cgarryZA/deepJFET/paper/CoverPage.tex

\begin{titlepage}
\centering
\vspace*{1cm} % Adds vertical space

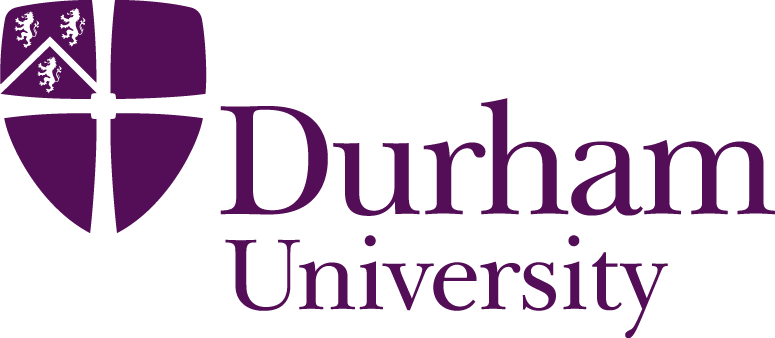
[picture p1: paper/logo.png]
 % Adjust the size as needed

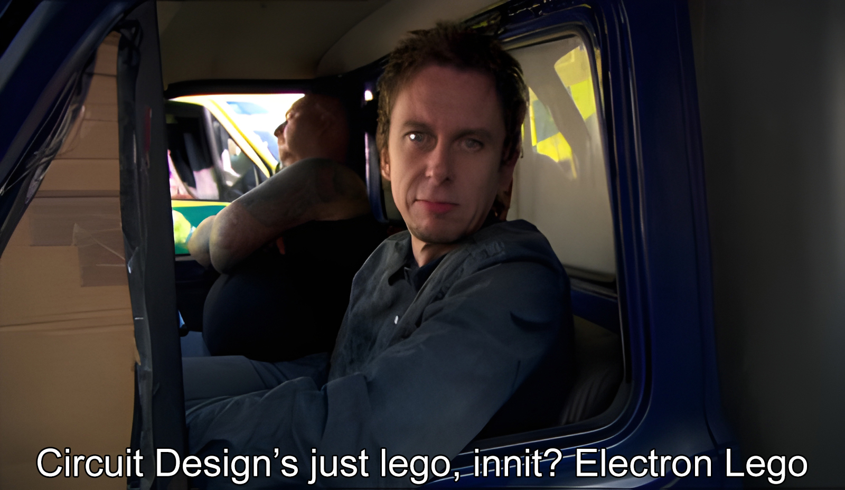
[picture p2: paper/CoverImage.jpg]


\vspace{1cm}

{\Large\bfseries Enduring the Void and Inferno: Computing for Hostile Environments\par} % Title

\vspace{1.5cm} % Space before the author name

{\large Christian Timothy Thomas Garry\par} % Author name

\vspace{1cm} % Space before the degree

{\large Masters Of Engineering (MEng)\par} % Degree

\vspace{1cm} % Space before the university name

{\large University of Durham\par} % University name

\vspace{1cm} % Space before the date

{\large April 2024\par} % Date

\end{titlepage}
