cgarryZA/deepJFET/paper/data/trace_diff_FloatingPoint.tex

% Auto-generated by tools/verify_micro5.py --program FloatingPoint
\begin{table}[t]
\centering
\caption{Direct ISA-rule verification of the LTspice CPU trace for the FloatingPoint program. For every instruction boundary the observed (pre, IR, post) triple is checked against the documented 4004 semantics; \emph{CY artefact} marks failures explained by a one-sample CY-input glitch at the pre-sample point.}
\label{tab:trace-diff-floatingpoint}
\begin{tabular}{@{}lrrrl@{}}
\toprule
Program & Instructions checked & Passing & First failure & End state \\
\midrule
FloatingPoint & 454 & 454 & -- & \textbf{matched} \\
\bottomrule
\end{tabular}
\end{table}
