cgarryZA/deepJFET/paper/data/trace_diff_FloatingPoint_macros.tex

% Auto-generated by tools/verify_micro5.py --program FloatingPoint
\renewcommand{\TraceCyclesFloatingPoint}{454}
\renewcommand{\TraceDivergencesFloatingPoint}{0}
