cgarryZA/deepJFET/paper/data/transistor_count.tex

% Auto-generated by tools/count_transistors.py -- do not edit by hand.
\begin{table}[t]
\centering
\caption{Transistor count of the SiC JFET 4004-compatible processor, per subsystem at full capacity (all sixteen scratch-pad registers and three stack levels included). Numbers are derived directly from the LTspice schematics referenced by \texttt{cpus/4004/config.py}; re-running \texttt{tools/count\_transistors.py} regenerates this table from the current schematic state.}
\label{tab:transistor-count}
\begin{tabular}{@{}lrrr@{}}
\toprule
Subsystem & JFETs & \% of total & Resistors \\
\midrule
Arithmetic logic unit & 566 & 10.2\% & 504 \\
Instruction register & 680 & 12.3\% & 642 \\
Micro-instruction decoder & 877 & 15.8\% & 675 \\
Control logic & 28 & 0.5\% & 24 \\
External pins and bus & 140 & 2.5\% & 159 \\
Program counter & 503 & 9.1\% & 429 \\
Step counter & 363 & 6.6\% & 351 \\
Scratch pad ($16\times 4$-bit) & 1563 & 28.2\% & 1230 \\
Subroutine stack (3-level) & 817 & 14.8\% & 693 \\
\midrule
\textbf{Total} & \textbf{5537} & \textbf{100.0\%} & \textbf{4707} \\
\bottomrule
\end{tabular}
\end{table}
