cgarryZA/deepJFET/paper/data/transistor_count_macros.tex

% Auto-generated by tools/count_transistors.py -- do not edit by hand.
\newcommand{\TotalJFETCount}{5537}
\newcommand{\TotalResistorCount}{4707}
\newcommand{\JFETCountALU}{566}
\newcommand{\ResistorCountALU}{504}
\newcommand{\JFETCountIR}{680}
\newcommand{\ResistorCountIR}{642}
\newcommand{\JFETCountMI}{877}
\newcommand{\ResistorCountMI}{675}
\newcommand{\JFETCountCont}{28}
\newcommand{\ResistorCountCont}{24}
\newcommand{\JFETCountPin}{140}
\newcommand{\ResistorCountPin}{159}
\newcommand{\JFETCountPC}{503}
\newcommand{\ResistorCountPC}{429}
\newcommand{\JFETCountCounter}{363}
\newcommand{\ResistorCountCounter}{351}
\newcommand{\JFETCountScratch}{1563}
\newcommand{\ResistorCountScratch}{1230}
\newcommand{\JFETCountStack}{817}
\newcommand{\ResistorCountStack}{693}
