cgarryZA/deepJFET/paper/supplementary/AppendixA.tex

\begin{figure}[h]
    \centering
    
    \caption{Experimental and simulated NOR gate output voltage at 50 kHz Shifted by 1.5 V. The gate input voltages have been scaled and offset to the top of the diagram.}
    \label{fig:enter-label}
\end{figure}

\begin{figure}[h]
    \centering
    
    \caption{Experimental and simulation NOR gate output voltage at 400 kHz Shifted by 1.5 V. The gate input voltages have been scaled and offset to the top of the diagram.}
    \label{fig:enter-label}
\end{figure}

\begin{figure}[h]
    \centering
    
    \caption{Experimental and simulation NOR gate output voltage at 800 kHz Shifted by 1.5 V. The gate input voltages have been scaled and offset to the top of the diagram.}
    \label{fig:enter-label}
\end{figure}

\begin{figure}[h]
    \centering
    
    \caption{Experimental and simulation NAND gate output voltage at 2 Hz Shifted by 1.5 V. The gate input voltages have been scaled and offset to the top of the diagram.}
    \label{fig:enter-label}
\end{figure}

\begin{figure}[h]
    \centering
    
    \caption{Experimental and simulation NAND gate output voltage at 400 kHz Shifted by 2 V. The gate input voltages have been scaled and offset to the top of the diagram.}
    \label{fig:enter-label}
\end{figure}

\begin{figure}[h]
    \centering
    
    \caption{Experimental and simulation NAND gate output voltage at 1 MHz Shifted by 2 V. The gate input voltages have been scaled and offset to the top of the diagram.}
    \label{fig:enter-label}
\end{figure}
