cgarryZA/deepJFET/paper/supplementary/AppendixD.tex

Full page circuit diagrams of CPU sub-systems as described in \ref{CPUDes}.
\begin{figure*}
    \centering
    
    \caption{Circuit diagram of the arithmetic logic unit}
    \label{fig:enter-label}
\end{figure*}

\clearpage
\begin{figure*}
    \centering
    
    \caption{Circuit diagram of the Instruction Register}
    \label{fig:enter-label}
\end{figure*}

\clearpage
\begin{figure}
    \centering
    
    \caption{Circuit diagram of the Step Counter}
    \label{fig:enter-label}
\end{figure}

\begin{figure}
    \centering
    
    \caption{Circuit diagram of the Program Counter}
    \label{fig:enter-label}
\end{figure}

\clearpage
\begin{figure*}
    \centering
    
    \caption{Circuit diagram of the Stack}
    \label{fig:enter-label}
\end{figure*}

\clearpage
\begin{figure*}
    \centering
    
    \caption{Circuit diagram of the Scratch Pad}
    \label{fig:enter-label}
\end{figure*}

\clearpage
\begin{figure*}
    \centering
    
    \caption{Circuit diagram of the Pins}
    \label{fig:enter-label}
\end{figure*}

\clearpage
\begin{figure*}
    \centering
    
    \caption{Circuit diagram of the computational part of the ROM}
    \label{fig:enter-label}
\end{figure*}
