cgarryZA/deepJFET/paper/precedent/MEng_FYP.pdf

> M.ENG RESEARCH PROJECT APRIL 2024 < | 1

# Enduring the Void and Inferno: Computing for Hostile Environments

## Christian Garry supervised by Professor Alton Horsfall

Abstract—The aim of this paper was to investigate the use of Silicon Carbide Junction Field Effect Transistors to produce radiation resistant computers that can operate at temperatures exceeding 500 ◦C. This is the first demonstration of a full 4-bit microprocessor in Silicon Carbide. The architecture was based on the Intel 4004. The device was designed to be as close to the original Intel 4004 in functionality as possible and use the same instruction set. The aim was for programs written for the Intel 4004 to be able to run without changes to the code. The device was simulated using LTSpice along with other supporting software. The simulated device was able to run complex programs such as multiplying two 16-bit floating point numbers. Physical logic gates were built following circuit diagrams from this report and compared to the simulated results with good agreement in overall waveform shape leading to confidence in the simulated results produced by the CPU as a whole.

Index Terms—Silicon Carbide (SiC), Junction Field Effect Transistors (JFETs), Radiation-Resistant Computers, High-Temperature Electronics, Intel 4004 Architecture, Circuit Simulation, Logic Gates

I. INTRODUCTION
T

HE Intel 4004 microprocessor, recognised as the first general-purpose programmable processor, marked a significant milestone in the development of modern computing. This CPU is characterised by its simplicity: it features sixteen 4-bit working memory locations, known as the Scratch Pad, and two arithmetic logic unit (ALU) registers, the Accumulator and Temporary Registers. The 4004 has a limited instruction set of only 46 instructions [1]. The ALU can only perform addition and bit shifts left or right, subtraction is performed by taking the 2’s complement of the temporary register before it is added to the accumulator. The 4004 has a 3-level stack allowing subroutines up to 3 layers deep. The 4004 also has some conditional jump logic allowing for loops and some basic iterative routines. The program counter is 12 bits, the first 4 indicate the read only memory (ROM) chip (Intel 4001) that has been selected and the next 8 bits indicate the address in that specific chip. This means that each 4001 is 256x8 bits [2] and the 4004 can natively address 16 distinct ROMs. The 4004 also has 4 memory control (CM-RAM) pins which are used to address a specific random-access memory (RAM) chip (Intel 4002). Unlike the ROM, each CM-RAM pin is dedicated to one RAM chip as the RAM only has 1 CM-RAM pin [2]. This can be increased by using a 4-to-16 decoder between the 4004 and RAM chips, allowing full use of the address space. For devices to operate at temperatures greater than 400 ◦C a larger bandgap is needed compared to room temperature devices. Standard devices use Silicon which has a bandgap of 1.12 eV [3]. Silicon Carbide (SiC) is being investigated as it has a much larger bandgap than Silicon, 6H-SiC has a bandgap of 2.9 eV and 4H-SiC has a bandgap of 3.26 eV [4]. A further strength of Silicon Carbide as a material compared to Silicon is its increased radiation-hardness. SiC has a high threshold energy for atomic displacement (24 eV for C and 66 eV for Si [5], compared to 21 eV in Si [6] and 50 eV for diamond [7]). The charge collection efficiency (CCE) of n-type SiC Schottky barrier diodes has been measured and shows no deviation from linear behavior if irradiated with protons [8], electrons [9], or other light ions [10]. This makes SiC eminently suitable for a variety of applications such as fusion reactors or for off-world environments.
JFETs are being investigated since they use a buried p-n junction and not a Schottky barrier. This is important because a metal/semiconductor interface, as found in metal semiconductor field effect transistors (MESFET), degrades at elevated temperatures making them unsuitable for extreme conditions [11]. SiC JFETs have been shown to operate at above 600 ◦C
[12] with the main degradation being interdiffusion of the metal ohmic contacts. These JFETs use a buried gate struc-ture, however this leads to excess access resistance and gate capacitance which limits the applications in several ways. This means that brand new logic gate designs must be created to utilise these JFETs optimally. Logic gates built from SiC JFET devices have been shown to operate at 600 ◦C. The limits of these devices currently are not the wafer itself but the ohmic contacts which are subject to degradation [13]. It is difficult to test improvements as the probes used to electrically test the devices are themselves degrading at these temperatures. Complimentary JFET (CJFET) logic gates have been tested at 623 K [14]. The graphs show degradation of the output voltage at higher temperatures and that the output voltage swing is less than the input voltage swing. This has the potential to cascade when used as an input to a further logic gate, until the output voltage is not recognised reliably as a high or low signal. CJFET 4H-SiC logic gates have been simulated [15]. The data from these simulations indicates that the noise threshold increases as temperature increases, however, the propagation delay is much lower at higher temperatures, 50 ns compared to 10 ns at 1.75 V supply voltage for 27 ◦C and 500 ◦C respectively. The data also indicates that the maximum switching frequency increases as temperature increases going from 2 MHz to 10 MHz. However, the logic gates in this paper utilise resistor-transistor logic (RTL) rather than CJFET logic. This is because CJFET logic requires both p-type and n-type transistors in order to build gates. Due to only using n-type JFETs, RTL had to be used over the more commonly used complimentary logic. This does however suit the project well as the original Intel 4004 also used RTL.
This paper describes the most complex digital circuit built from SiC JFETs and is organized as follows. Section II, describes the basic information of the logic primitives and the decomposition of the 4004 into smaller sub-systems. Section III, describes the design method used to build the circuits for these sub-systems and the testing process used to validate them. The results of the simulated programs and physical logic gates built in the lab are presented in Sec. IV. Finally, Sec.V concludes this paper with a discussion of key findings and directions for future research.

II. THEORY

A. Logic Primitives
The LTSpice model of the JFET was used to create a logic primitive. This was extended to form more complex Logic Gates. Applying a voltage to the Gate of a JFET causes the depletion region to increase. This narrows the conducting channel increasing the resistance, which decreases the current that can pass through it. If the source of the JFET is connected to a voltage source through a resistor there will then be a change in voltage at the JFET’s source when a voltage is applied to the Gate. This does not provide a large enough voltage swing between high and low and has implications for the fan out of the gate. Therefore, a voltage follower was used which works as a voltage level shifter and shifts the output voltage back to input levels of the logic gate (High: -0.8 V, Low: -3.6 V). These values were selected as they kept the output voltage from decaying or oscillating when used as inputs for subsequent gates whilst using standard resistor values.
The design of more complex gates follows on logically from this (Figure 1). To design the NOR gate a second JFET can be connected to the voltage follower in parallel with the first JFET which provides two inputs both with equal function. This means that if either JFET has a voltage applied, the output of the logic gate is the same. The NAND gate was developed using similar reasoning. If both inputs are required to be on to turn the output off, connecting two JFETs in series to the voltage follower will require that both JFETs are sinking current for the output to change. Condensed boolean gates are gates that have an entire Boolean expression compressed into a single gate in order to optimise the number of transistors

VDD

VSS

A

_A

VDD

VSS

A

!(A • B)

B

VDD

VSS

A

!(A + B)

B

Fig. 1: Circuit diagrams of NOT, NAND, and NOR gates respectively

VDD

VSS

A

!((A•B)+C)

B

C

VDD

VSS

!((A•B)+C)

C

VDD

VSS

A

B

Fig. 2: Circuit diagram of a condensed boolean gate (Left) and a combination of base gates (Right), illustrating the transistor reduction for the boolean equation (A AND B) NOR C

used (Figure 2). For example having a NOR gate but with one of the NOR input JFETs having a second JFET between it and ground provides the same effect as having (A AND B) NOR C whilst saving two JFETs. This was common in integrated circuits in the past [16].
NAND and NOR gates were built in the lab and compared to the simulated devices. They were characterised from 1 Hz up to a maximum of 1 MHz. The results were found to mostly agree with the simulations, showing some differences in voltage levels. These results will be discussed further in Sec. IV.
B. CPU Design

The Intel 4004 can be decomposed into several distinct sub-systems. The arithmetic logic unit (ALU), the instruction register and decoding, the stack and program counter (PC), the Scratch Pad, and the circuits related to the pins and interfacing with other external components. The specific instructions re-lating to each sub-system were evaluated in detail to precisely match the functionality of the original Intel 4004.
1) ALU: From the architecture diagram (Figure 3) it can be seen that the ALU (Figure 4) has two 4-bit registers connected to it, the Accumulator (Acc) and the Temporary (Temp) register. From the instruction set it can be seen that the ALU consists only of a 4-bit adder. The contents of the accumulator can also be shifted to the left or right by one bit, however it also includes the carry flag in this shift operation. For example, shifting right would place the least significant bit of the accumulator into the carry and what was in the carry into the most significant bit of the accumulator. Based on the instruction set it can be deduced that there is no inverter on the accumulator and that for subtraction and the other inversion instructions, for example complement accumulator (CMA), there must be an inverter between the temporary register and its connections to the bus and adder. CMA is then accomplished by transferring the value from the Accumulator to the Temp register, inverting the Temp register and transferring this inverted value back to the Accumulator. The carry flag also needs to be able to be inverted. There is a separate incrementer circuit which adds one to the temporary register. This is because the instruction Increment (INC), increments the value stored in a specific Scratch Pad register without effecting the accumulator or the carry flag of the

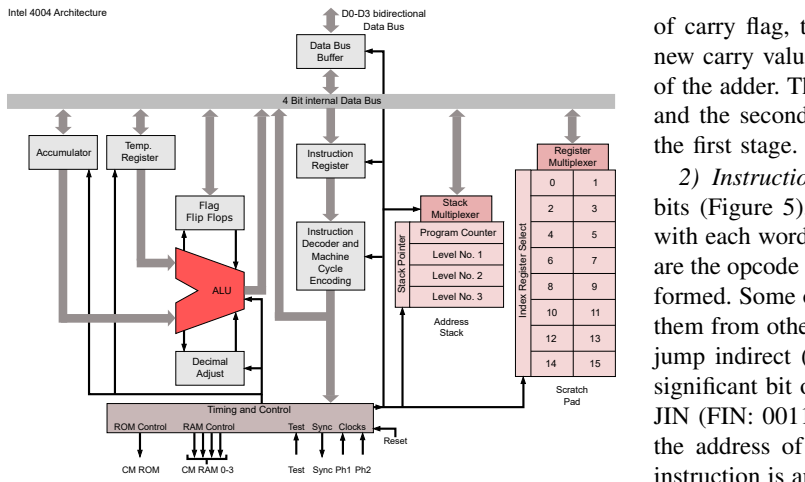
[picture p16: figure]
Instruction Register; Accumulator; Temp.; Register; Flag Flip Flops; Data Bus Buffer; ALU; Decimal Adjust; Instruction Decoder and Machine Cycle Encoding; Register Multiplexer; Index Register Select; Program Counter; Level No. 1; Level No. 2; Level No. 3; Stack Pointer; Stack Multiplexer; Timing and Control; ROM Control; RAM Control; Reset; Test Sync Clocks; CM ROM; CM RAM 0-3; Test Sync Ph1 Ph2; Address Stack; Scratch Pad; 4 Bit internal Data Bus; Intel 4004 Architecture; D0-D3 bidirectional; Data Bus; the first stage.

Fig. 3: Architecture of the Intel 4004 [17] showing the layout of registers and connections between CPU sub-systems

ALU. There is not enough time in the execute portion of the instruction cycle for the accumulator value to be moved to some intermediate location to be moved back after the increment instruction is completed. This means that there has to be a separate circuit for incrementing Scratch Pad registers. There was a race condition caused by the carry and accumulator not saving their new values at the same time. This lead to a scenario where the sum was saved to the accumulator, passed through the adder again and updated the carry before the signal to save to the carry went low. This resulted in uncertainty as to whether or not the value saved in the carry register was that of the original sum operation or the carry from the sum output added to the temporary register again. This issue also occurred if the carry was saved first leading to the sum output being unreliable. The solution to this was to have two stages

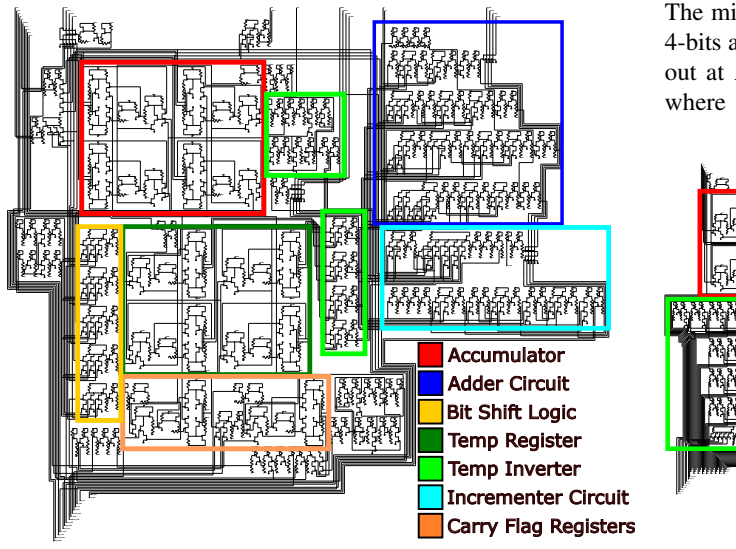
[picture p17: figure]
VDD; VSS; Temp_INV; VDD VDD VDD; Acc_Load; Acc_Out; CF_Out; Temp_Load; CF_Bus_Load; CFStage1_Load; Shift_Enable; Shift_Direction; CF_Load; Temp_Out; CF_INV; CF_Clear; EO_Out; ISZ_False; ISZ_True; Inc_Out; Bus3; Bus2; Bus1; Bus0; Bus3In; Bus2In; Bus1In; Bus0In; Acc9; !Acc9; CLK; TestPin; !2Acc; 2Acc; Adder Circuit; Accumulator; Temp Register; Carry Flag Registers; Bit Shift Logic; Temp Inverter Incrementer Circuit; IR1_Load; IR2_Out; IR4_Load; BBL; IR2_Load; IR3_Out; IR3_Load; IR4_Out; LDM; RAMSignals; NOP; JCN; FIM; FIN; JIN; SRC; JUN; JMS; INC; ISZ; ADD; SUB; XCH; ControlSignals; IAC; CMC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

Fig. 4: Circuit diagram for the Arithmetic and Logic Unit with colour-coded sub-circuits

of carry flag, the first flip-flop would be loaded to store the new carry value without effecting the value seen on the input of the adder. Then the sum could be stored to the accumulator and the second stage of the carry flag could be loaded from

2) Instructions: The instruction register of the 4004 is 16-bits (Figure 5). Instructions can be either one or two words, with each word being 8-bits. The first 4-bits of any instruction are the opcode which specifies the instruction that is being performed. Some opcodes require the second 4-bits to distinguish them from other opcodes. For example the difference between jump indirect (JIN) and fetch indirect (FIN) is that the least significant bit of the lower first word is a 0 for FIN and 1 for JIN (FIN: 0011 RRR0, JIN: 0011 RRR1, where R represents the address of a Scratch Pad register pair). The rest of the instruction is an operand which specifies either the data or the location for the instruction to act upon. The most significant 8-bits must therefore be de-multiplexed to create a control signal telling the CPU which instruction is being executed. The CPU executes instructions by activating sub-system control lines in a specific order. This means the CPU needs to know both what step it is on in the instruction and what control lines need to be activated for each step. The list of control lines that need to be activated on each clock cycle are known as micro-instructions (Figure 6). This is done using a micro-instruction step counter (Figure 7) and an AND gate for each step of each instruction. These will only have a logical high output when the CPU is executing that particular instruction and is on that specific step, allowing the CPU to execute the micro-instructions in the correct sequence to correctly perform the functionality required by the instruction. The micro-instruction steps are broken down into distinct phases. A1, A2, and A3 are the first step of the fetch portion of the fetch, decode, execute cycle. This is when the address is sent from the CPU onto the external bus for any chips connected to it to read. The order in which the address is sent out is important as the ROM and RAM will expect a certain format for the address. The middle order 4-bits are sent out at time A1, the low order 4-bits are sent out at time A2 and the high order 4-bits are sent out at A3. The next step of the fetch portion is M1 and M2 where the CPU receives back 8-bits of data from the ROM.

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
VDD | VDD
VSS | VSS

Jumping

VDD

VSS

!2Word

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
VDD | VDD
VSS | VSS

VDD

VSS

VDD | VDD
VSS | VSS
VDD | VDD
VSS | VSS
VDD | VDD
VSS | VSS
VDD | VDD
VSS | VSS
VDD | VDD
VSS | VSS
VDD | VDD
VSS | VSS
VDD | VDD
VSS | VSS
VDD | VDD
VSS | VSS
VDD | VDD
VSS | VSS

VDD

VSS

VDD | VDD
VSS | VSS
VDD | VDD
VSS | VSS

CLB

VDD | VDD
VSS | VSS
VDD | VDD
VSS | VSS

CLC

VDD | VDD
VSS | VSS
VDD | VDD
VSS | VSS
VDD | VDD
VSS | VSS
VDD | VDD
VSS | VSS
VDD | VDD
VSS | VSS
VDD | VDD
VSS | VSS
VDD | VDD
VSS | VSS
VDD | VDD
VSS | VSS
VDD | VDD
VSS | VSS
VDD | VDD
VSS | VSS
VDD | VDD
VSS | VSS
VDD | VDD
VSS | VSS
VDD | VDD
VSS | VSS
VDD | VDD
VSS | VSS
VDD | VDD
VSS | VSS
VDD | VDD
VSS | VSS
VDD | VDD
VSS | VSS
VDD | VDD
VSS | VSS
VDD | VDD
VSS | VSS
VDD | VDD
VSS | VSS
VDD | VDD
VSS | VSS
VDD | VDD
VSS | VSS
VDD | VDD
VSS | VSS
VDD | VDD
VSS | VSS
VDD | VDD
VSS | VSS
VDD | VDD
VSS | VSS
VDD | VDD | VDD
VSS | VSS
VDD | VDD
VSS | VSS
VDD | VDD
VSS | VSS

WR

VDD | VDD
VSS | VSS

RD

VDD | VDD
VSS | VSS

Bus3
Bus2
Bus1
Bus0

Bus3
Bus2
Bus1
Bus0

Bus3
Bus2
Bus1
Bus0

!CF

CF

AN

AZ

!TestPin

TestPin

Bus3In
Bus2In
Bus1In
Bus0In

Bus3In
Bus2In
Bus1In
Bus0In

Bus3In
Bus2In
Bus1In
Bus0In

Instruction Registers 1-4

IR Multiplexers
Instruction Decoders

Fig. 5: Circuit diagram for the Instruction Register with colour-coded sub-circuits

ADD Instruction

Output
Instruction
Register
2 to the
Bus
Load
ScratchPad
Index Reg
from the
Bus

Output
ScratchPad
Addressed
to the
Bus
Load
Temporary
Register
from the
Bus

Output
Adder Sum
to the
Bus

Load
Acc
Register
from the
Bus

Increment
Program
Counter

Reset
Micro
Instruction
Step
Counter
Address
ScratchPad
Individually
using low
order bit

Load
Second
Stage of
Carry
X1 | X2 | X3

Fig. 6: Diagram showing the control lines that need to be activated per step to execute the ADD instruction

The Intel 4001, in order to decrease complexity and therefore transistor count, has no way to store 16-bit instructions in one ROM address. After the first 8-bits are received from the ROM, if an instruction is detected that requires a further 8-bits of data there is a flip-flop on the CPU that is toggled and the program counter is incremented. The flip-flop being toggled means that when the CPU goes through the next fetch cycle (A1,2,3, M1,2) it will place the new values into the lower word of the instruction register. The CPU then has all 16-bits stored in the instruction register ready to execute. The execute portion is denoted as X1, X2, and X3. This is where the instruction is executed by manipulating the control lines of the CPU.
3) Program Counter and Stack: The Program Counter (PC) (Figure 8) consists of a 12-bit register and an incrementing circuit. The PC also needs to be able to write values to and from the Bus. The conditional jump (JCN) instruction indicates that each 4-bits in the PC need to be individually controlled as the high order 4-bits are not changed when JCN is performed. The limit of three micro-instruction steps for executing instructions means that the stack (Figure 9) has to have a direct connection to the PC as all 12-bits need to be written, along with additional steps related to the stack level control, within three clock pulses. This is not possible with the 4-bit bus unless the PC and Stack have a direct connection. The stack is three layers deep and needs to keep track of which level it is on. This is done using a shift register which is able to be shifted up and down to select each level. The output of each register of the stack is fed into an AND gate along with the level control line that corresponds to it so that the register only outputs when its level is selected and the "Output Stack" control line is enabled.
4) Scratch Pad: The 4004 has sixteen 4-bit registers it can use as general purpose memory. This is so that it is able to perform basic functions without the need for any external Micro_Reset

VDD

VSS

VDD | VDD
VSS | VSS
VDD | VDD
VSS | VSS

VDD

VSS

VDD | VSS | VDD | VSS | VDD | VSS | VDD | VSS | VDD | VSS | VDD | VSS | VDD | VSS | VDD | VSS | VDD | VSS

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

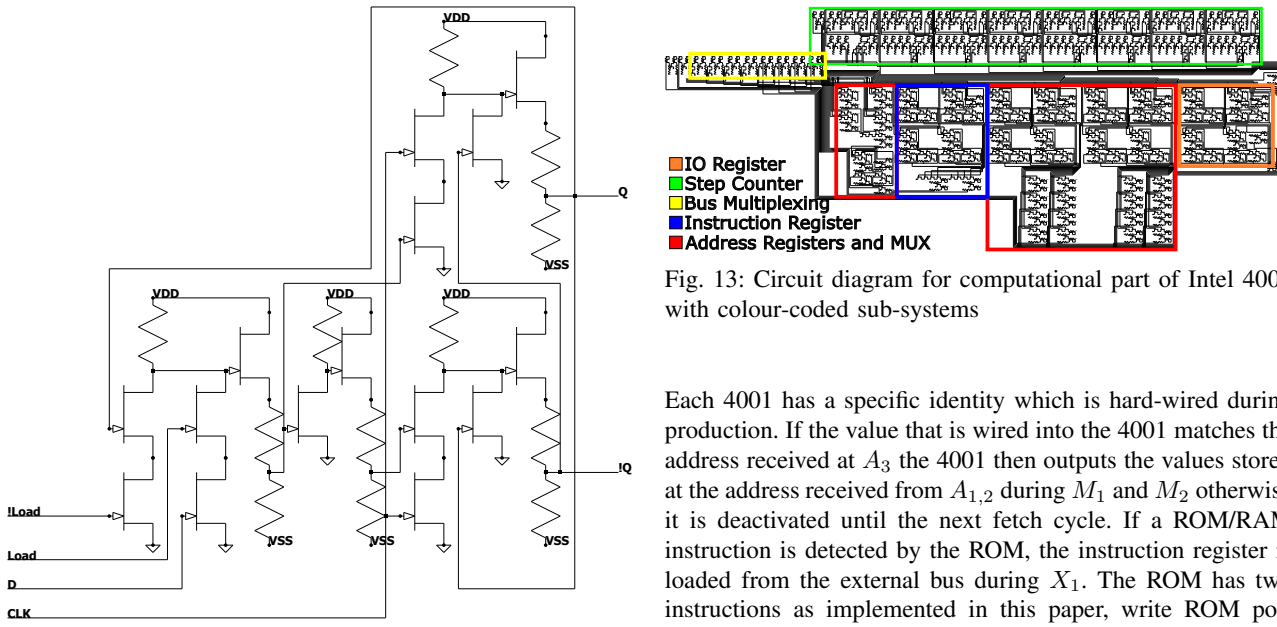
[picture p18: figure]
VDD; VSS; Load; !Load; CLK; VDD VSS VDD VSS; VDD VSS VSS; VDD VDD VSS VSS; VDD VSS; ROM_Mid1_3; ROM_Mid1_2; ROM_Mid1_1; ROM_Mid1_0; Address Registers and MUX; Step Counter; IO Register; Instruction Register; Bus Multiplexing; with colour-coded sub-systems

Fig. 12: Circuit diagram for synchronous D-type flip-flop with transistor reductions using combined boolean logic gates

order to decrease simulation times. The system was tested using the following method. Each control line was connected to a voltage source utilising a Piecewise linear (PWL) file. A PWL file is a type of file used by LTSpice which specifies the voltage at specific time points. Each control line was listed in a spreadsheet along with register values if appropriate. The necessary voltage level for each control line was then plotted on a timeline to "program" the circuit to perform operations. The PWL files were then generated using Matlab from the list of times the control line needed to be high. The final state of the sub-system could then be compared to the expected state calculated from the spreadsheet. Once each sub-system had been verified as correctly functioning they were assembled into the full CPU by means of a Python script which collated each sub-system and renamed any duplicated component names. This was then tested by connecting the Bus to voltage sources and emulating the ROM by feeding it data when it expected to receive data from the ROM. This allowed the majority of the testing to be completed but did not allow for testing more complex programs or anything that required a "decision" to be made by the CPU as every bit of data received by the CPU had to be hard-coded beforehand.

A. ROM
In order to fully test the capabilities of this CPU it was decided that a ROM needed to be designed and built (Figure 13). The 4001 functions in a similar way to the 4004. It uses a micro-instruction counter to see where it is in the instruction cycle and also has an instruction register which is used for some ROM specific instructions. The ROM receives an address from the CPU at times A1 and A2. It then receives a chip select address at time A3, which determines which of the 4001 chips is being addressed, along with CM-ROM going high.

VDD

VDD

VSS

VSS

D2 D0 D1 | High Low High Low VSS VDD | LowHigh LowHigh VSS VSS | VDD VDD VSS VDD VSS VDD | VDD VSS VSS | VSS | VDD VDD VDD VSS VSS VDD | VDD VSS VSS | VDD VSS VDD VDD | VDD VSS VSS | VSS VSS | VDD VDD VSS VDD VDD | VDD VSS VSS | VSS VSS | VDD VDD VSS VDD VDD
VSS | VSS VDD VDD VDD VSS VDD VSS VSS | VDD VDD VDD VSS VSS | VDD VDD VDD VSS VSS | VDD VDD VDD VSS VSS | VDD VDD VDD VSS VSS | VDD VDD VDD VSS VSS | VDD VDD VDD VSS VSS | VDD VDD VDD VSS VSS | VDD

VDD

VDD

D3In
D2In
D1In
D0In

ROM_High_1ROM_High_0 ROM_High_3ROM_High_2

ROM_Mid2_1ROM_Mid2_0 ROM_Mid2_3ROM_Mid2_2 | ROM_Low_1ROM_Low_0 ROM_Low_3ROM_Low_2

Micro8

Micro7

Micro6

Micro5

Micro4

Micro3

Micro2

Micro1

Fig. 13: Circuit diagram for computational part of Intel 4001

Each 4001 has a specific identity which is hard-wired during production. If the value that is wired into the 4001 matches the address received at A3 the 4001 then outputs the values stored at the address received from A1,2 during M1 and M2 otherwise it is deactivated until the next fetch cycle. If a ROM/RAM instruction is detected by the ROM, the instruction register is loaded from the external bus during X1. The ROM has two instructions as implemented in this paper, write ROM port (WRR) and read ROM port (RDR) which are used to read and write to the I/O pins on the ROM chip. This is performed during X2 unless no instruction was received during X1 in which case the execution cycle is reset ready for the next address to be received. Storage in the ROM was implemented using a voltage source linked to a PWL file for each bit of every address. When the ROM is addressed the value defined by the PWL file for that address is sent out onto the bus. This was done so that each bit would have a specific PWL file which could be written to, allowing for the ROM to be programmed.

B. Assembler

An assembler converts the mnemonics of the instructions from text to binary and converts the operands from hexadeci-mal or decimal to binary. So FIM 1 0 11 would be converted to 0010 0010 0000 1011. An assembler also handles labels which are used for jumps. When the code comes across text that does not correspond to a known instruction it adds it to the dictionary along with the line that the assembler was on when the unknown text was encountered. Then, once the entire program has been read for a first time, the code makes a second pass. During this second pass every instance of a label is replaced with the binary value of its location in the program, essentially acting as pointers to a specific line in the program. The assembled program is saved as a .bin file and a .hex file. The .bin file is formatted so that each line has 8-bits, which corresponds to the 8-bits that the ROM stores per address. Each line then refers to a specific address in the ROM. The assembler was written in Python.

C. PWL File Generation

The .bin file is used by another python script to generate the PWL files that populate the voltage sources of the ROM. The first bit in the .bin file is read, if it is a 1 the PWL file will have a logical high voltage, if it is a 0 it will have a

Clock Cycles; cim; al Valu

Fig. 14: Figure showing the decimal value in Scratch Pad Register 0 for the operation 11 & 6. This illustrates the first input (11) being shifted left 4 times to compare the highest order bit to the second input (6) with the final result of 2 being loaded in just before 1500 clock cycles

logical low output. The first bit will be saved as 0.txt, bit two will be 1.txt etc. The format of these files is as follows, for logical high: "0u -800m", and for logical low: "0u -3.6". This sets the voltage source to a value of either -0.8 V or -3.6 V permanently unless the text file is changed.

D. Testing and Benchmarking
With a full 4001 and 4004, more complex programs could be run and the outputs of these programs compared between the LTSpice simulated CPU and the CPU that was emulated using JavaScript. One of the programs built was a floating point emulator which allowed the multiplication of a custom implementation of 16-bit floats (Listing 3). This was chosen to allow for astronomical calculations which require a large range of values. Another program that was run was pulled from a contemporary Intel 4004 programming manual [1] and was used for the purpose of performing a logical AND operation. This was able to run without any modifications which is a good indication that the high-level functionality has parity with the original CPU (Figure 14). The results of these computations are discussed further in Section IV.
1) Waveform Value Interpreter: In order to streamline the process of examining the waveform data of the LTSpice simulations on lengthy computations, software was written which extracts the voltage values and processes them. Matlab was used to read through the entire waveform file and search for specific nodes. These nodes were then converted from analogue to digital based on if the voltage was above or below -2.6 V. This was done looking at the average voltage in 5 µs time steps as this is the length of time that the clock is high at 100 kHz. These nodes were then combined into 4-bit numbers, if appropriate, giving each register a 4-bit binary number for each time step.
2) Emulator: An online emulator [18] was referenced during the development of the CPU where quirks such as the incrementer not effecting the accumulator were spotted. However, this emulator had some oversights which were corrected and a version of the emulator which more closely matched the internal architecture of the CPU built in LTSpice was created using HTML and JavaScript. Most of the issues were related to the decoding of instructions and specific jump conditions that

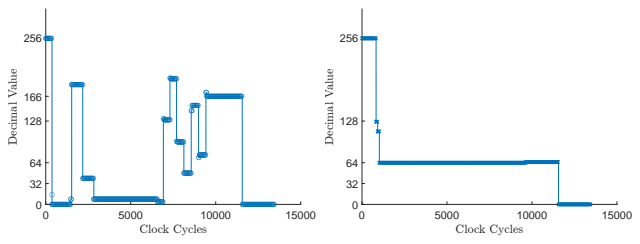
[picture p19: figure]
Clock Cycles; cim; al Valu

(a) Significand which is calculated to be 166 in decimal
(b) Exponent which is calculated to be 65 in decimal

Fig. 15: The waveforms of the registers during the computation of the product of 1.4375 × 3.60937. Plots 15a and 15b show the values of the significand and exponent respectively during the operation

were improperly implemented. A second version of this site was made where the JavaScript for the emulation was removed and the interface was filled with values from the Matlab Waveform Value Interpreter script. This allowed the Emulator and the LTspice model to be compared at every register, step by step for long computations to ensure operational parity.

E. Experimental Validation of Simulation Models
The first two logic gates built using physical JFETs were the NAND and the NOR gate. These were built using a JFET integrated circuit (IC) and a copper circuit board with through-hole components. These were connected to a power supply, a function generator, and an oscilloscope. They were then tested at a range of frequencies from 1 Hz to 1 MHz. The data from this experiment was then used to characterise the gates. The inputs from the function generator were taken and a Matlab script was written to convert these into a PWL file which could then be used as the inputs for the simulated gates to get an exact comparison between experimental and theoretical.

IV. RESULTS AND DISCUSSION

A. Program Testing
1) AND Subroutine: From the MCS4 programming manual an AND sub-routine (Listing 4) was run on the CPU and its results compared to the emulator. Figure 14 shows the functioning of the AND sub-routine. The input A, 1011 (11), is loaded into Scratch Pad register 0 and subsequently shifted left to extract the highest order bit into the carry. This is done four times, from 1011 (11) to 0110 (6) to 1100 (12) to 1000 (8) and the final output value, 0010 (2), is loaded in after roughly 1400 clock cycles. The value starts at 15 as each register defaults to being high when the CPU is first initialised. From the plots we can see that 6 (0110) AND 11 (1011) gives an output of 2 (0010) which is correct.
2) Floating Point Multiplication Subroutine: The floating point system implemented takes the following form.

−1 × signbit × 1.sssssss × 2

eeeeeee−63 | (1)

Where s is a bit of the significand and e is a bit of the exponent. The power of the CPU is demonstrated in the following plots showing the computation 1.4375×3.609375 = 5.18847.

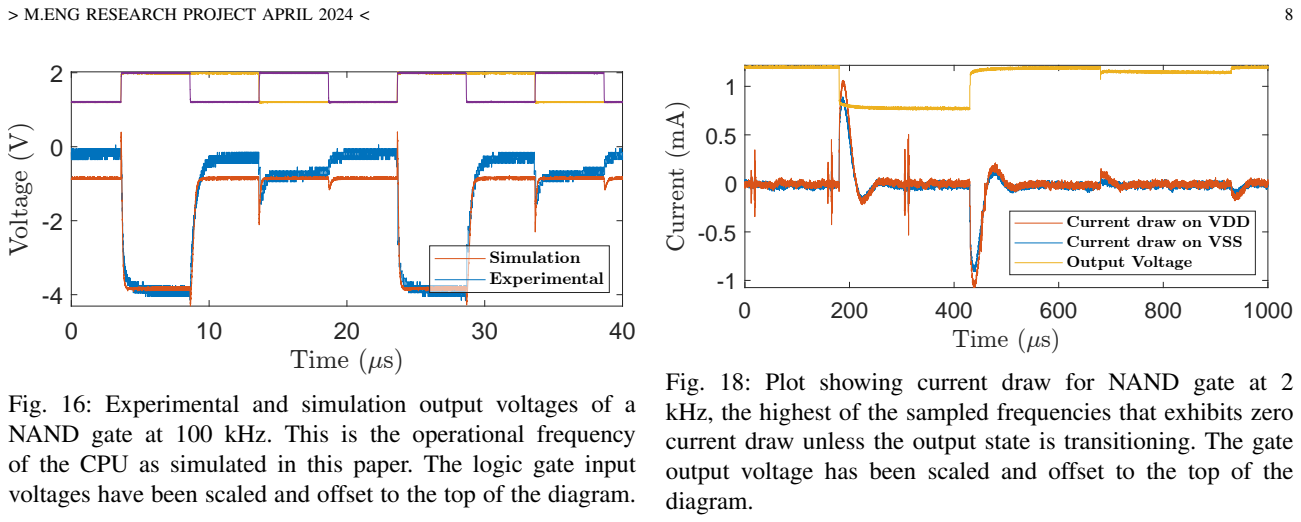
[picture p20: figure]
Time (7s); Volt; Simulation Experimental; Current draw on VDD Current draw on VSS Output Voltage; diagram.

Fig. 16: Experimental and simulation output voltages of a NAND gate at 100 kHz. This is the operational frequency of the CPU as simulated in this paper. The logic gate input voltages have been scaled and offset to the top of the diagram.

Due to limitations in the accuracy of the floating point representation of the numbers they are rounded slightly from their exact values. This is shown in Table I, where the value for the product is rounded from 5.18847 to 5.1875. The majority of the rounding in the multiplication comes from the floating point implementation itself as effort was put into retaining as much accuracy as possible in the algorithm. Explanations of the algorithm can be found in Appendix B. The final values in the registers in Figures 15a and 15b being zero is due to an LTSpice simulation error which occurred after the program had finished running.

B. Experimental Data

The logic gates were tested at a range of input frequencies up to 800 kHz and 1 MHz for the NOR and NAND gate respectively. The key results are at 100 kHz (Figures 16 and
17) and the maximum tested frequency (Figures 21 and 20). These results are important as the CPU was tested at 100 kHz allowing confidence in results obtained from the simulations. The data from the operation at higher frequencies allows predictions about the theoretical top speed of the CPU. The limiting factor is the NOR gate, after 800 kHz the swing of
0 | 10 | 20 | 30 | 40
| | Time (7s)

-6

-4

-2

0

2

Volt

a

g

e (V)

Simulation
Experimental

Fig. 17: Experimental and simulation output voltages of a NOR gate at 100 kHz. This is the operational frequency of the CPU as simulated in this paper. The logic gate input voltages have been scaled and offset to the top of the diagram.

Fig. 18: Plot showing current draw for NAND gate at 2 kHz, the highest of the sampled frequencies that exhibits zero current draw unless the output state is transitioning. The gate output voltage has been scaled and offset to the top of the

TABLE I: Floating Point Number Values Used in Subroutine

Binary | Decimal | Exponential Form | Value
10111000 00111111 | 184 63 | 1.4375 × 2
| | 0 | 1.4375
11100111 01000000 | 231 64 | 1.8046875 × 2
| | 1 | 3.609375
10100110 01000001 | 166 65 | 1.296875 × 2
| | 2 | 5.1875

TABLE II: Register values for Figures 15a and 15b

Clock Cycle | Significand | Exponent | Decimal
0 | 255 | 255 | 1.9921875 × −2

64
370 | 0 | 255 | 0
828 | 0 | 127 | 0
924 | 0 | 112 | 0
1020 | 0 | 64 | 0
1527 | 184 | 64 | 2.875
2178 | 40 | 64 | 0.625
2830 | 8 | 64 | 0.125
6580 | 4 | 64 | 0.0625
6968 | 130 | 64 | 2.03125
7356 | 193 | 64 | 3.015625
7744 | 96 | 64 | 1.5
8128 | 48 | 64 | 0.75
8608 | 152 | 64 | 2.375
9039 | 76 | 64 | 1.1875
9472 | 166 | 64 | 2.59375
9640 | 166 | 65 | 5.1875
0 | 10 | 20 | 30 | 40
| | Time (7s)

-0.5

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
t (m

A)

Current draw on VDD
Current draw on VSS
Output Voltage

Fig. 19: Plot showing current draw for NAND gate at 100 kHz. This is the operational frequency of the CPU as simulated in this paper and shows that the device will always draw current regardless of input states at these frequencies. The gate output voltage has been scaled and offset to the top of the diagram.

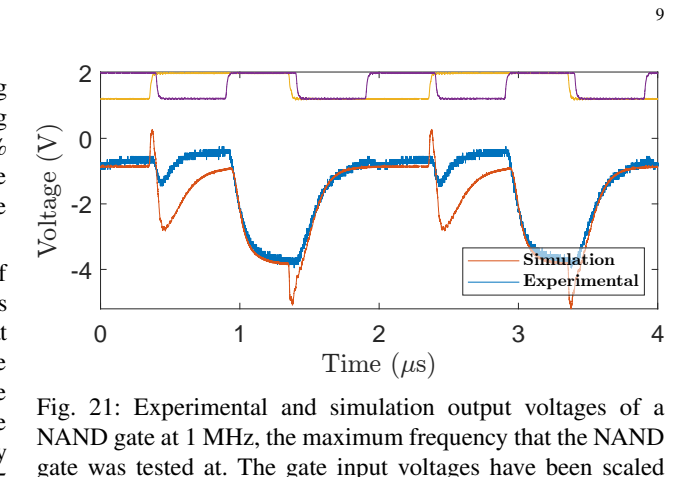
[picture p21: figure]
Time (7s); Volt; Simulation Experimental

the output voltage becomes too slow to react to the changing inputs. This means that a theoretical maximum operating frequency of the CPU can be set at 800 kHz. This is an 8% increase compared to the original 4004 (some sources have the clock speed of the original at 400 kHz which would make this CPU two times faster).
The oscilloscope probes introduced scaling by a factor of two, necessitating post-experimental adjustments. There was a 1.5 - 2 V baseline shift in the data compared to what was expected from the simulations, the origins of which are currently under investigation. Some of the difference was due to resistor inaccuracies, however, this cannot account for the entire 2 V shift. Further, it can be seen that as the frequency increases this offset increases, starting at approximately 1.5 V at 2 Hz going up to approximately 2 V at 100 kHz. This indicates that it is some function of the JFETs themselves. This change in output voltage levels as a function of frequency was only observed in the NAND gate. The NOR gate retained its 1.5 V shift for the entire range of examined frequencies. This could be due to differences in the JFETs used between the NAND and NOR gates rather than due to gate topology. Further investigation into the nature of these discrepancies is necessary to determine their source, be it manufacturing variability or the LTSpice model itself. The voltage levels and resistor values used should be explored in greater depth to determine optimum performance for specific applications. The current draw demonstrated by the NAND gate at lower frequencies displays CMOS like qualities where it is only actively drawing current on the transition between output states as shown in Figure 18. This behaviour was not apparent at higher frequencies as shown in Figure 19. This is an unexpected result and should be investigated further. The current draw on each voltage source (positive supply voltage: 24 V, negative supply voltage: -20 V) was about 0.5 mA per logic gate which consisted of 3 transistors. Extrapolating from this, the peak current draw for the full CPU of 5300 transistors would be about 900 mA. Due to the CMOS like nature of the current draw at lower frequencies, if entire systems of the

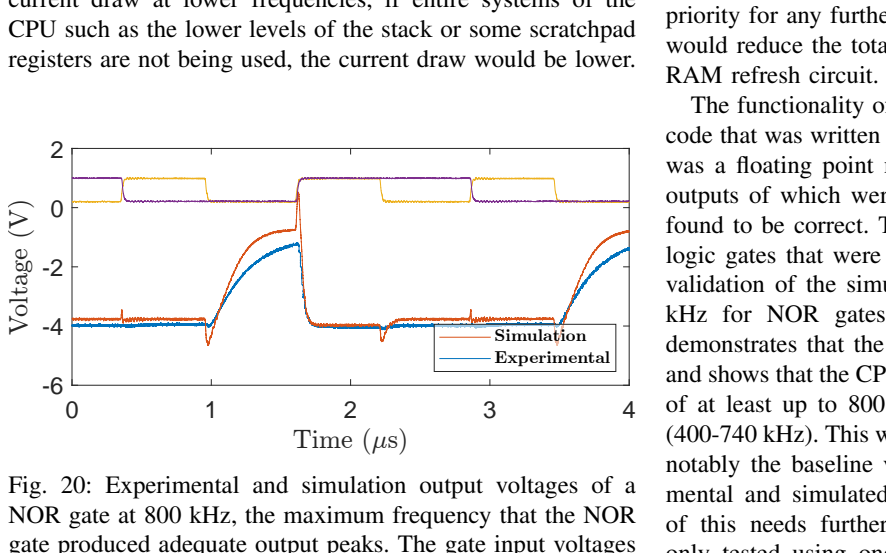
[picture p22: figure]
Time (7s); Volt; Simulation Experimental; RAM refresh circuit.

CPU such as the lower levels of the stack or some scratchpad registers are not being used, the current draw would be lower.

Fig. 20: Experimental and simulation output voltages of a NOR gate at 800 kHz, the maximum frequency that the NOR gate produced adequate output peaks. The gate input voltages have been scaled and offset to the top of the diagram.

Fig. 21: Experimental and simulation output voltages of a NAND gate at 1 MHz, the maximum frequency that the NAND gate was tested at. The gate input voltages have been scaled and offset to the top of the diagram.

V. CONCLUSION
In this paper, the design and implementation of a Silicon Carbide (SiC) Junction Field Effect Transistor (JFET) based computing platform has been successfully demonstrated. The design process was comprehensive, encompassing the design of individual logic gates, the construction of a complete SiC JFET CPU and ROM, and the development of supporting software such as an assembler and waveform analyser. These tools were instrumental in validating the functionality of the SiC CPU against the Intel 4004. Thereby marking a significant step forward in the development of electronics capable of enduring the harsh conditions found in space exploration, nuclear reactors, and other extreme environments.
This CPU consists of 5328 transistors compared to 2300 in the original 4004 and achieves full operational parity at a frequency of 100 kHz. The transistor count increase is due to the original 4004 utilising DRAM which saves considerable transistors compared to the D Flip-Flop storage technology used in this paper. As CPU complexity increases, the number of individual registers also increases. Therefore, developing transistor optimised storage technology should be a high priority for any further research. Development of 1-T DRAM would reduce the total transistor count to 3284 excluding the

The functionality of the CPU was demonstrated by running code that was written for the Intel 4004. The specific code run was a floating point multiplication and a bitwise AND. The outputs of which were all validated against an emulator and found to be correct. The experimental data for the SiC JFET logic gates that were built, delivered promising experimental validation of the simulated models up to frequencies of 800 kHz for NOR gates and 1 MHz for NAND gates. This demonstrates that the LTSpice logic gate models are reliable and shows that the CPU should be able to be run at frequencies of at least up to 800 kHz which is higher than the original (400-740 kHz). This work however, also uncovered challenges, notably the baseline voltage shifts observed between experimental and simulated results for the logic gates. The cause of this needs further investigation as each logic gate was only tested using one JFET IC. This means manufacturing variability could play some role in the differences observed.

As the boundaries of where and how computing can be applied continue to be pushed, the lessons learned and the groundwork laid by this project will undoubtedly contribute to the development of more resilient, efficient, and powerful computing platforms for use in the most challenging environments imaginable.

VI. ACKNOWLEDGEMENTS
I would like to thank Professor Alton Horsfall for encour-aging and inspiring me when I felt like I had been making no progress. I have appreciated his invaluable guidance and constructive feedback. Without him this report would be a lot shorter.

REFERENCES

[1] Intel Corporation, Mcs-4 micro computer set user’s manual, 3065 Bowers Avenue, Santa Clara, California 95051: Intel Corporation, Feb. 1973. [Online]. Available: https://archive.org/details/manualzilla-id-7026262 (visited on 08/01/2023).
[2] Intel Corporation, Intel 4004 family components specifications. [Online]. Available: https : / / deramp . com / downloads / mfe _ archive / 050 - Component % 20Specifications / Intel / Microprocessors % 20and % 20Support/4004%20Family/ (https://deramp.com/downloads/mfe_archive/050-Component%20Specifications/Intel/Microprocessors%20and%20Support/4004%20Family/) (visited on 09/01/2023).
[3] J. Low, M. Kreider, D. Pulsifer, A. Jones, and T. Gilani, “Band gap energy in silicon,” American Journal of Undergraduate Research, vol. 7, Jun. 2008. DOI: https: //doi.org/10.33697/ajur.2008.010. (https://doi.org/https://doi.org/10.33697/ajur.2008.010)
[4] X. Wang, J. Zhao, Z. Xu, et al., “Density functional theory calculation of the properties of carbon vacancy defects in silicon carbide,” Nanotechnology and Preci-sion Engineering, vol. 3, Dec. 2020. DOI: https://doi.org/10.1016/j.npe.2020.11.002. (https://doi.org/https://doi.org/10.1016/j.npe.2020.11.002)
[5] W. Li, L. Wang, L. Bian, et al., “Threshold displacement energies and displacement cascades in 4H-SiC: Molecular dynamic simulations,” AIP Advances, vol. 9, no. 5, p. 055 007, May 2019, ISSN: 2158-3226. DOI: https://doi.org/10.1063/1.5093576. (https://doi.org/https://doi.org/10.1063/1.5093576)
[6] S. Messenger, E. Burke, M. Xapsos, G. Summers, and R. Walters, “The simulation of damage tracks in silicon,” IEEE Transactions on Nuclear Science, vol. 51, no. 5, pp. 2846–2850, 2004. DOI: https://doi.org/10.1109/TNS.2004.835094. (https://doi.org/https://doi.org/10.1109/TNS.2004.835094)
[7] S. Ditalia Tchernij, N. Skukan, F. Picollo, et al., “Elec-trical characterization of a graphite-diamond-graphite junction fabricated by mev carbon implantation,” Diamond and Related Materials, vol. 74, pp. 125–131, 2017, ISSN: 0925-9635. DOI: https://doi.org/10.1016/j. diamond.2017.02.019. (https://doi.org/https://doi.org/10.1016/j.diamond.2017.02.019)
[8] F. Nava, E. Vittone, P. Vanni, et al., “Radiation toler-ance of epitaxial silicon carbide detectors for electrons, protons and gamma-rays,” Nuclear Instruments and Methods in Physics Research, Section A: Accelerators, Spectrometers, Detectors and Associated Equipment, vol. 505, no. 3, pp. 645–655, 2003, Cited by: 105; All Open Access, Green Open Access. DOI: 10.1016/ S0168-9002(02)01558-9. (https://doi.org/10.1016/S0168-9002(02)01558-9)
[9] N. Iwamoto, B. Johnson, N. Hoshino, et al., “Defect-induced performance degradation of 4h-sic schottky barrier diode particle detectors,” Journal of Applied Physics, vol. 113, no. 14, 2013, Cited by: 35; All Open Access, Bronze Open Access. DOI: https://doi.org/10.1063/1.4801797. (https://doi.org/https://doi.org/10.1063/1.4801797)
[10] K. Lee, T. Ohshima, A. Saint, T. Kamiya, D. Jamieson, and H. Itoh, “A comparative study of the radiation hardness of silicon carbide using light ions,” Nuclear Instruments and Methods in Physics Research Section B: Beam Interactions with Materials and Atoms, vol. 210, pp. 489–494, 2003, 8th International Conference of Nuclear Microprobe Technology and Applications, ISSN: 0168-583X. DOI: https : / / doi . org / 10 . 1016 / S0168 -583X(03)01096-6. (https://doi.org/https://doi.org/10.1016/S0168-583X(03)01096-6)
[11] J. Zolper, “A review of junction field effect transistors for high-temperature and high-power electronics,” Solid-State Electronics, vol. 42, no. 12, pp. 2153–2156, 1998, ISSN: 0038-1101. DOI: https://doi.org/10.1016/S0038-1101(98)00210-X. (https://doi.org/https://doi.org/10.1016/S0038-1101(98)00210-X)
[12] P. G. Neudeck, D. J. Spry, M. J. Krasowski, N. F. Prokop, and L. Chen, “Demonstration of 4h-sic jfet digital ics across 1000 °c temperature range without change to input voltages,” in European Conference on Silicon Carbide and Related Materials (ECSCRM 2018), Document ID: 20190027358, NASA Glenn Research Center, University of Warwick, Birmingham, United Kingdom, Jul. 2018. [Online]. Available: https: //ntrs.nasa.gov/citations/20190027358.
[13] P. G. Neudeck, G. M. Beheim, and C. S. Salupo, “600 °c logic gates using silicon carbide jfet’s,” NASA Glenn Research Center, Cleveland, Ohio, NASA Tech-nical Memorandum NASA/TM–2000-209928, 2000. [Online]. Available: https://ntrs.nasa.gov/api/citations/20000033844/downloads/20000033844.pdf. (https://ntrs.nasa.gov/api/citations/20000033844/downloads/20000033844.pdf)
[14] M. Kaneko, M. Nakajima, Q. Jin, and T. Kimoto, “Sic complementary junction field-effect transistor logic gate operation at 623 k,” IEEE Electron Device Letters, vol. 43, no. 7, pp. 997–1000, 2022. DOI: https://doi.org/10.1109/LED.2022.3179129. (https://doi.org/https://doi.org/10.1109/LED.2022.3179129)
[15] H. Habib, “Complementary jfet logic in silicon carbide,” PhD Thesis, Ph.D. dissertation, Newcastle University, Newcastle upon Tyne, UK, 2013. [Online]. Available: http://hdl.handle.net/10443/2233.
[16] K. Shirriff, Reading silicon: How to reverse engineer integrated circuits. [Online]. Available: https://www. youtube . com / watch ? v = aHx - XUA6f9g (https://www.youtube.com/watch?v=aHx-XUA6f9g) (visited on 08/13/2023).
[17] Appaloosa, Intel 4004 architecture, Aug. 21, 2007. [Online]. Available: https://commons.wikimedia.org/wiki/File:4004_arch.svg (https://commons.wikimedia.org/wiki/File:4004_arch.svg) (visited on 06/01/2023).
[18] M. Szyc. “Intel 4004 emulator.” (2007), [Online]. Available: http://e4004.szyc.org/ (visited on 10/01/2023).

0 | 20 | 40 | 60 | 80 | 100

-6

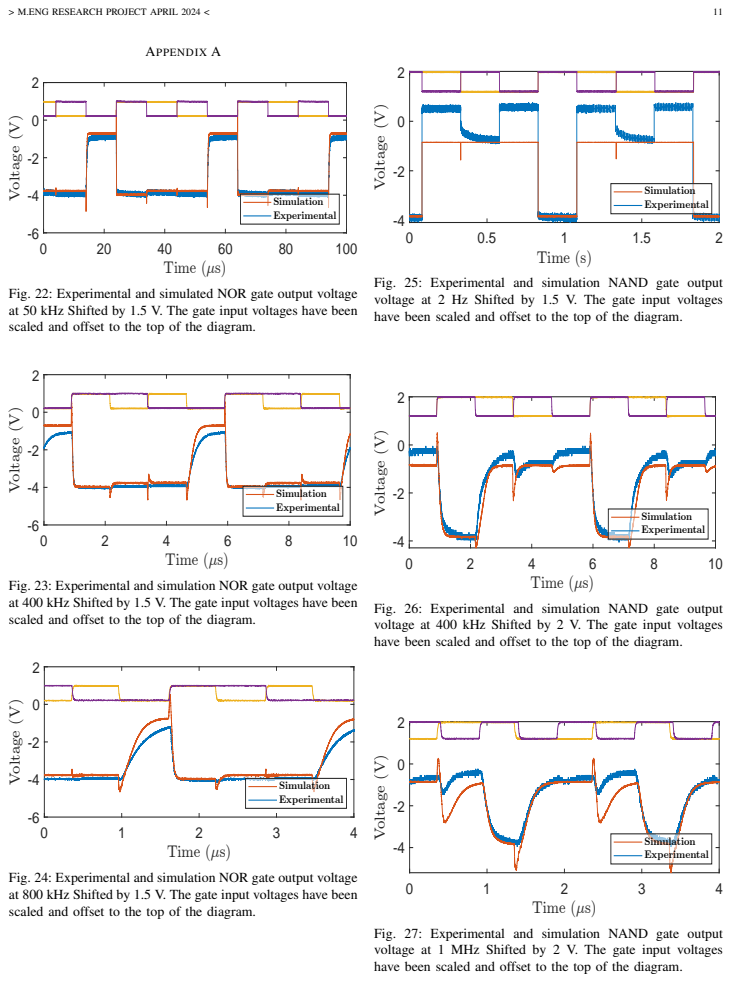
[picture p23: page 11]
APPENDIX A; Time (7s); Volt; Simulation Experimental; Time (s)

Fig. 25: Experimental and simulation NAND gate output
voltage at 2 Hz Shifted by 1.5 V. The gate input voltages
have been scaled and offset to the top of the diagram.

Fig. 22: Experimental and simulated NOR gate output voltage
at 50 kHz Shifted by 1.5 V. The gate input voltages have been
scaled and offset to the top of the diagram.

Fig. 23: Experimental and simulation NOR gate output voltage
at 400 kHz Shifted by 1.5 V. The gate input voltages have been

Fig. 26: Experimental and simulation NAND gate output
voltage at 400 kHz Shifted by 2 V. The gate input voltages

Fig. 24: Experimental and simulation NOR gate output voltage
at 800 kHz Shifted by 1.5 V. The gate input voltages have been

Fig. 27: Experimental and simulation NAND gate output
voltage at 1 MHz Shifted by 2 V. The gate input voltages

APPENDIX B

1 | SIGNBITS CLC
2 | LD 6
3 | RAL
4 | TCC
5 | XCH 2
6 | LD 6
7 | RAL
8 | CLC
9 | RAR
10 | XCH 6
11 | CLC
12 | LD 10
13 | RAL
14 | TCC
15 | XCH 3
16 | LD 10
17 | RAL
18 | CLC
19 | RAR
20 | XCH 10
21 | BBL 0
Listing 1: Assembly Code for SIGNBITS function
1 | START LDM 15
2 | XCH 4
3 | LDM 4
4 | XCH 5
5 | LDM 4
6 | XCH 6
7 | LDM 7
8 | XCH 7
9 | LDM 10
10 | XCH 8
11 | LDM 0
12 | XCH 9
13 | LDM 4
14 | XCH 10
15 | LDM 11
16 | XCH 11
17 | JMS MULT
18 | NOP
Listing 2: Assembly Code for initialising registers for multiplication function

The way the multiplication algorithm (Listing 3) works is two separate computations. First the sign bit is extracted from the exponent using the SIGNBITS Subroutine (Listing 1). Then the two exponents are added together, however this means that the offset of 63 has been added twice and needs to be subtracted to get the final value. Next the significands need to be multiplied. This is achieved by checking the lowest order bit of the multiplier. If it is high, the multiplicand is added to the output register, the multiplicand is shifted to the left and the multiplier is shifted to the right. This then repeats until the entire multiplier has been checked and the final answer can be read. There are some tricks that have been done to preserve accuracy of the final answer such as using 4 registers to store the multiplicand and the product allowing for 16 bits of accuracy. The final step shifts the entire product until it detects that there are no 1s in the two registers used for the highest order bits. If the product is shifted more than 8 times it indicates that the product required normalising, shifting so that there is a 1 in the highest order bit. If this occurs, 1 needs to be added to the exponent for each time the product is shifted past 8 times.

1 | MULT FIM 6 0 0
2 | JMS SIGNBITS
3 | LD 7
4 | ADD 11
5 | XCH 15
6 | LD 6
7 | ADD 10
8 | XCH 14
9 | CLC
10 | LDM 15
11 | XCH 0
12 | LD 15
13 | SUB 0
14 | XCH 15
15 | CMC
16 | LDM 3
17 | XCH 0
18 | LD 14
19 | SUB 0
20 | XCH 14
21 | CLC
22 | LD 2
23 | ADD 3
24 | RAL
25 | RAL
26 | RAL
27 | CLC
28 | ADD 14
29 | XCH 14
30 | FIM 0 0 0
31 | FIM 1 0 0
32 | BCHECK LD 8
33 | JCN 12 IF1
34 | LD 9
35 | JCN 12 IF1
36 | JUN RETURN
37 | IF1 CLC
38 | LD 8
39 | RAR
40 | XCH 8
41 | LD 9
42 | RAR
43 | XCH 9
44 | JCN 10 IF2
45 | CLC
46 | LD 13
47 | ADD 5
48 | XCH 13
49 | LD 12
50 | ADD 4
51 | XCH 12
52 | LD 3
53 | ADD 1
54 | XCH 3
55 | LD 2
56 | ADD 0
57 | XCH 2
58 | IF2 CLC
59 | LD 5
60 | RAL
61 | XCH 5
62 | LD 4
63 | RAL
64 | XCH 4
65 | RAL
66 | LD 1
67 | RAL
68 | XCH 1
69 | LD 0
70 | RAL
71 | XCH 0
72 | JUN BCHECK
73 | RETURN LD 2
74 | JCN 12 IF3
75 | LD 3
76 | JCN 12 IF3
77 | JUN MULTEND
78 | IF3 LD 2
79 | RAR
80 | XCH 2
81 | LD 3
82 | RAR
83 | XCH 3
84 | LD 12
85 | RAR
86 | XCH 12
87 | LD 13
88 | RAR
89 | XCH 13
90 | CLC
91 | JUN RETURN
92 | MULTEND BBL 0
Listing 3: Assembly Code for floating point multiplication subroutine

> M.ENG RESEARCH PROJECT APRIL 2024 < | 13 APPENDIX C
1 | JUN START 2 | AND FIM 1 0 11 3 | Loop LDM 0 4 | XCH 0 5 | RAL 6 | XCH 0 7 | INC 3 8 | XCH 3 9 | JCN 4 Done
10 | XCH 3
11 | RAR
12 | XCH 2
13 | XCH 1
14 | RAL
15 | XCH 1
16 | RAR
17 | ADD
| 2
18 | JUN Loop
19 | Done BBL 0
20 | START LDM 11
21 | XCH 0
22 | LDM 6
23 | XCH 1
24 | JMS AND
25 | NOP
Listing 4: Assembly Code for AND Subroutine

The AND subroutine produces the AND of two input words by placing the bits in the leftmost position of the accumulator 30a and register 2 29a, respectively, and zeroing the rightmost three bits of the accumulator and register 2. Register 2 is then added to the accumulator, and the resulting carry is equal to the AND of the two bits. Scratch Pad register 3 (Figure 29b) is used as the counter, counting up from 11. When this overflows from 15 to 0 the program breaks and returns.

Clock Cycles; cim; al Valu

(a) Scratchpad 0 value, containing the first input word which is shifted left four times. This is the register the function returns the output value to. The shifts are as follows, 1011 to 0110 to 1100 to 1000. The returned value is then placed in and shifted once, 0001 to 0010.
(b) Scratchpad 1 value, containing the second input word which is shifted left three times. The shifts are as follows, 0110 to 1100 to 1000 to 0000.

Fig. 28: Scratchpad Pair 0, the input and output registers.

200 | 400 | 600 | 800 | 1000 1200 1400
Clock Cycles

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
al Valu

e

(a) Scratchpad 2 value, this is working memory for the program. The highest order bit from one input is put into here and added to the accumulator which contains the high order bit from the other input.
200 | 400 | 600 | 800 | 1000 1200 1400
Clock Cycles

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
al Valu

e

(b) Scratchpad 3 value, this is the counter for counting the number of times register 0 has been shifted. This starts at 11 and the program breaks when the value overflows from 15 to 0.

Fig. 29: Scratchpad Pair 1

0 | 500 | 1000 | 1500 | 2000
| | Clock Cycles

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
al Valu

e

(a) Accumulator register value
0 | 500 | 1000 | 1500 | 2000
| | Clock Cycles

0

D

e

cim

al Valu

e

(b) Carry Flag register value, when the highest bit of word one and word two are added together the carry is equal to the AND of the two bits

Fig. 30: Accumulator and Carry Flag register values

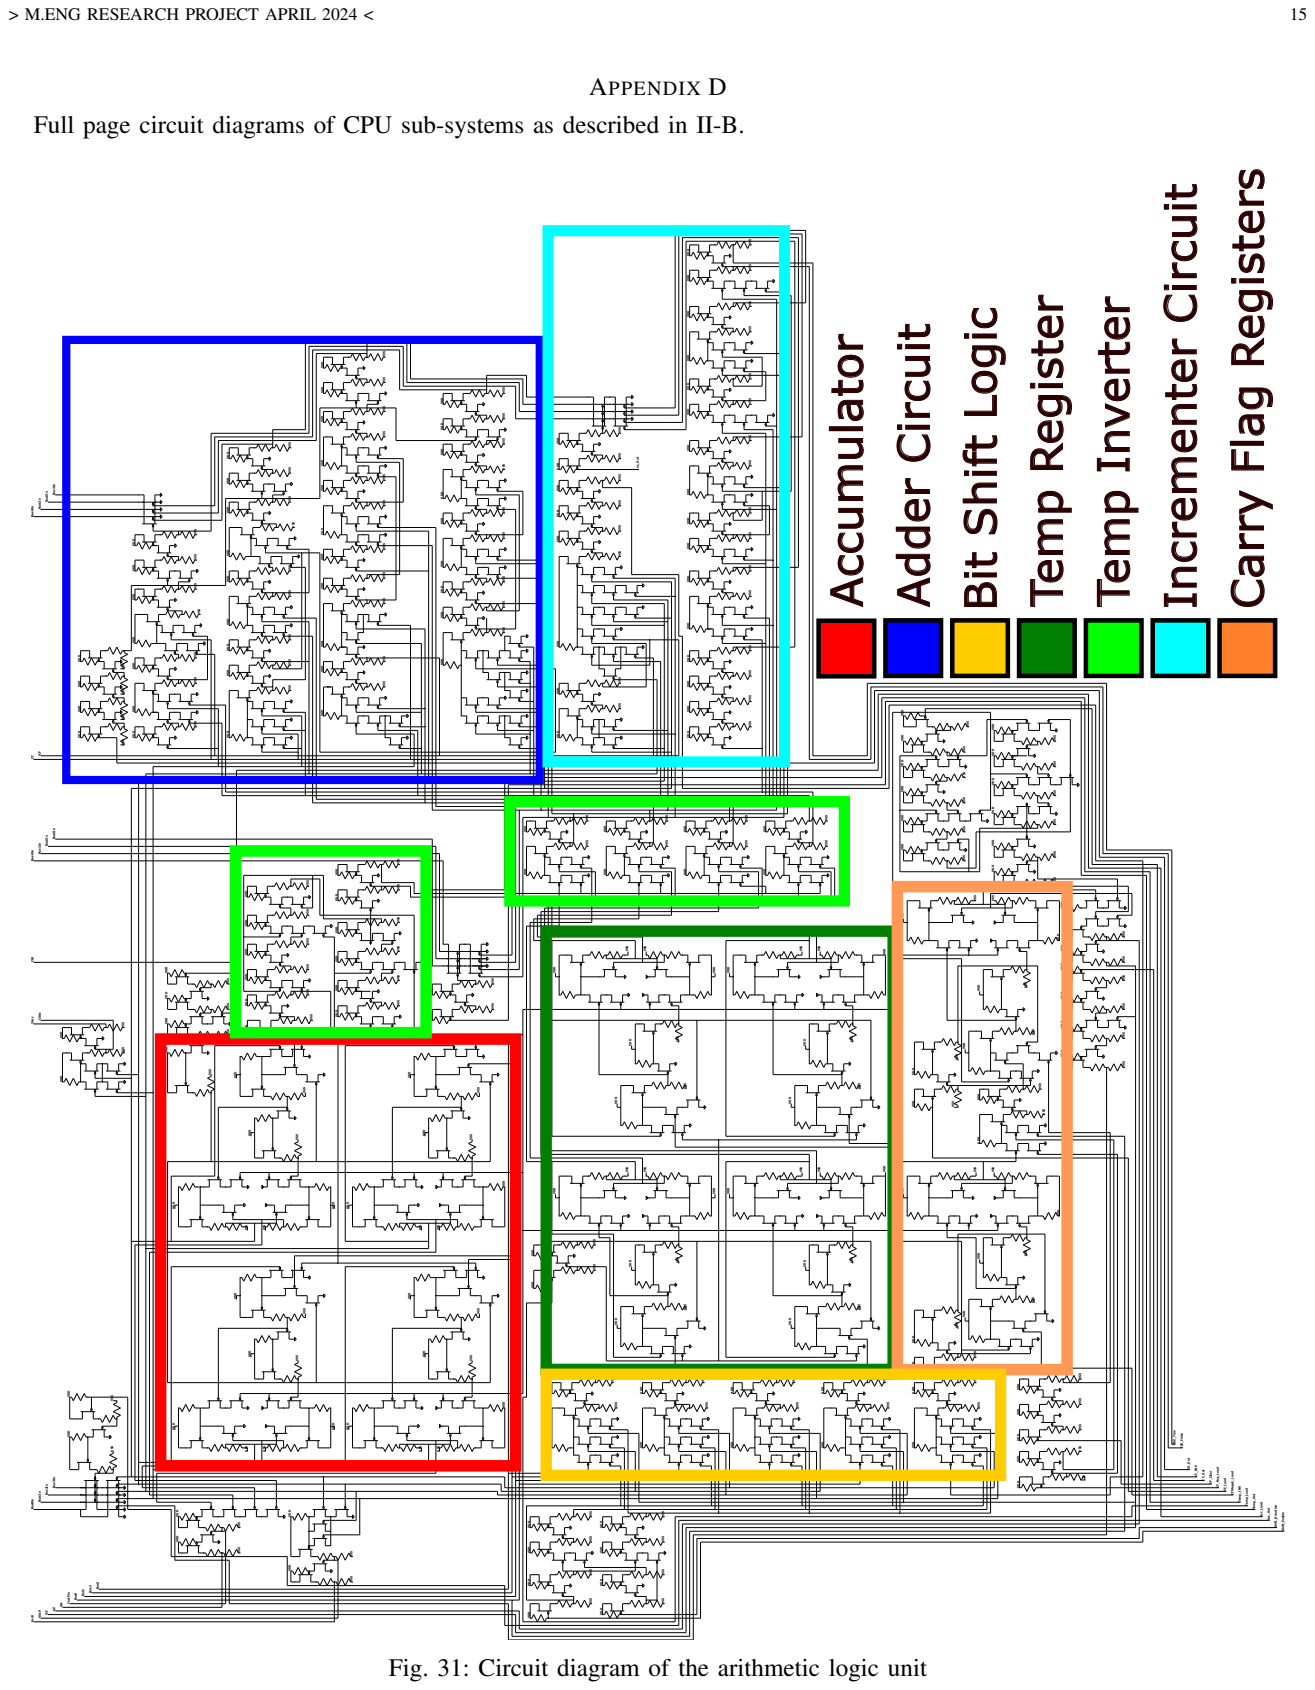
[picture p24: page 15]
APPENDIX D; VDD VDD; VSS VSS; Temp_INV; VSS; Acc_Load; Acc_Out; VDD; CF_Out; Temp_Load; CF_Bus_Load; CFStage1_Load; Shift_Enable; Shift_Direction; CF_Load; Temp_Out; CF_INV; CF_Clear; EO_Out; ISZ_False; ISZ_True; Inc_Out; Bus3; Bus2; Bus1; Bus0; Bus3In; Bus2In; Bus1In; Bus0In; Bus0In CF; Acc9; !Acc9; CLK; TestPin; !2Acc; 2Acc; Adder Circuit; Accumulator; Temp Register; Temp Inverter; Incrementer Circuit

Full page circuit diagrams of CPU sub-systems as described in II-B.

Carry Flag Registers

VDD VDD VDD

Bit Shift Logic

Fig. 31: Circuit diagram of the arithmetic logic unit

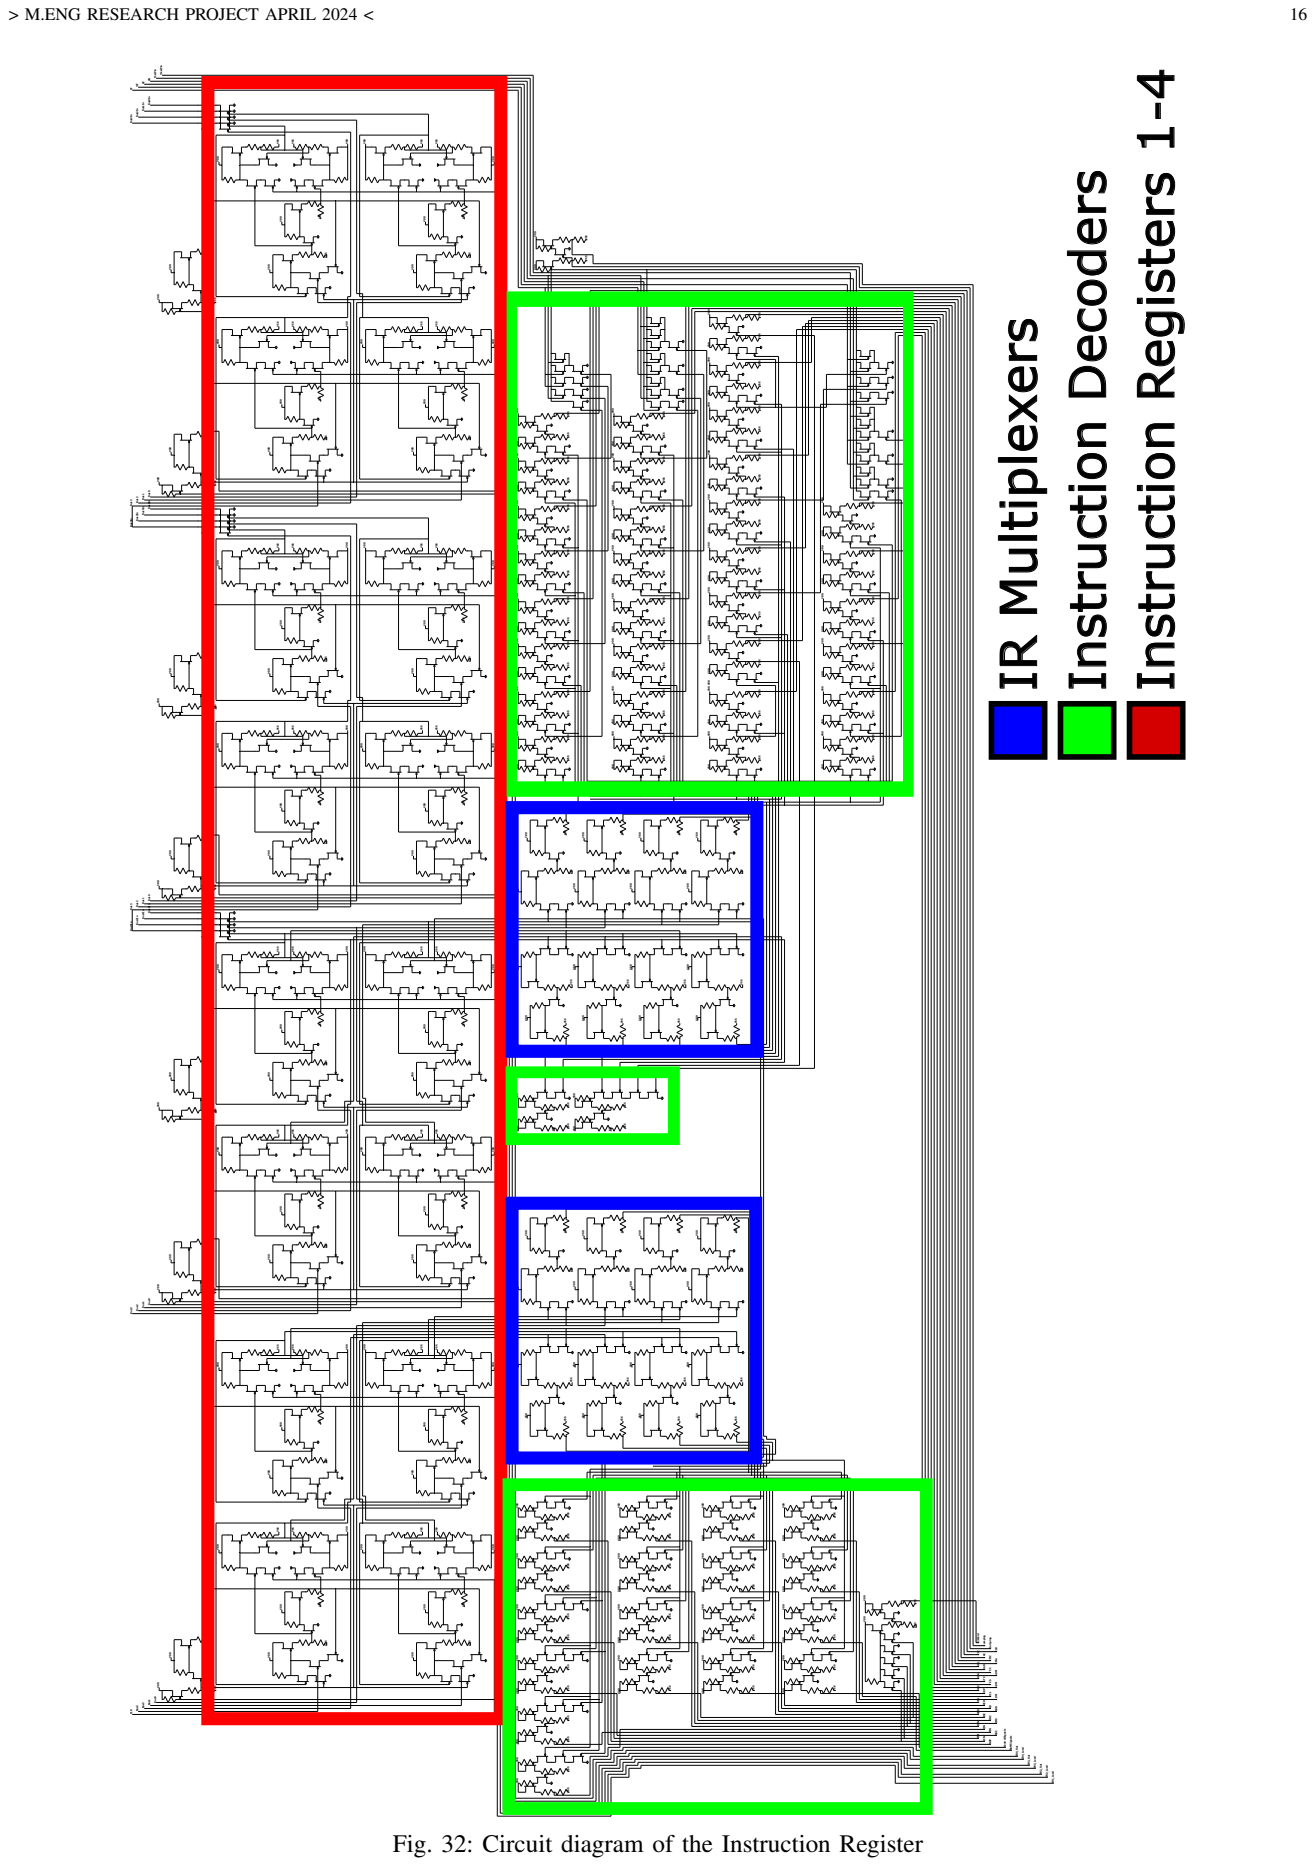
[picture p25: page 16]
VDD; VSS; IR1_Load; IR2_Out; IR4_Load; VDD VDD; VSS VSS; BBL; Jumping; !2Word; IR2_Load; IR3_Out; IR3_Load; IR4_Out; LDM; RAMSignals; NOP; JCN; FIM; FIN; JIN; SRC; JUN; JMS; INC; ISZ; ADD; SUB; XCH; ControlSignals; CLB; CLC; IAC; CMC; CMA; RAL; RAR; TCC; DAC; TCS; STC; DAA; KBP; SBM; ADM; DCL !Jumping; CLK; Bus3; Bus2; Bus1; Bus0; !TestPin; TestPin; Bus3In; Bus2In; Bus1In; Bus0In; Instruction Registers 1-4; IR Multiplexers; Instruction Decoders

VDD VDD VDD

Fig. 32: Circuit diagram of the Instruction Register

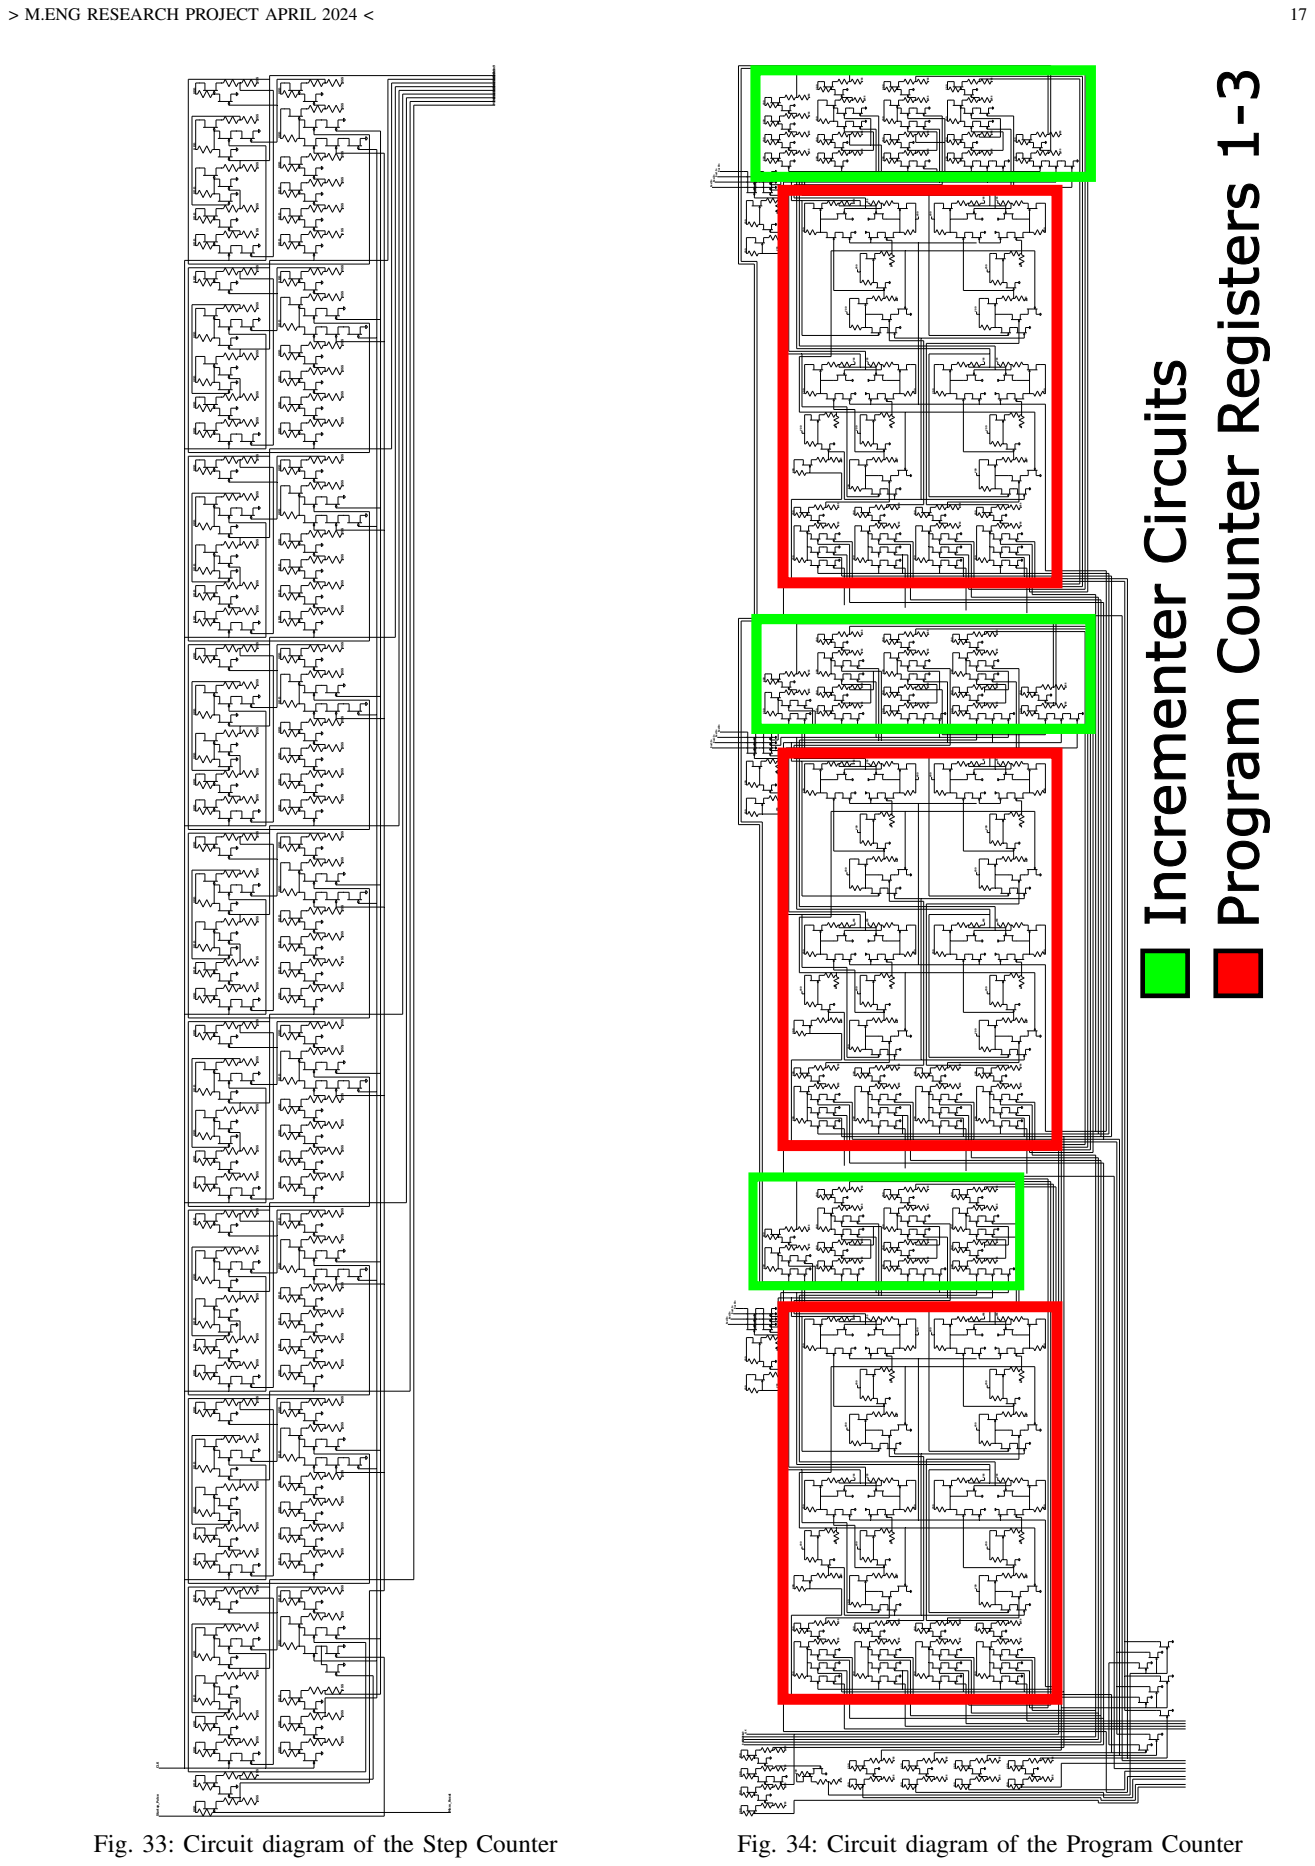
[picture p26: page 17]
Micro_Reset; VDD; VSS; VDD VDD; VSS VSS; CLK Startup_Pulse; Micro9Micro8Micro7 Micro6Micro5Micro4 Micro3Micro2Micro1; Bus3Bus2Bus1Bus0; CLK; Bus3In; Bus2In; Bus1In; Bus0In; Incrementer Circuits

Program Counter Registers 1-3

VSS VDD VDD

Fig. 33: Circuit diagram of the Step Counter

Fig. 34: Circuit diagram of the Program Counter

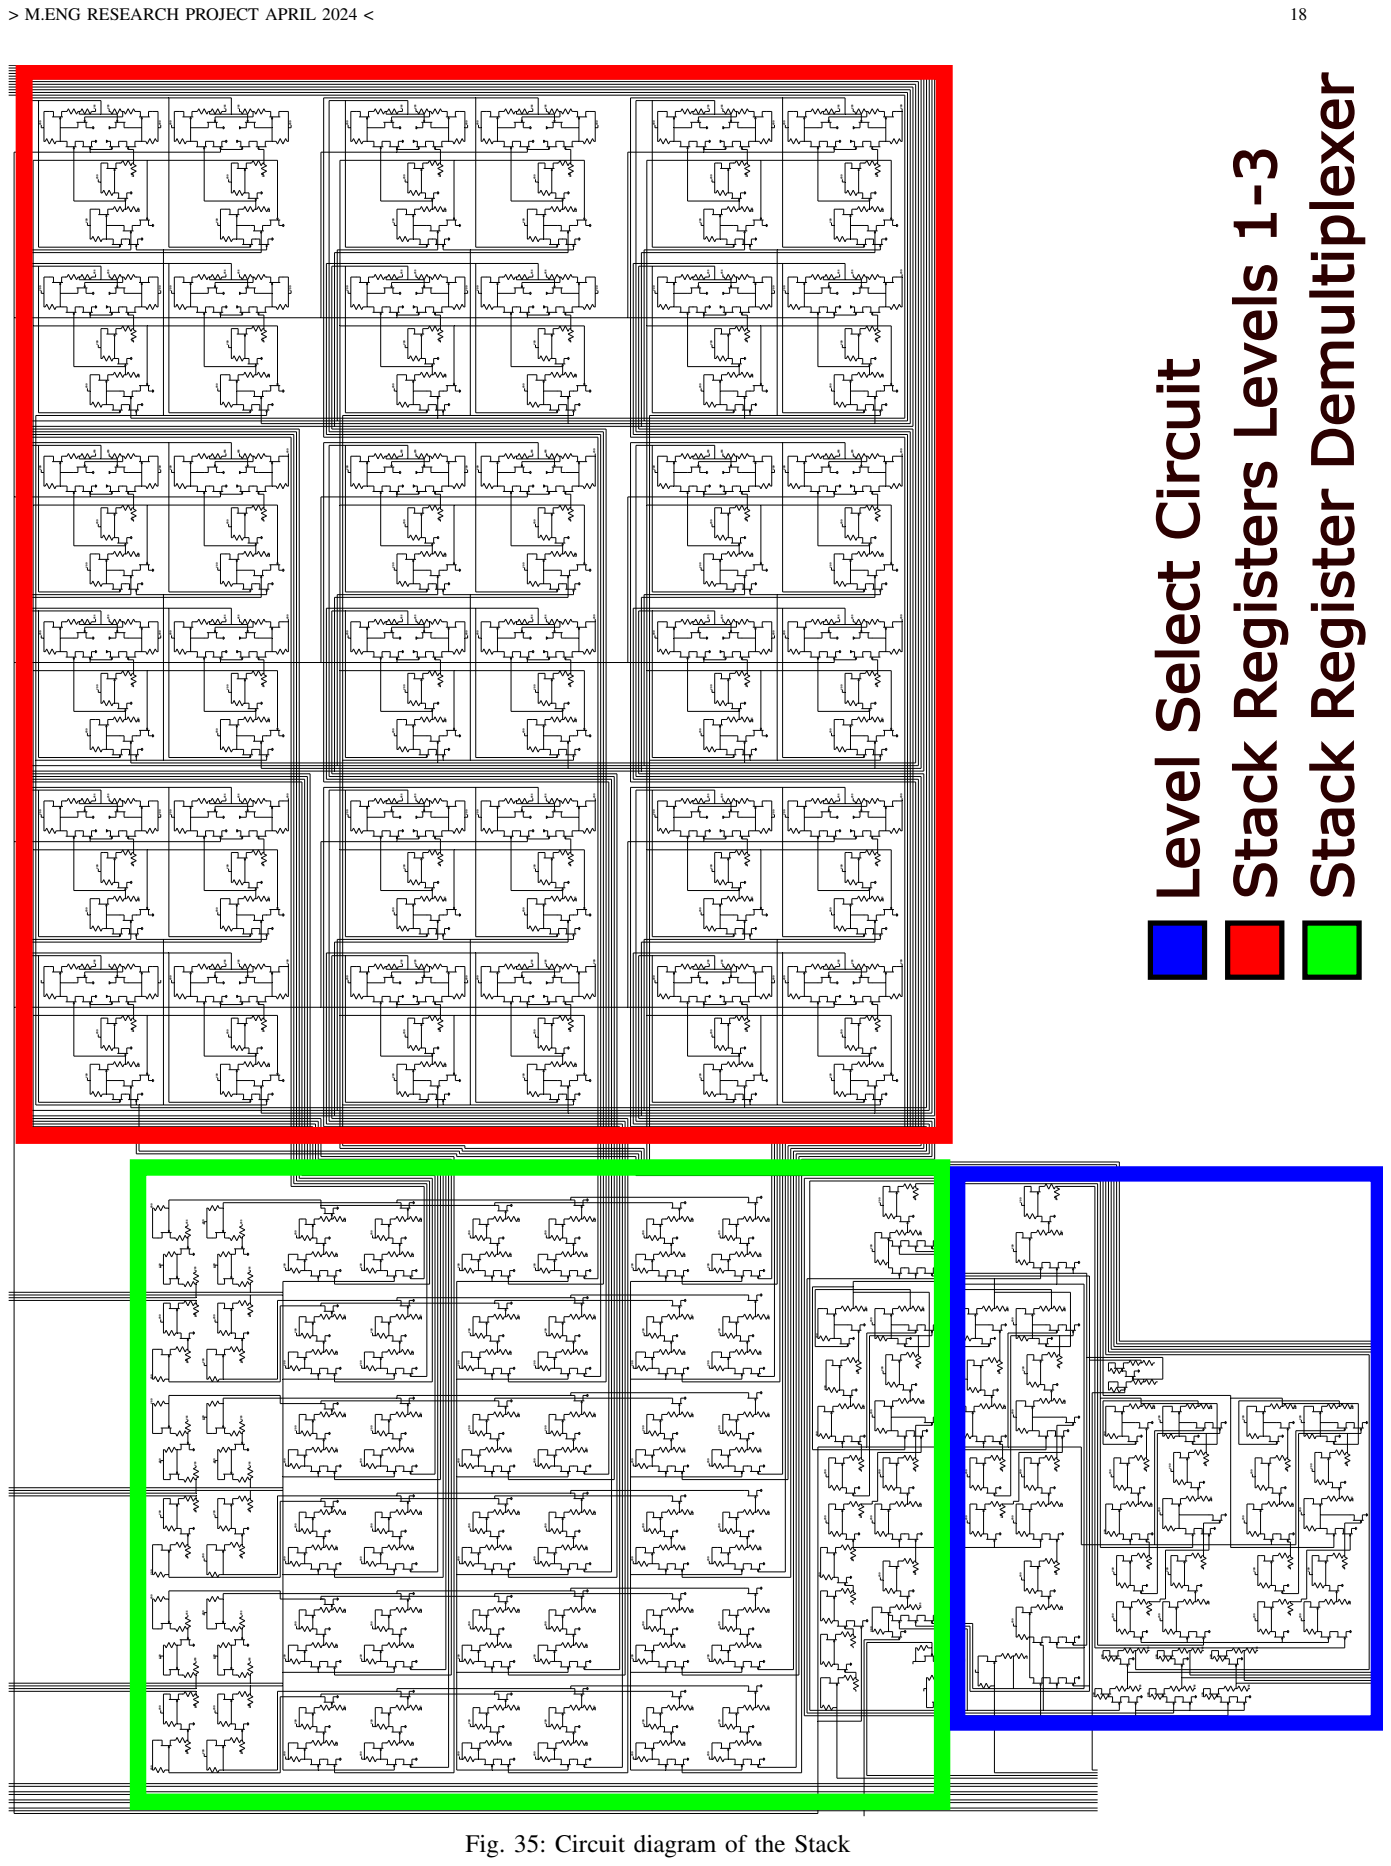
[picture p27: page 18]
VSS; VDD; VSS VDD

Stack Register Demultiplexer

Stack Registers Levels 1-3

Level Select Circuit

Fig. 35: Circuit diagram of the Stack

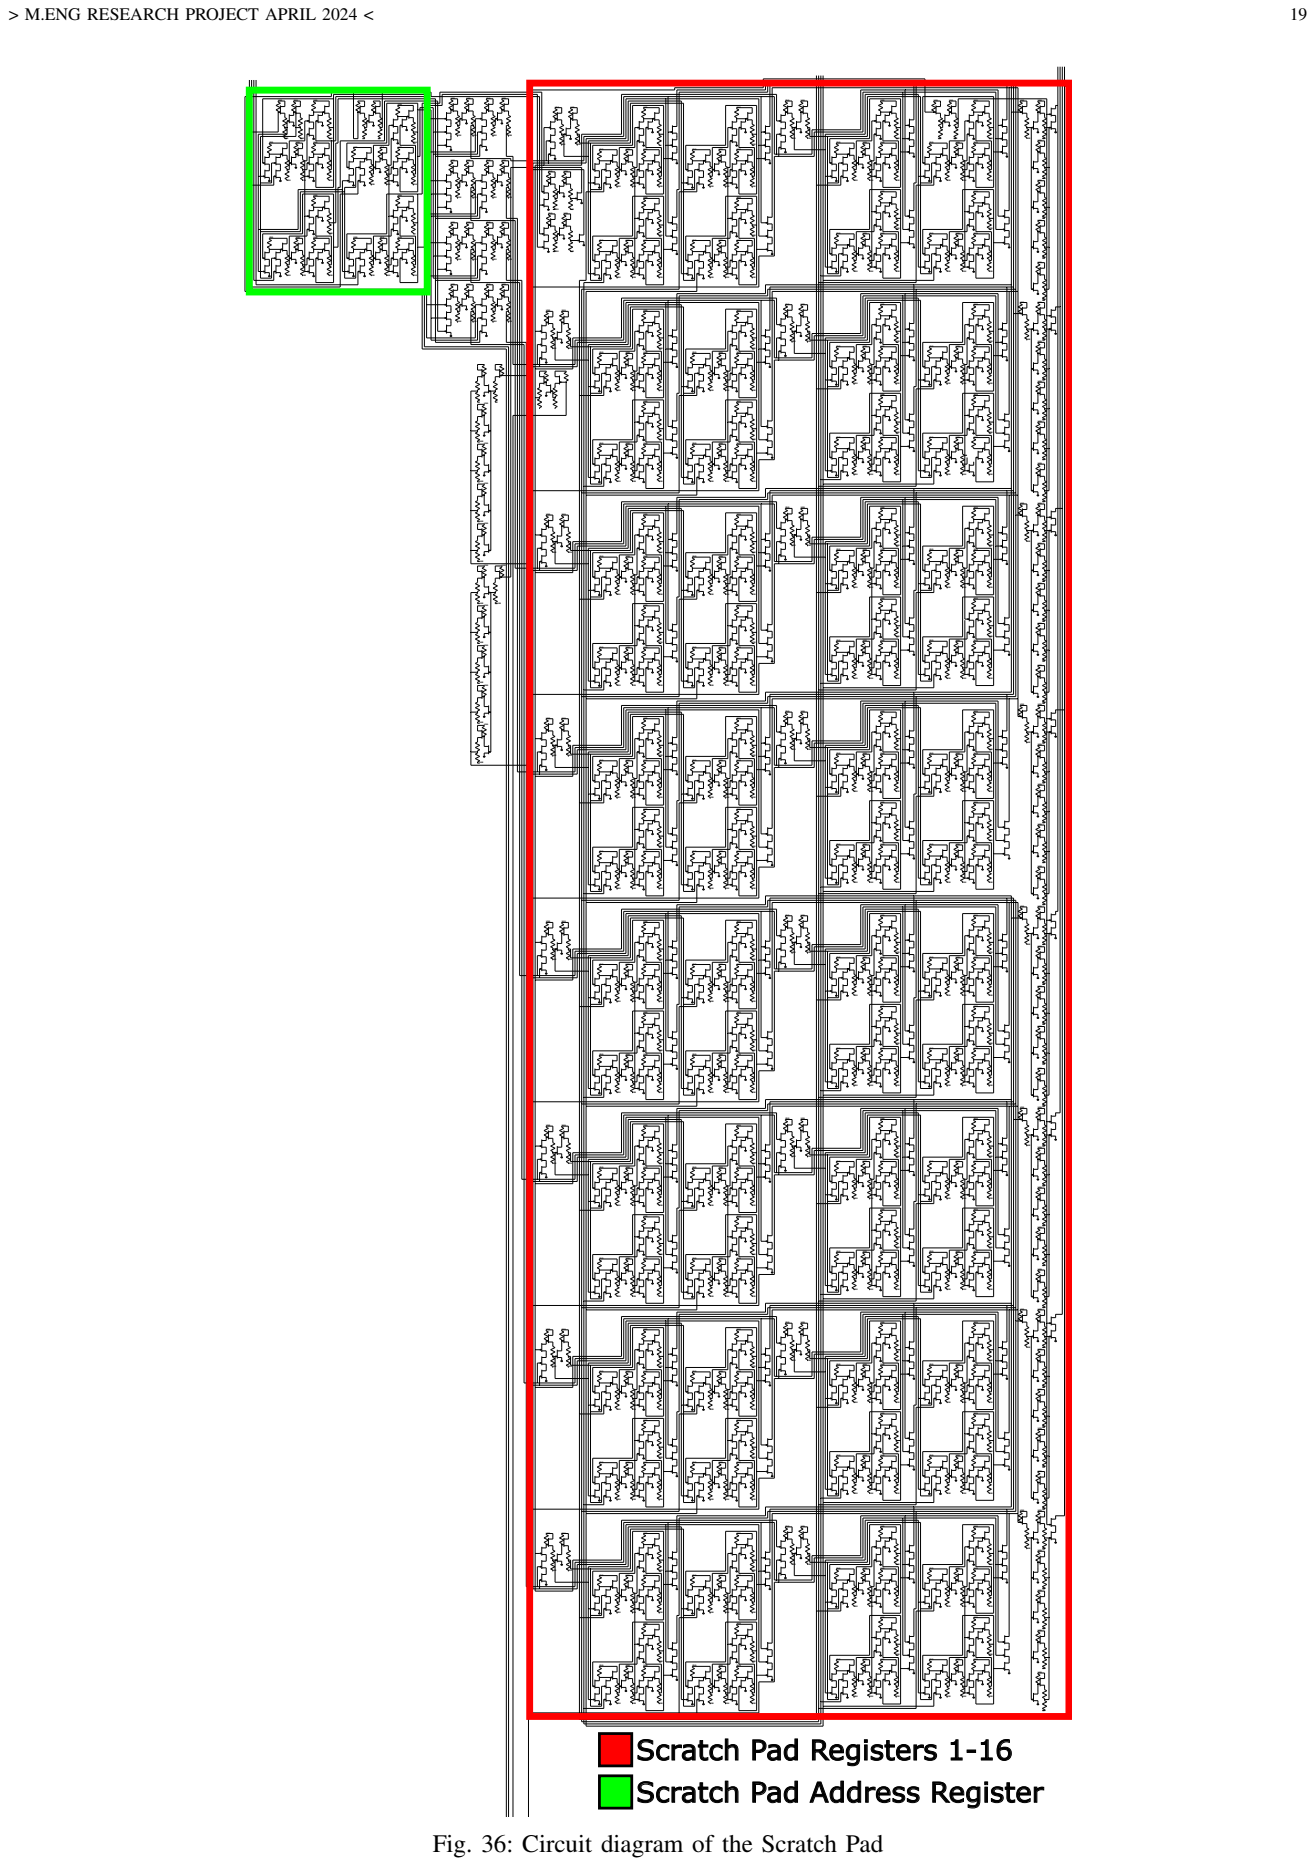
[picture p28: page 19]
VDD; VSS

VDD

VDD | VSS | VDD | VSS | VSS | VSS

Scratch Pad Registers 1-16
Scratch Pad Address Register

Fig. 36: Circuit diagram of the Scratch Pad

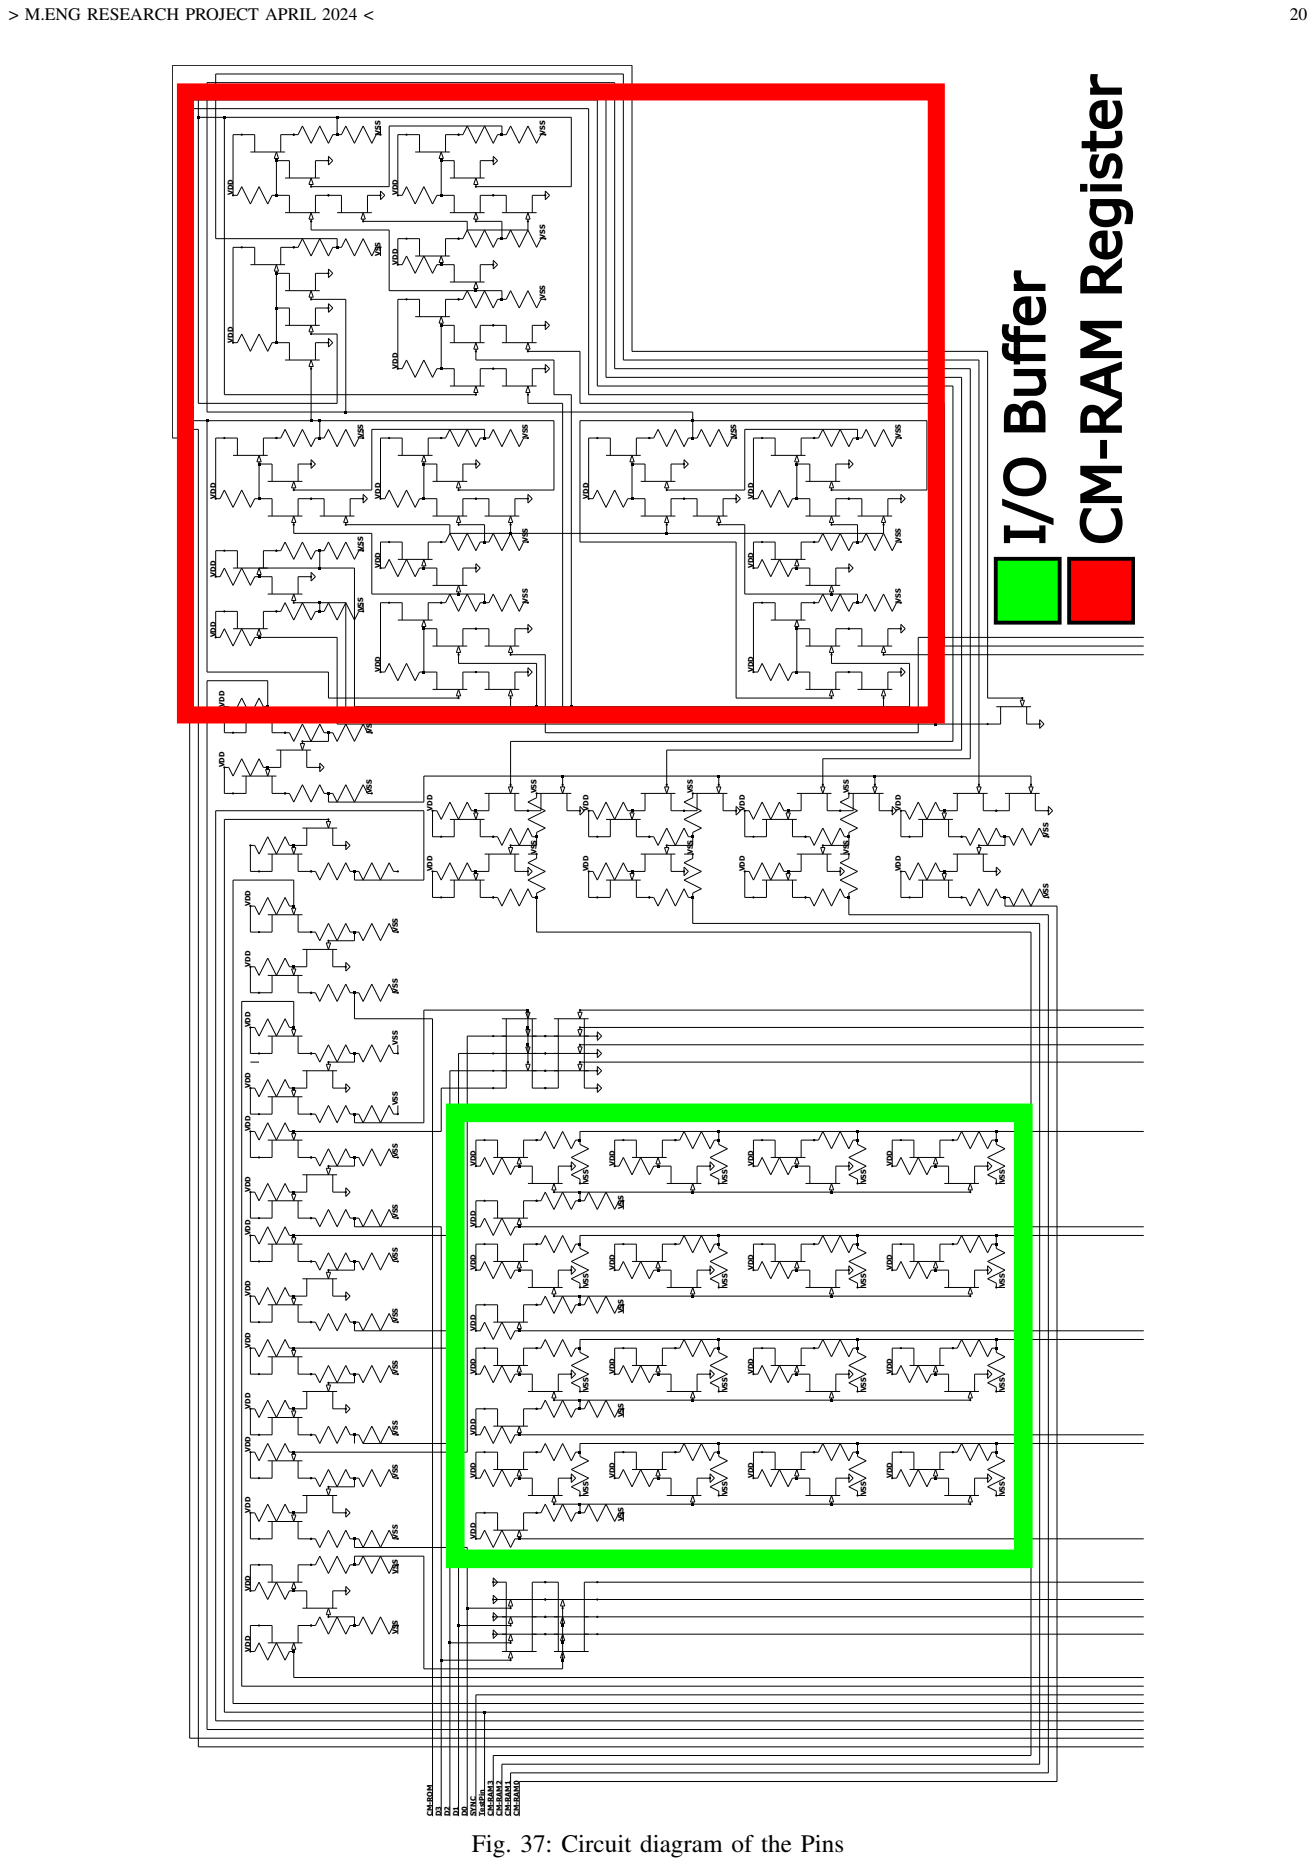
[picture p29: page 20]
VDD; VSS; TestPin; VDD VDD; VSS VSS; CM-ROM; CM-RAM3; CM-RAM2; CM-RAM1; CM-RAM0; I/O Buffer

CM-RAM Register

SYNC
Fig. 37: Circuit diagram of the Pins

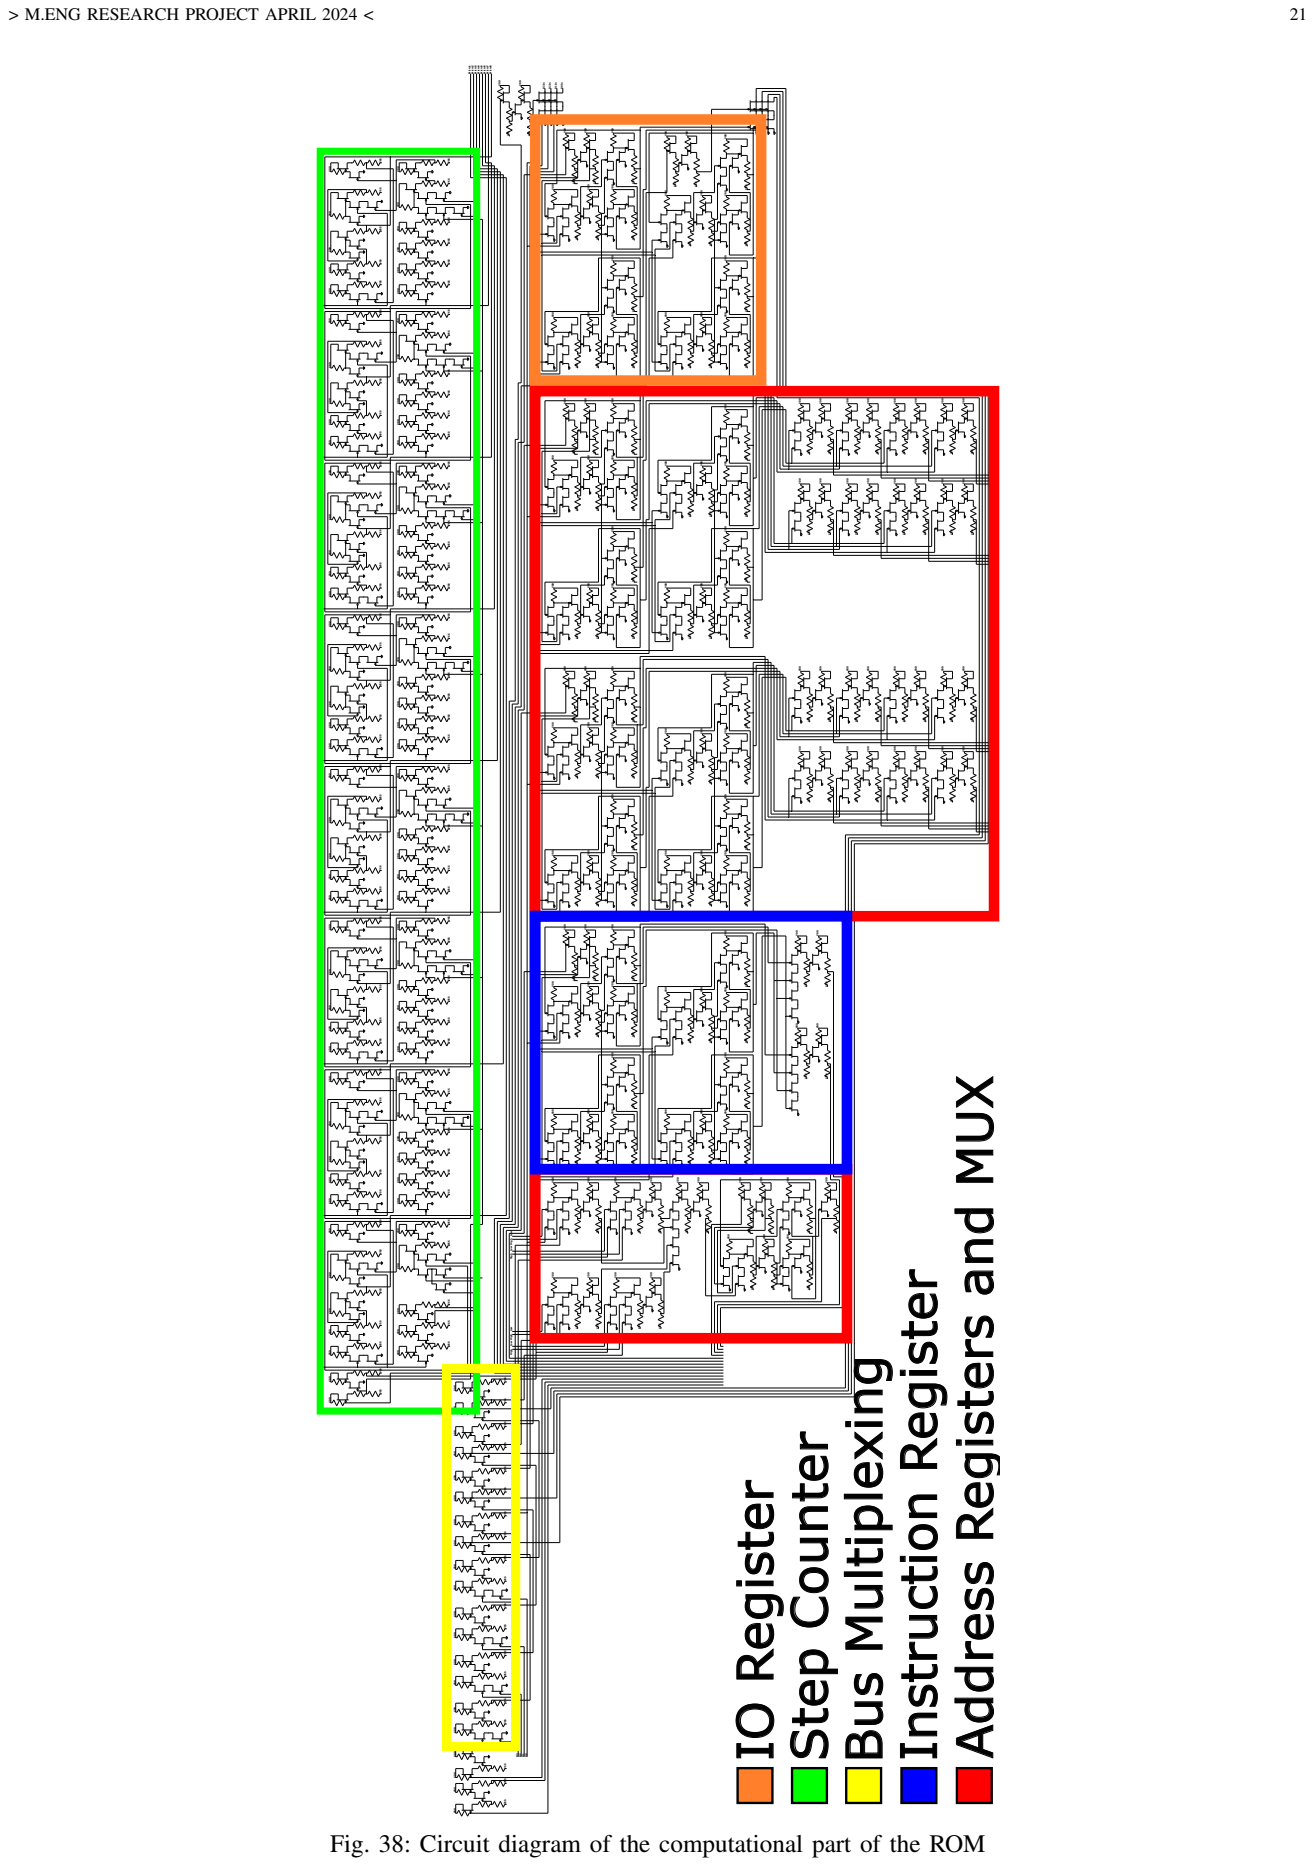
[picture p30: page 21]
VDD VDD; VSS VSS; VDD; VSS; ROM_Mid1_3; ROM_Mid1_2; ROM_Mid1_1; ROM_Mid1_0; ROM_High_3ROM_High_2 ROM_High_1ROM_High_0; ROM_Mid2_3ROM_Mid2_2 ROM_Mid2_1ROM_Mid2_0 ROM_Low_3ROM_Low_2 ROM_Low_1ROM_Low_0; Micro1; Micro2; Micro3; Micro4; Micro5; Micro6; Micro7; Micro8; Step Counter IO Register; Instruction Register Bus Multiplexing

Address Registers and MUX

Low High Low High LowHigh LowHigh

Fig. 38: Circuit diagram of the computational part of the ROM
