cgarryZA/deepJFET/paper/AppendixB.tex

\begin{figure}[H]
\begin{lstlisting}[
language={[x86masm]Assembler},
caption={Assembly Code for SIGNBITS function},
label=SIGNBITS
]
SIGNBITS CLC
LD 6
RAL
TCC
XCH 2
LD 6
RAL
CLC
RAR
XCH 6
CLC
LD 10
RAL
TCC
XCH 3
LD 10
RAL
CLC
RAR
XCH 10
BBL 0
\end{lstlisting}
\end{figure}

\begin{figure}[H]
\begin{lstlisting}[
language={[x86masm]Assembler},
caption={Assembly Code for initialising registers for multiplication function},
label=Init
]
START LDM 15
XCH 4
LDM 4
XCH 5
LDM 4
XCH 6
LDM 7
XCH 7
LDM 10
XCH 8
LDM 0
XCH 9
LDM 4
XCH 10
LDM 11
XCH 11
JMS MULT
NOP
\end{lstlisting}
\end{figure}

The way the multiplication algorithm (Listing \ref{MultRoutine}) works is two separate computations. First the sign bit is extracted from the exponent using the SIGNBITS Subroutine (Listing \ref{SIGNBITS}). Then the two exponents are added together, however this means that the offset of 63 has been added twice and needs to be subtracted to get the final value. Next the significands need to be multiplied. This is achieved by checking the lowest order bit of the multiplier. If it is high, the multiplicand is added to the output register, the multiplicand is shifted to the left and the multiplier is shifted to the right. This then repeats until the entire multiplier has been checked and the final answer can be read. There are some tricks that have been done to preserve accuracy of the final answer such as using 4 registers to store the multiplicand and the product allowing for 16 bits of accuracy. The final step shifts the entire product until it detects that there are no 1s in the two registers used for the highest order bits. If the product is shifted more than 8 times it indicates that the product required normalising, shifting so that there is a 1 in the highest order bit. If this occurs, 1 needs to be added to the exponent for each time the product is shifted past 8 times.

\begin{figure}[h]
\begin{lstlisting}[
language={[x86masm]Assembler},
caption={Assembly Code for floating point multiplication subroutine},
label=MultRoutine,
basicstyle=\ttfamily\scalefont{0.62}
]
MULT FIM 6 0 0
JMS SIGNBITS
LD 7
ADD 11
XCH 15
LD 6
ADD 10
XCH 14
CLC
LDM 15
XCH 0
LD 15
SUB 0
XCH 15
CMC
LDM 3
XCH 0
LD 14
SUB 0
XCH 14
CLC
LD 2
ADD 3
RAL
RAL
RAL
CLC
ADD 14
XCH 14
FIM 0 0 0
FIM 1 0 0
BCHECK LD 8
JCN 12 IF1
LD 9
JCN 12 IF1
JUN RETURN
IF1 CLC
LD 8
RAR
XCH 8
LD 9
RAR
XCH 9
JCN 10 IF2
CLC
LD 13
ADD 5
XCH 13
LD 12
ADD 4
XCH 12
LD 3
ADD 1
XCH 3
LD 2
ADD 0
XCH 2
IF2 CLC
LD 5
RAL
XCH 5
LD 4
RAL
XCH 4
RAL
LD 1
RAL
XCH 1
LD 0
RAL
XCH 0
JUN BCHECK
RETURN LD 2
JCN 12 IF3
LD 3
JCN 12 IF3
JUN MULTEND
IF3 LD 2
RAR
XCH 2
LD 3
RAR
XCH 3
LD 12
RAR
XCH 12
LD 13
RAR
XCH 13
CLC
JUN RETURN
MULTEND BBL 0
\end{lstlisting}
\end{figure}
