cgarryZA/deepJFET/paper/reproducibility/MANIFEST.csv

group | path | bytes | sha256 | generator
CPU schematics | cpus/4004/4004.asc | 2098031 | 53e213701fb07f414c54fac6bc667ccc207d7be822d342214c6ed2ec18f7405e | static
CPU schematics | cpus/4004/Load5_test.asc | 2097248 | aa89c3d9ee99c797f3b1831f25108d0798af3f1aaa3199e69953e21a22b0338e | static
CPU schematics | cpus/4004/__init__.py | 50 | 13bd999122a5c75bea85bf96828ba1b36ae32e888254a397bf406d336609c837 | static
CPU schematics | cpus/4004/alu.asc | 212578 | e927b54b3c57bf9124aee9513cae76914a86a2cde55c7029512ab4a9a024027c | static
CPU schematics | cpus/4004/config.py | 4267 | 719c8c4eac77bd96d914f4a5ea8182d5b4ce4f9955f67327f681129b346952e1 | static
CPU schematics | cpus/4004/controls.asc | 13207 | af925cfd42776ed1d157de3c89fa7d7c39ce504598ecb24371d8c56a6ec78501 | static
CPU schematics | cpus/4004/instruction_register.asc | 252803 | d670055ad87cfdb2639dcb7af41a5ec1a2170fdb3f29e0346d401a9d31484205 | static
CPU schematics | cpus/4004/micro_instructions.asc | 274487 | bc8ce76743511ac9dea8856cca3477f210bb6701ca6be53c8856165b46fa6d05 | static
CPU schematics | cpus/4004/pins.asc | 59086 | c8dbd645c257087aac2e7aaef4d933793d8b01744e394ef7c0efc25a207a2eaa | static
CPU schematics | cpus/4004/program_counter.asc | 185746 | 8bc014ccc8cfa8531767e7663634b378378a95b644b62c97c38f89d472994ea2 | static
CPU schematics | cpus/4004/scratchpad/Bus1.asc | 24234 | 992c5cf0e810194d0332d0f7628b379e12cbf6e8a54f9499f2aac68a066f59ce | static
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
tools | tools/test_register.py | 9538 | 5cb4d0748f3704fee1786f3e74fb5edc5ca8d252101f2cecb5cb4c4c4cc8633d | static
tools | tools/tile_schematic.py | 17509 | ceeec1e803322bc2b45f4d17795f270099a3faec26d5353718c7c6c44b5e21f3 | static
tools | tools/tile_shifter.py | 6392 | 5f6b592811998763d7e08ced39a2a567ab5b93c055066ffa65325966cdc1cbf9 | static
tools | tools/trace_divergence.py | 12326 | aec91f276a34e2982809598d7039e002fa22b1ea3e3a93ffd83871500ca8538d | static
tools | tools/trace_from_sync.py | 13899 | 4e9b19b0eab74924d04efd3655b009ea2708edb62e030f7ab9341782cf7404d7 | static
tools | tools/trace_synced.py | 20927 | 332cd7bfd1db4c2013893fbe73fa2fa9cd66717f4352cb859ce312ff52a883af | static
tools | tools/verify_hw_ops.py | 11574 | 2660cecdc947c6147a023e38925b6f07373174e47ab1570b98562e0dc2e5ce22 | static
