cgarryZA/deepJFET/paper/CPU.JPG

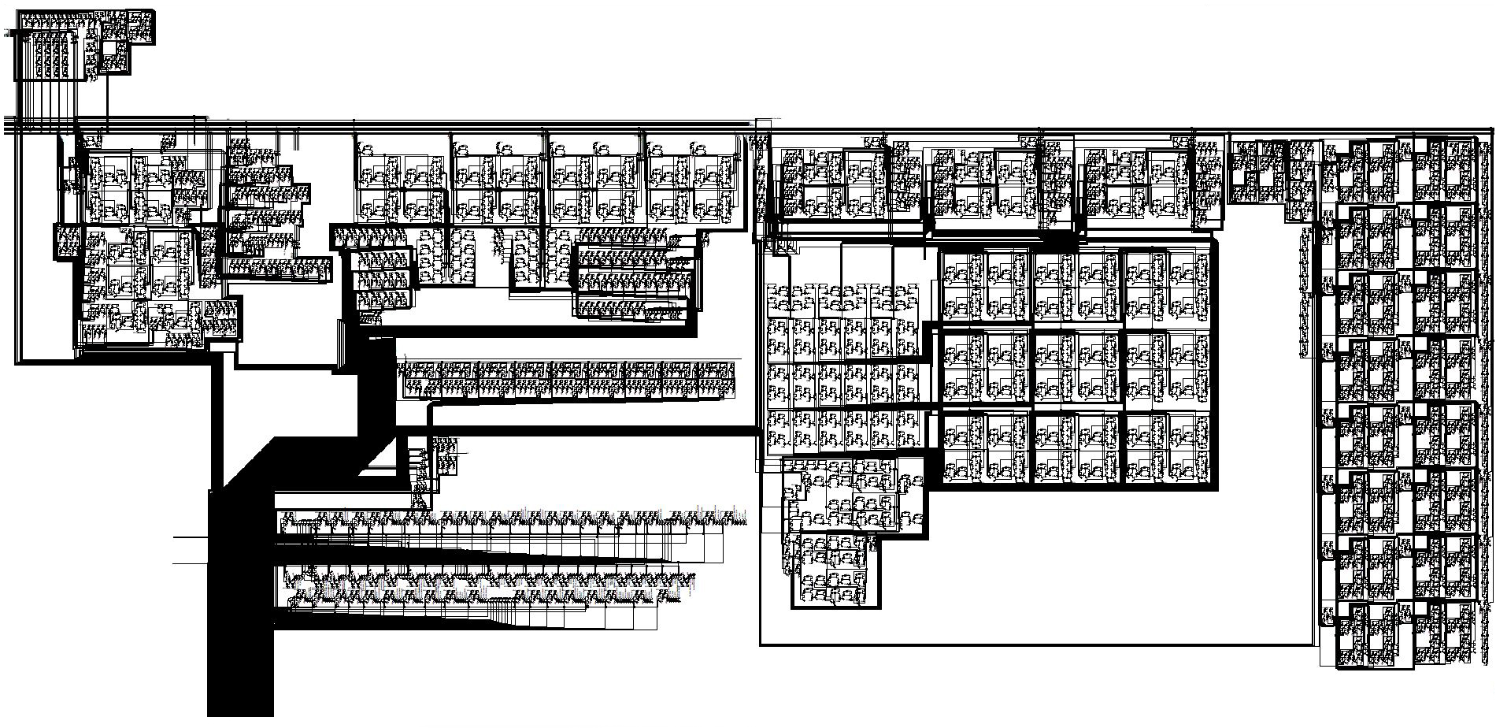
paper/CPU.JPG
