cgarryZA/deepJFET/paper/Images/4004Architecture.png

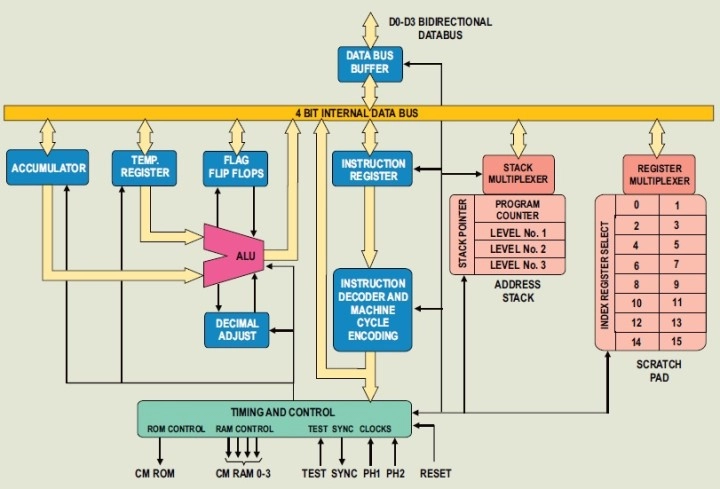
paper/Images/4004Architecture.png
