cgarryZA/deepJFET/paper/Images/Emulator.png

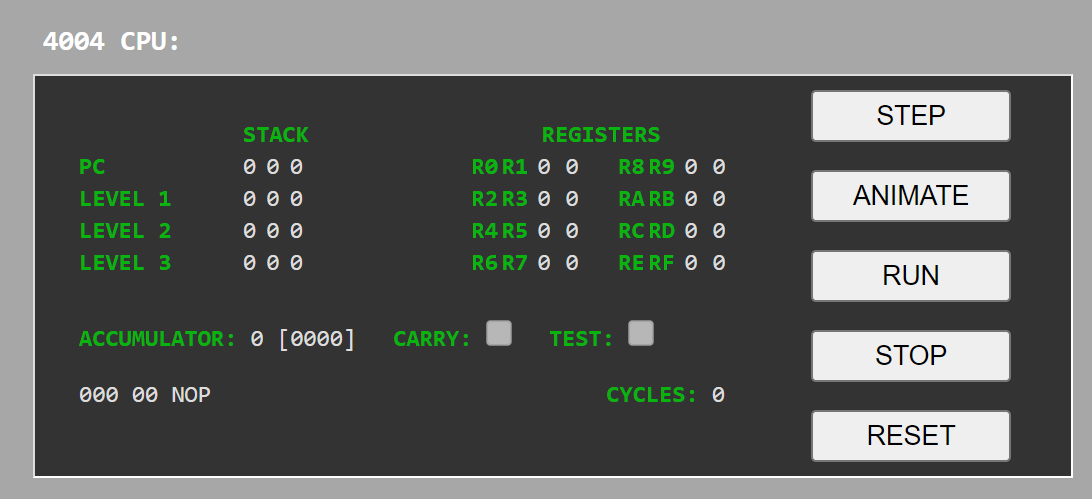
paper/Images/Emulator.png
