cgarryZA/deepJFET/paper/Images/ROM.JPG

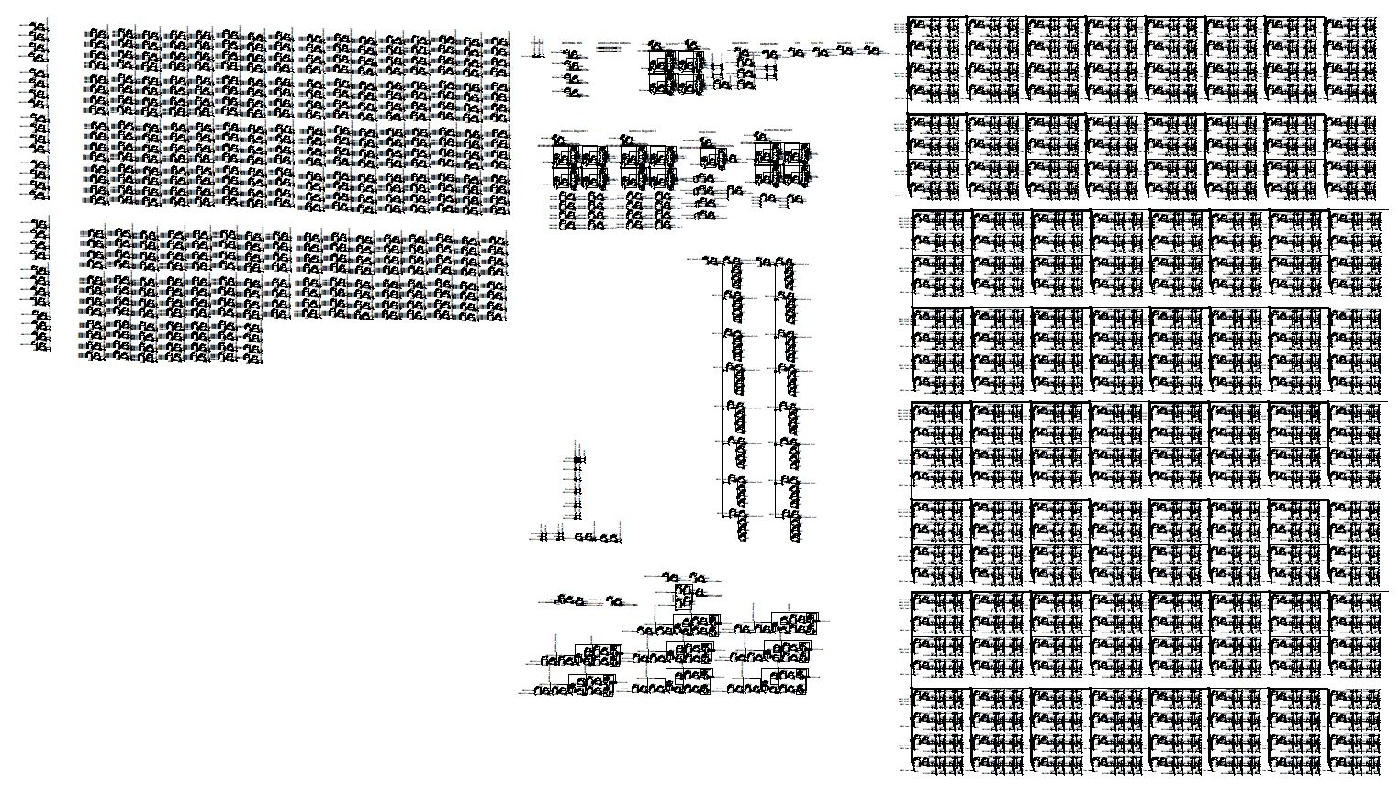
paper/Images/ROM.JPG
