cgarryZA/deepJFET/paper/Images/MicroInstructionExp.pdf

## ADD Instruction

X1 | X2 | X3
Output Instruction Register 2 to the Bus | Output ScratchPad Addressed to the Bus | Output Adder Sum to the Bus | Increment Program Counter
Load ScratchPad Index Reg from the Bus | Load Temporary Register from the Bus | Load Acc Register from the Bus | Reset Micro Instruction Step Counter
| Address ScratchPad Individually using low order bit | | Load Second Stage of Carry
