cgarryZA/deepJFET/paper/Appendices/NAND2.pdf

-202

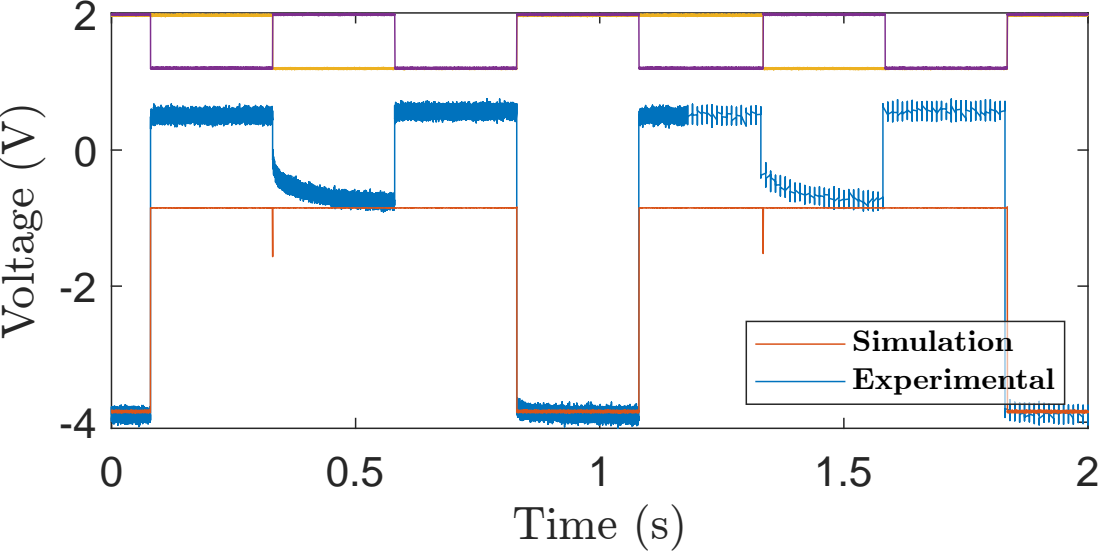
[picture p35: page 1]
Voltage (V)
