cgarryZA/deepJFET/paper/Appendices/NAND200K.pdf

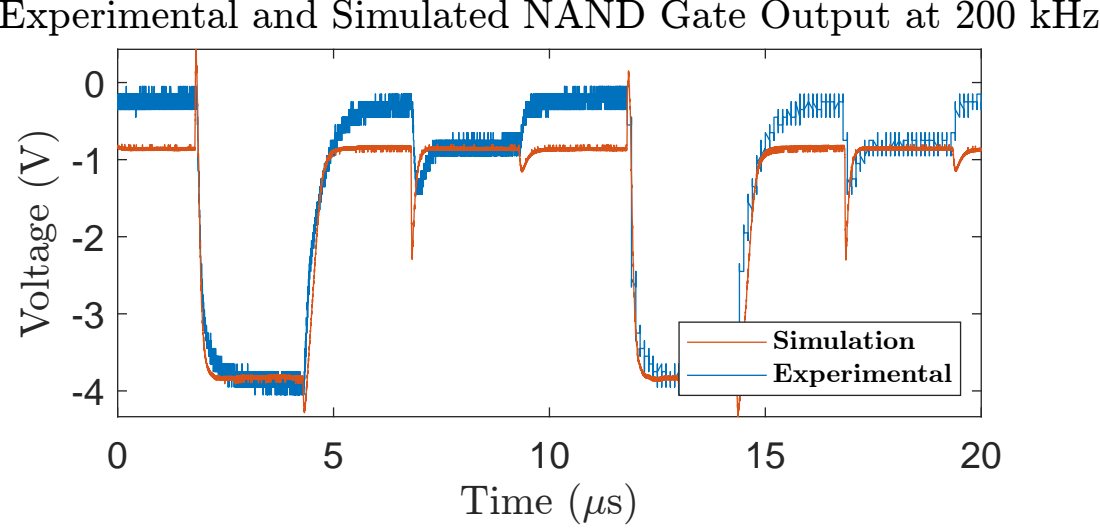
[picture p36: page 1]
Time (7s); Volt; Experimental and Simulated NAND Gate Output at 200 kHz; Simulation Experimental
