cgarryZA/deepJFET/paper/Appendices/NAND2K.pdf

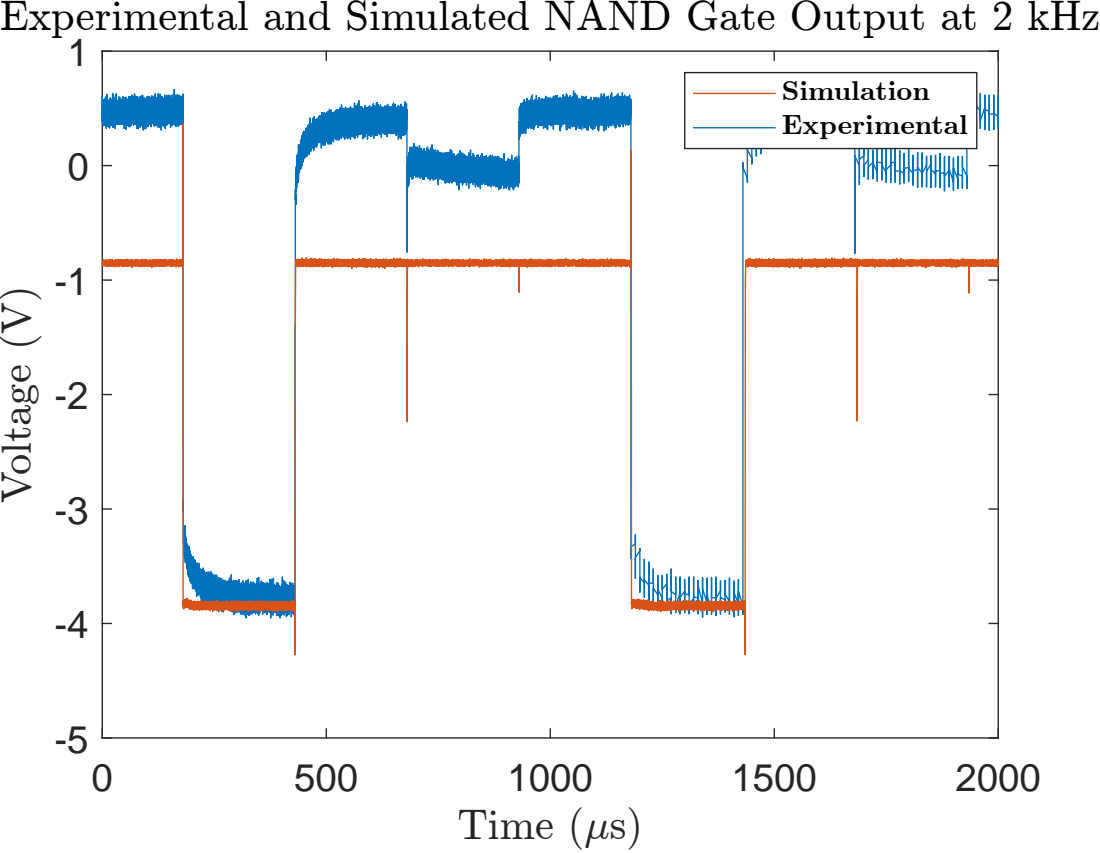
[picture p37: page 1]
Time (7s); Volt; Simulation Experimental

Experimental and Simulated NAND Gate Output at 2 kHz
