cgarryZA/deepJFET/paper/Appendices/NAND400K.pdf

-202

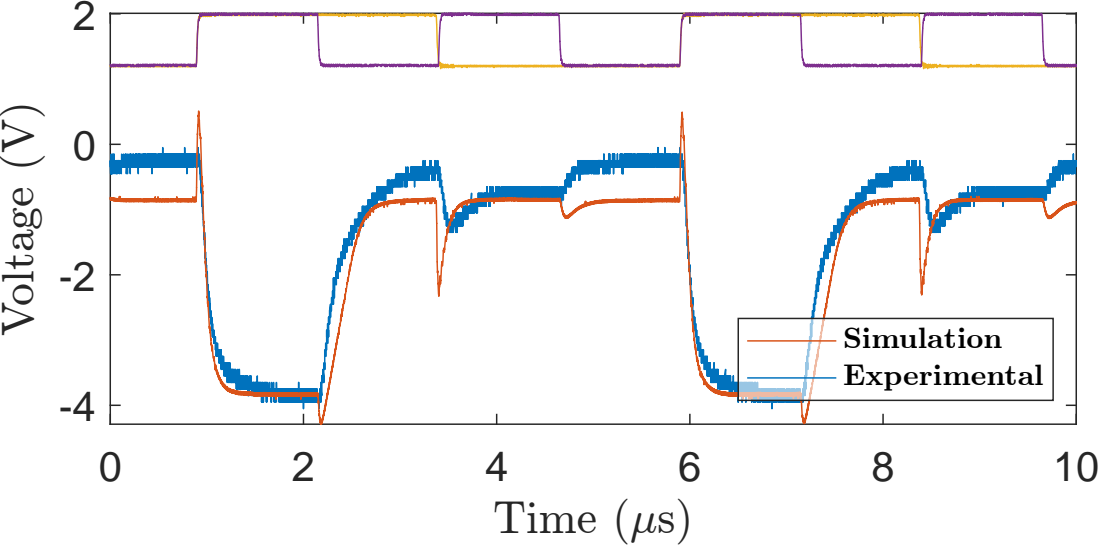
[picture p38: page 1]
Voltage (V)
