cgarryZA/deepJFET/paper/Appendices/NAND50K.pdf

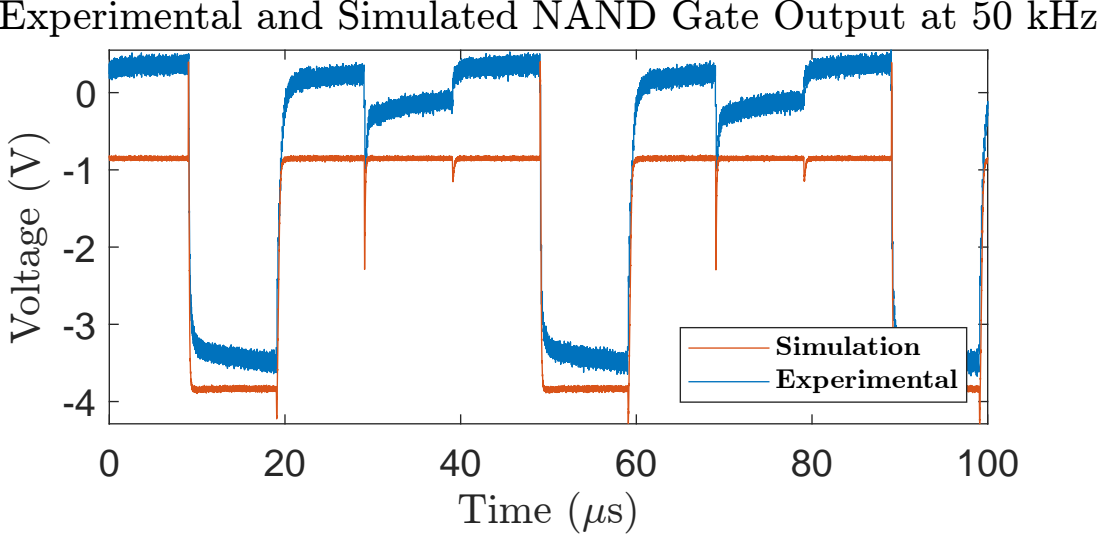
[picture p39: page 1]
Time (7s); Volt; Experimental and Simulated NAND Gate Output at 50 kHz; Simulation Experimental
