cgarryZA/deepJFET/paper/Appendices/NAND800K.pdf

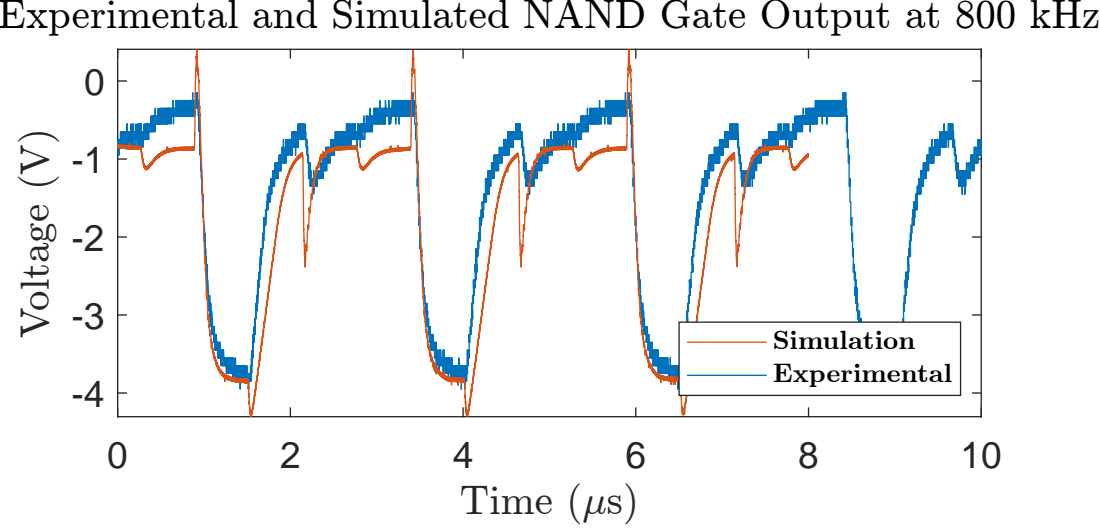
[picture p40: page 1]
Time (7s); Volt; Experimental and Simulated NAND Gate Output at 800 kHz; Simulation Experimental
