cgarryZA/deepJFET/paper/Appendices/NOR200K.pdf

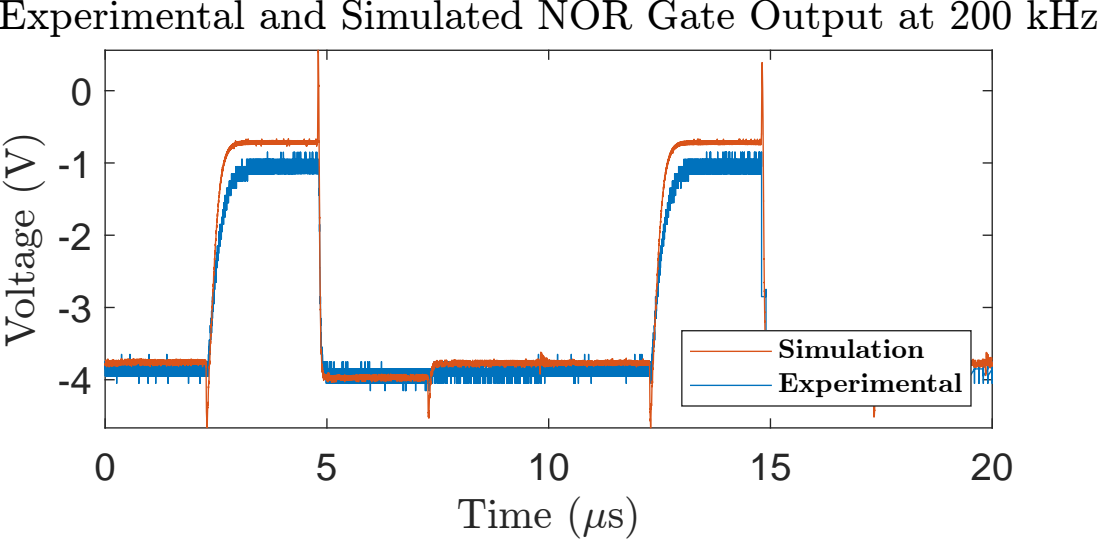
[picture p41: page 1]
Time (7s); Volt; Experimental and Simulated NOR Gate Output at 200 kHz; Simulation Experimental
