cgarryZA/deepJFET/paper/Appendices/NOR400K.pdf

-202

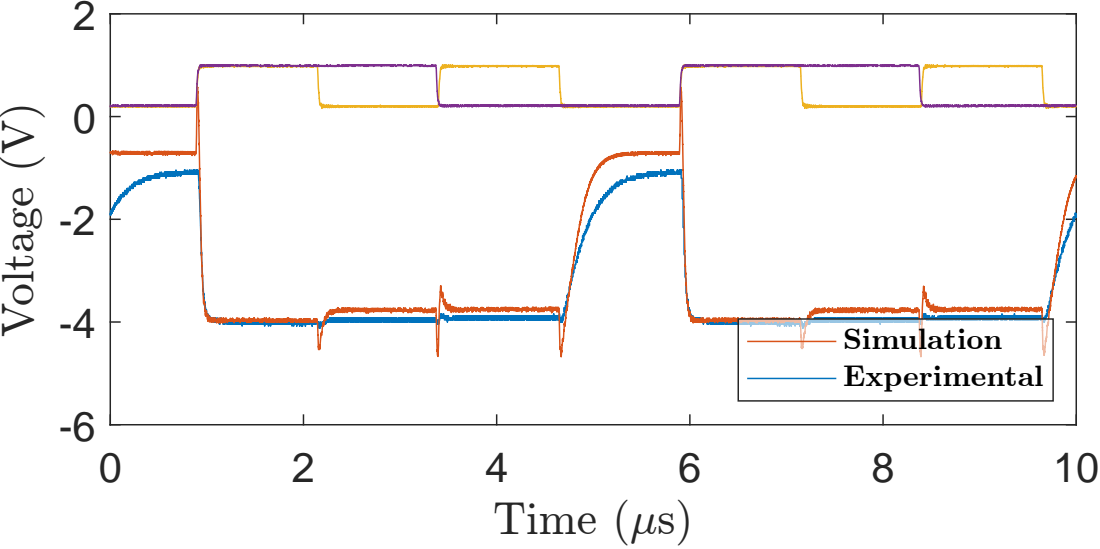
[picture p42: page 1]
Voltage (V)
