cgarryZA/deepJFET/paper/Appendices/NOR50K.pdf

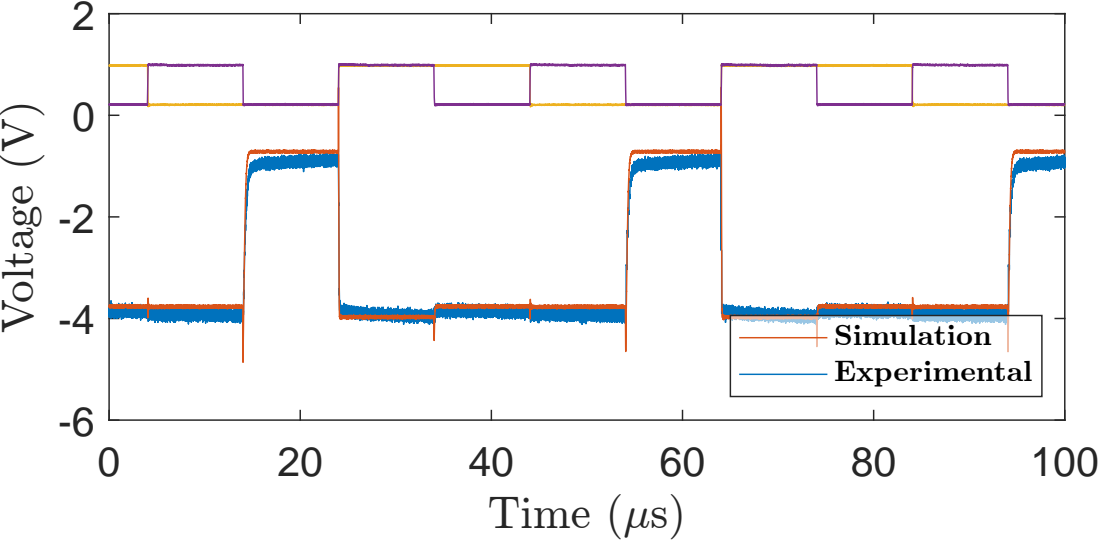
[picture p43: page 1]
100 Time (7s); Voltage (V)
