cgarryZA/deepJFET/paper/Images/NAND100.pdf

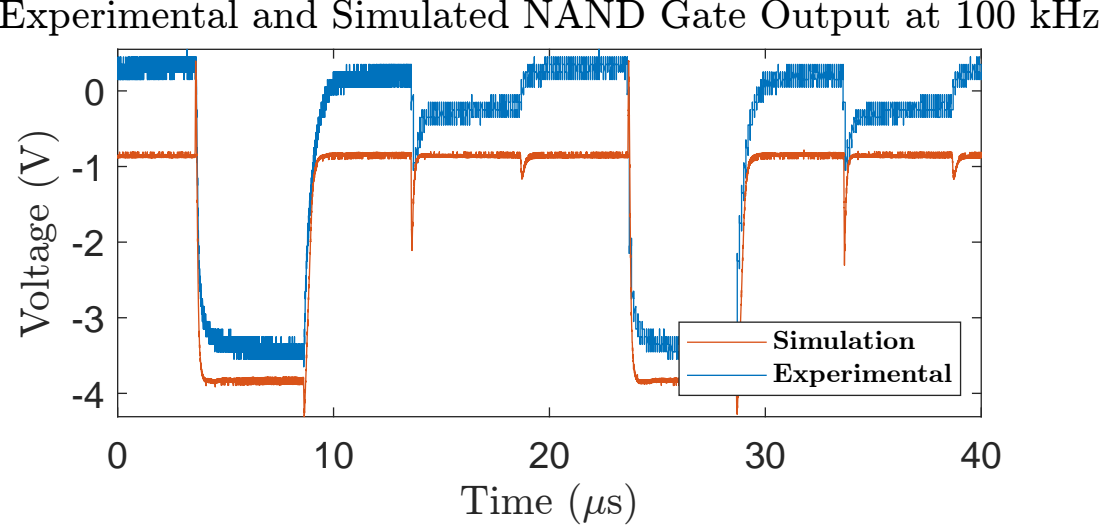
[picture p44: page 1]
Time (7s); Volt; Experimental and Simulated NAND Gate Output at 100 kHz; Simulation Experimental
