cgarryZA/deepJFET/paper/Images/NAND1000K.pdf

-202

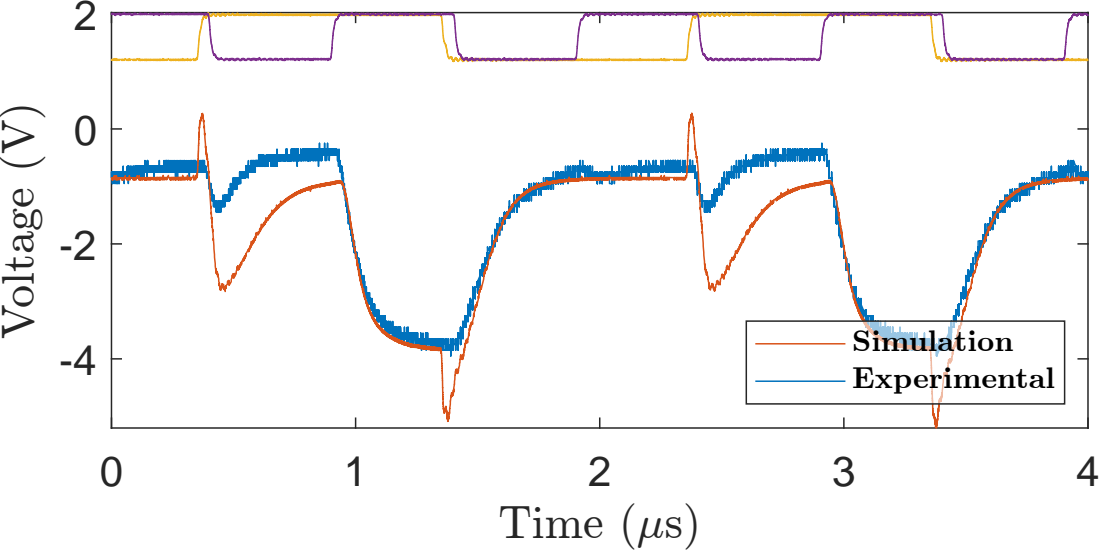
[picture p45: page 1]
Voltage (V)
