cgarryZA/deepJFET/paper/Images/NAND100k.pdf

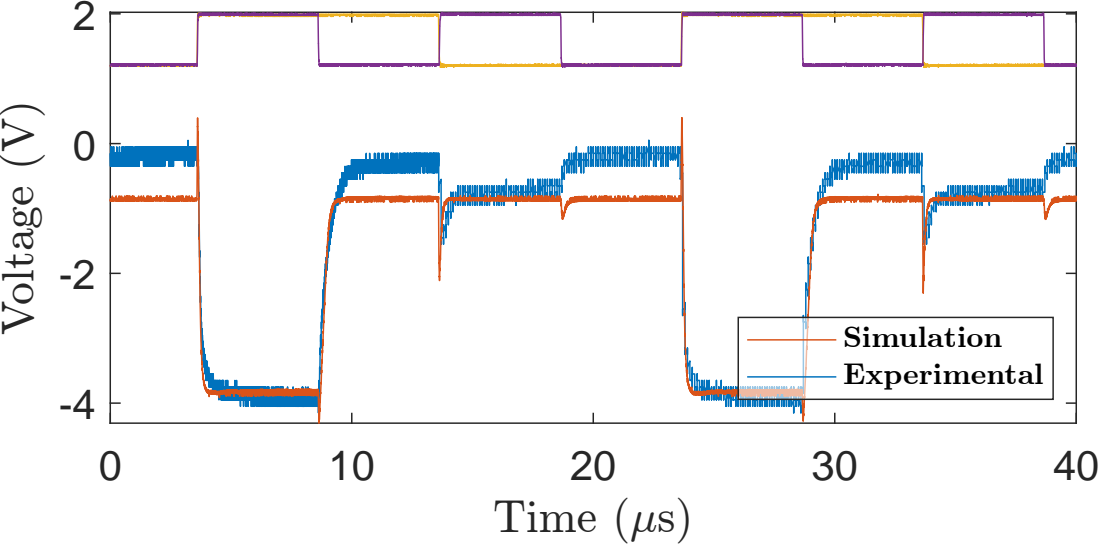
[picture p46: page 1]
40 Time (7s); Voltage (V)
