cgarryZA/deepJFET/paper/Images/NAND100kI.pdf

0.51

1.5

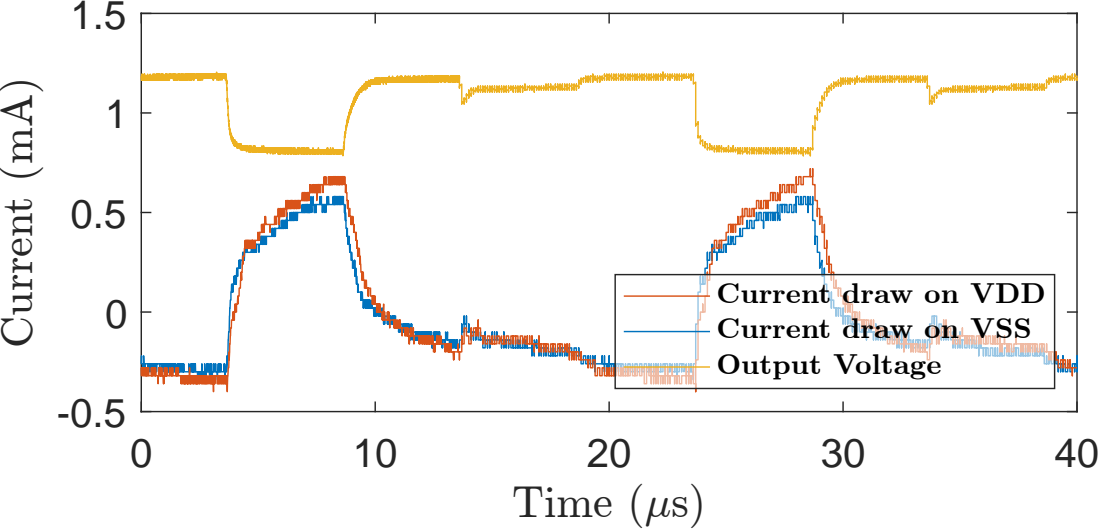
[picture p47: page 1]
40 Time (7s); Current (mA)
