cgarryZA/deepJFET/paper/Images/NAND2kI.pdf

0.51

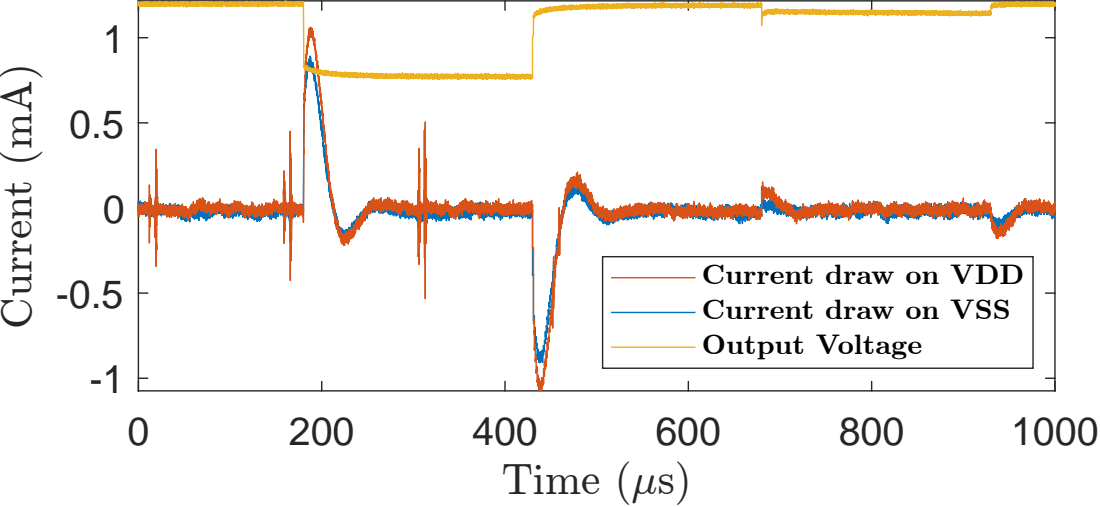
[picture p48: page 1]
1000 Time (7s); Current (mA)
