cgarryZA/deepJFET/paper/Images/NOR100.pdf

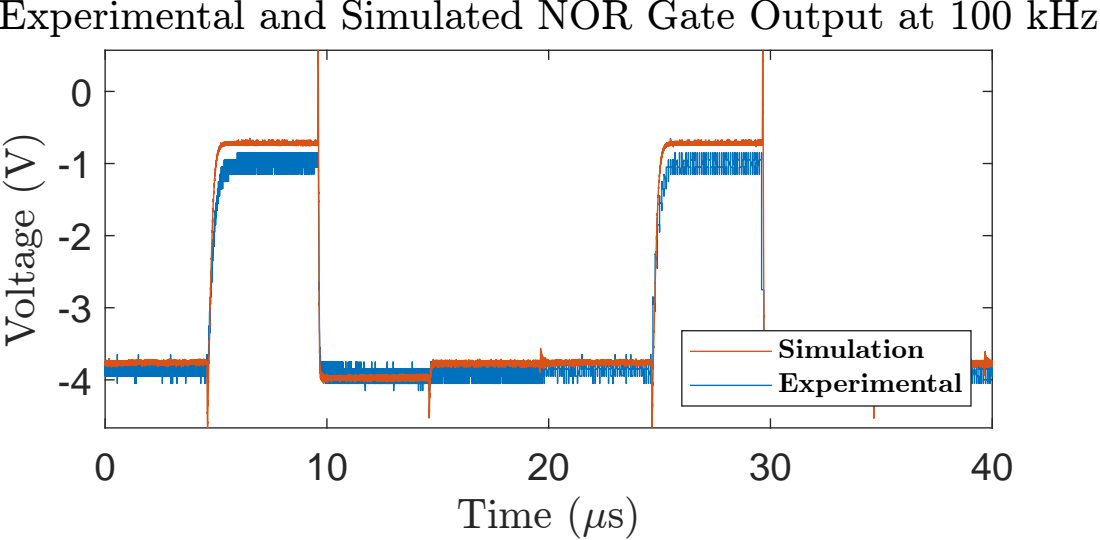
[picture p49: page 1]
Time (7s); Volt; Experimental and Simulated NOR Gate Output at 100 kHz; Simulation Experimental
