cgarryZA/deepJFET/paper/Images/NOR100k.pdf

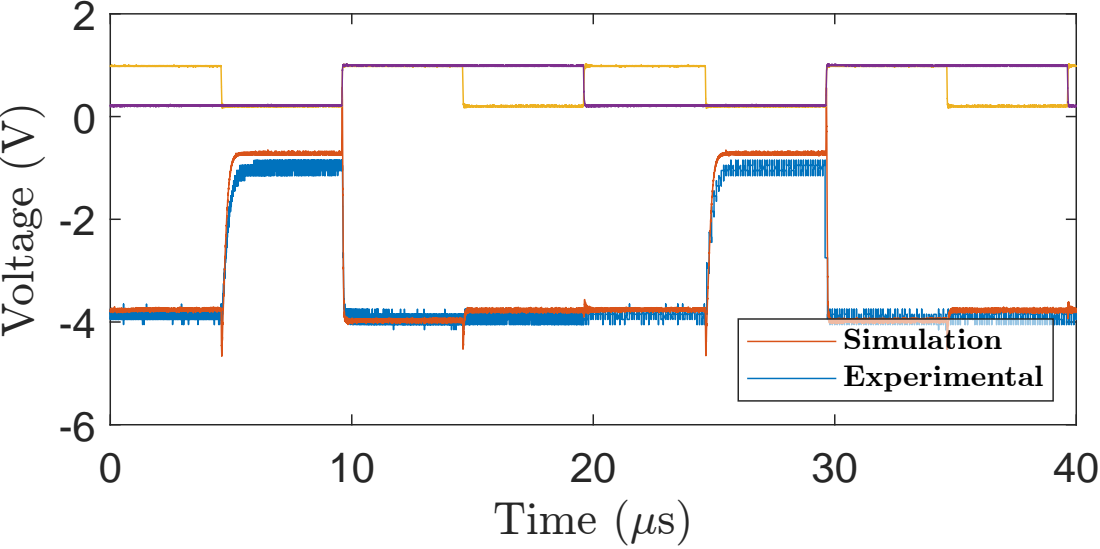
[picture p50: page 1]
40 Time (7s); Voltage (V)
