cgarryZA/deepJFET/paper/Images/NOR800K.pdf

-202

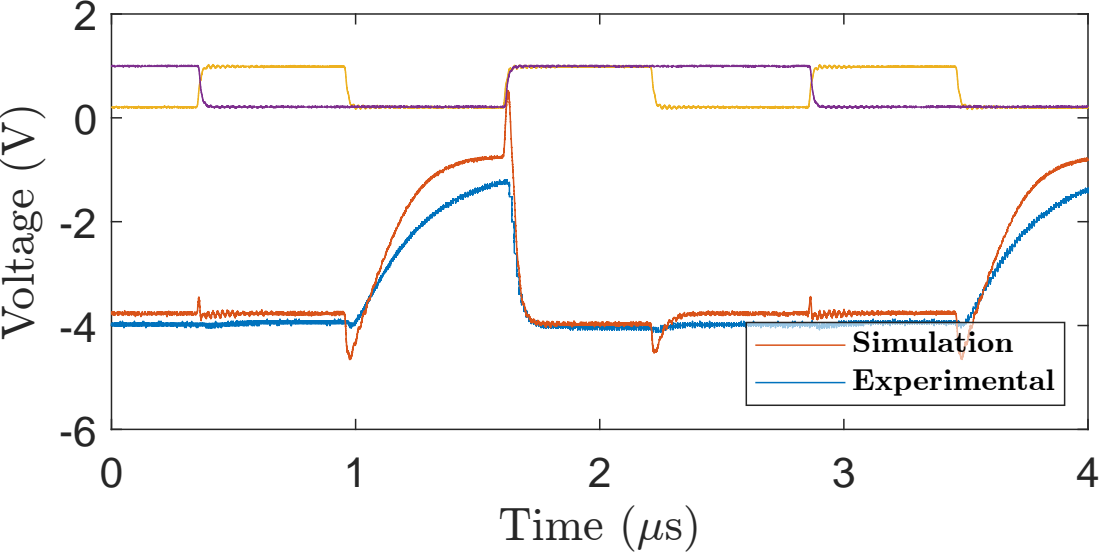
[picture p51: page 1]
Voltage (V)
