cgarryZA/deepJFET/paper/Images/ProgramCounterAnnotated.pdf

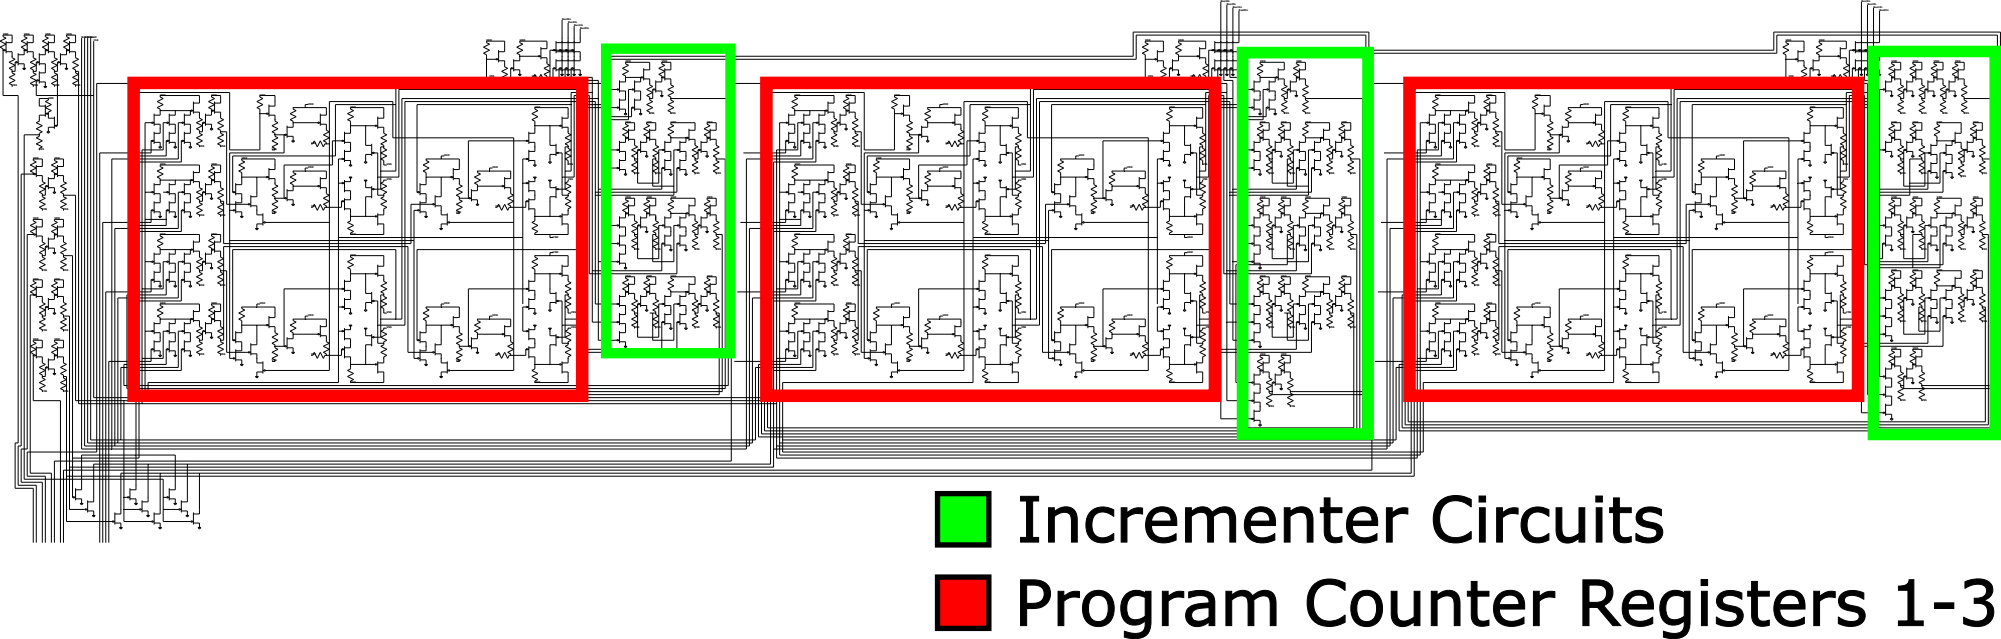
[picture p52: page 1]
VDD; VSS; Bus3Bus2Bus1Bus0 CLK; Bus3In Bus2In Bus1In Bus0In

VSS
Incrementer Circuits
Program Counter Registers 1-3
