cgarryZA/deepJFET/paper/Images/StackAnnotated.pdf

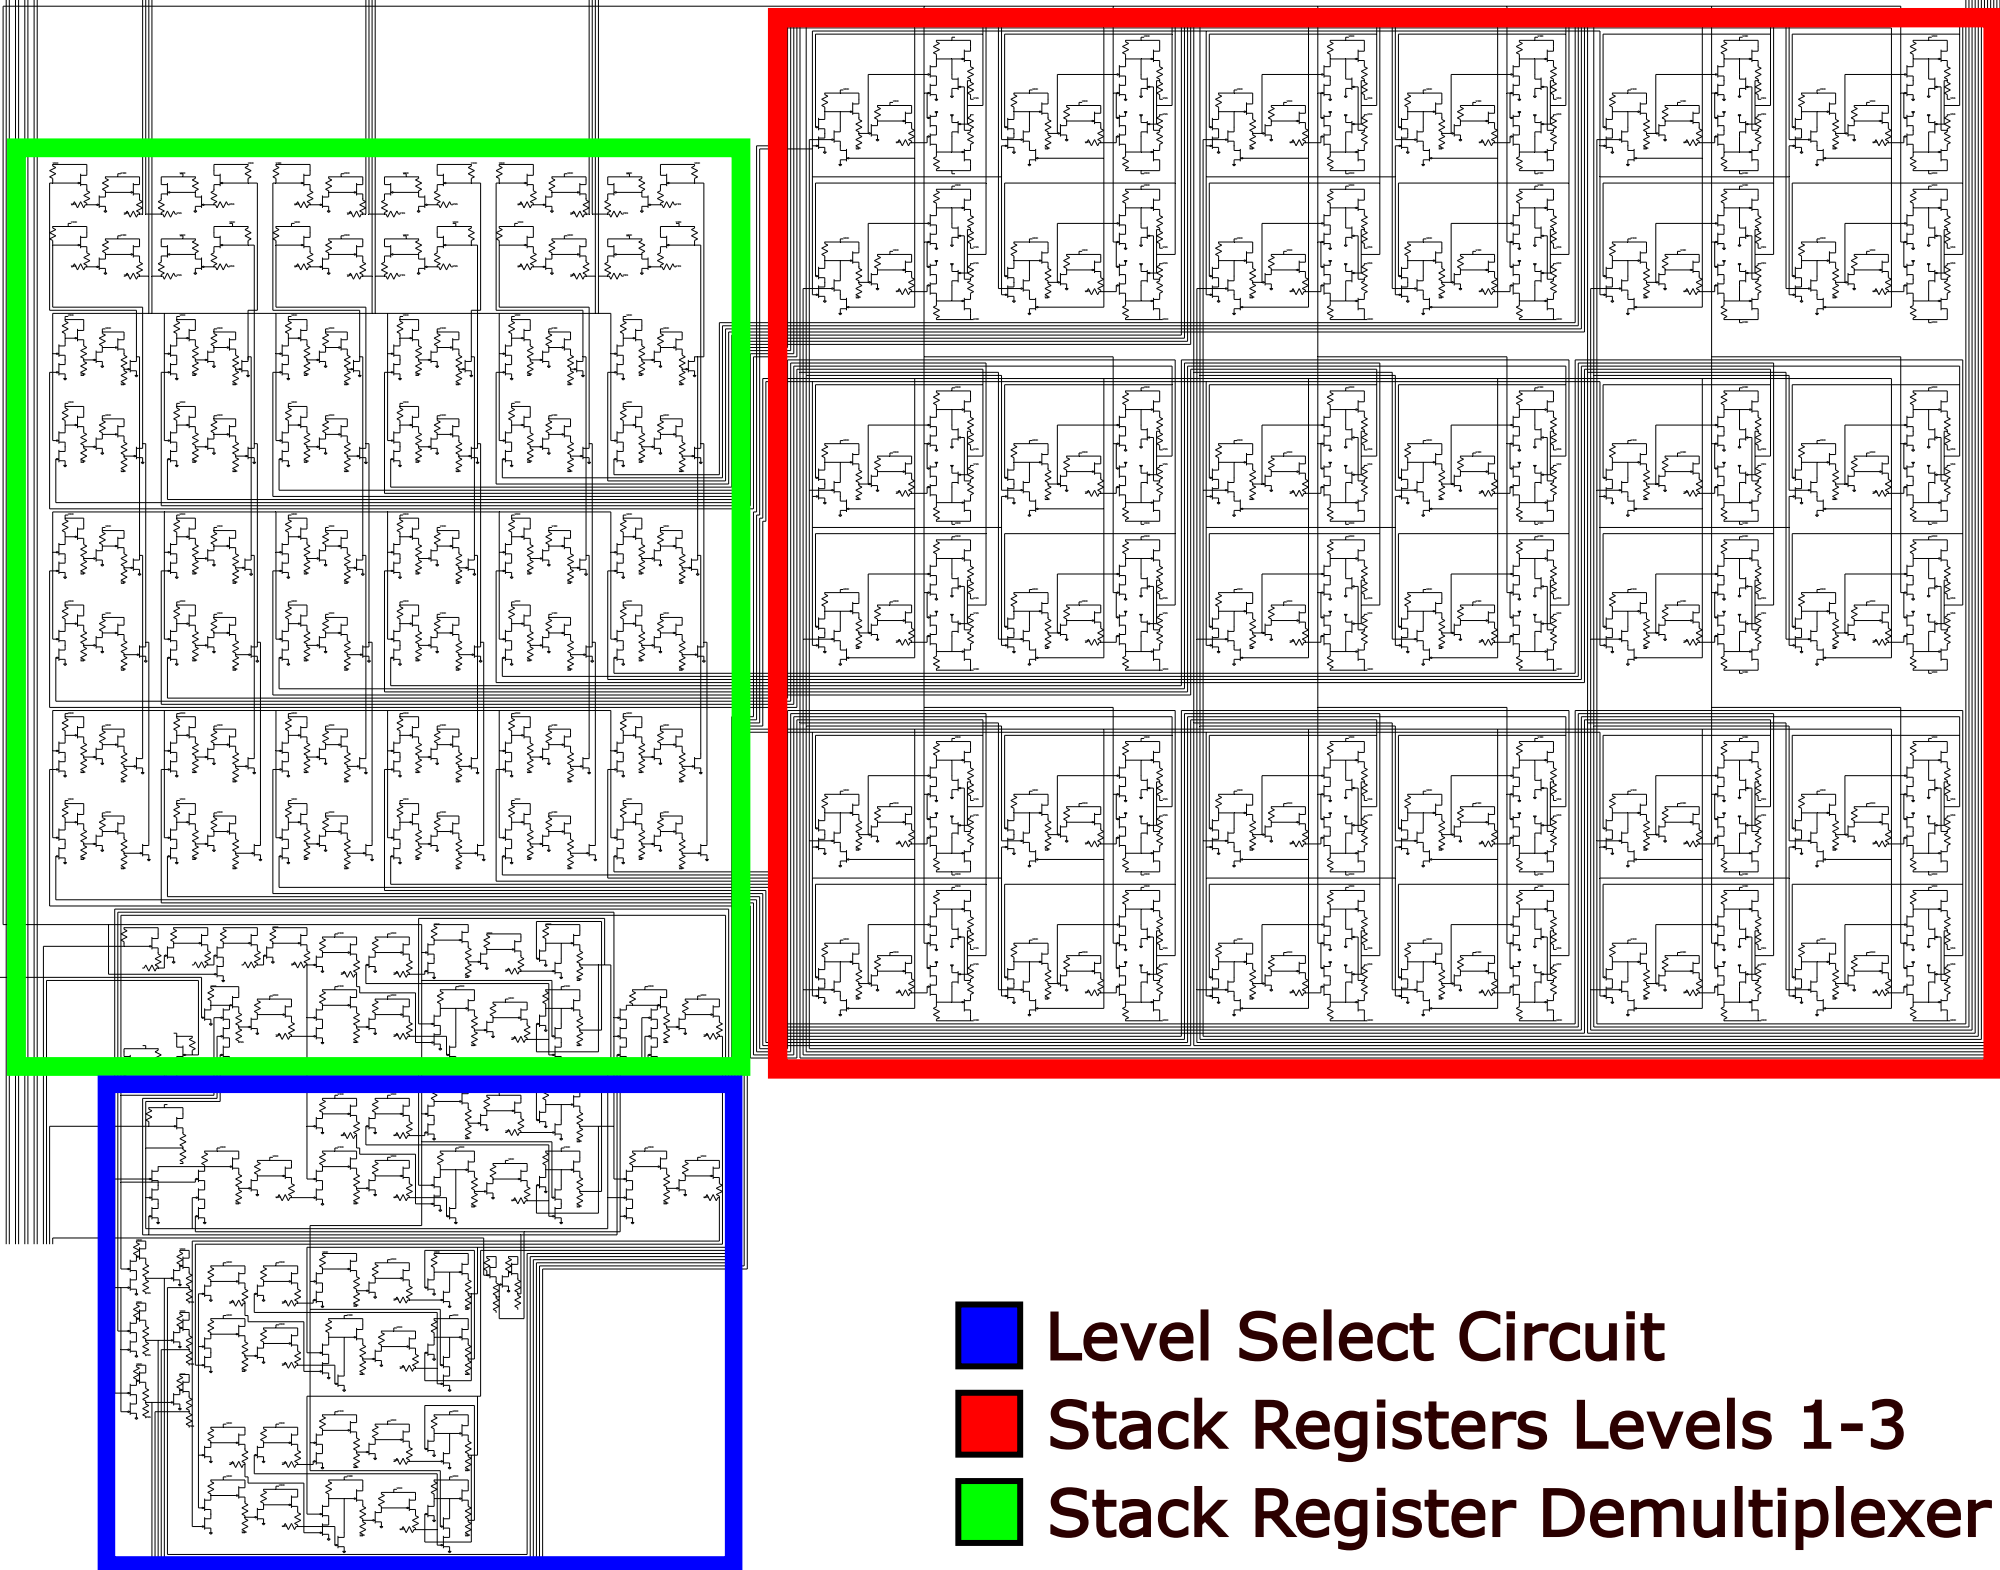
[picture p53: page 1]
VSS; VDD

VDD

VSS

Level Select Circuit
Stack Registers Levels 1-3

Stack Register Demultiplexer
