cgarryZA/deepJFET/paper/Appendices/ACC.pdf

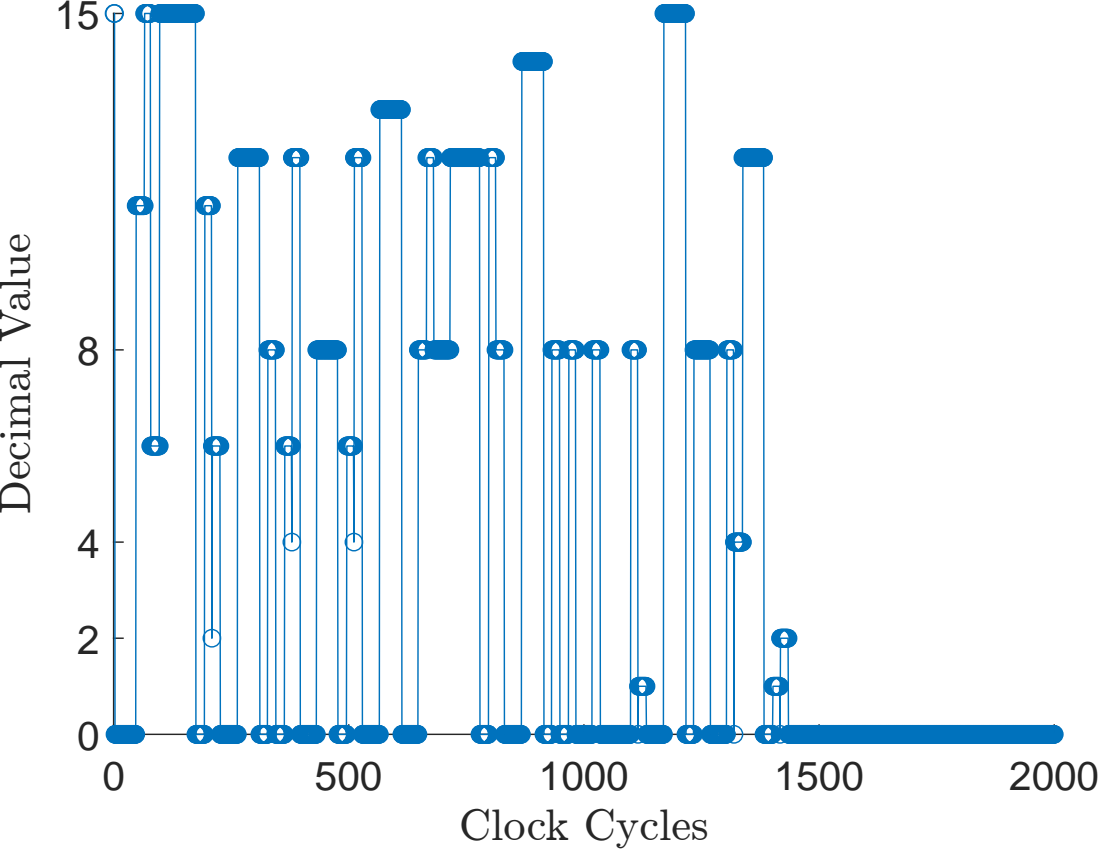
[picture p54: page 1]
2000 Clock Cycles; Decimal Value
