cgarryZA/deepJFET/paper/Appendices/CF.pdf

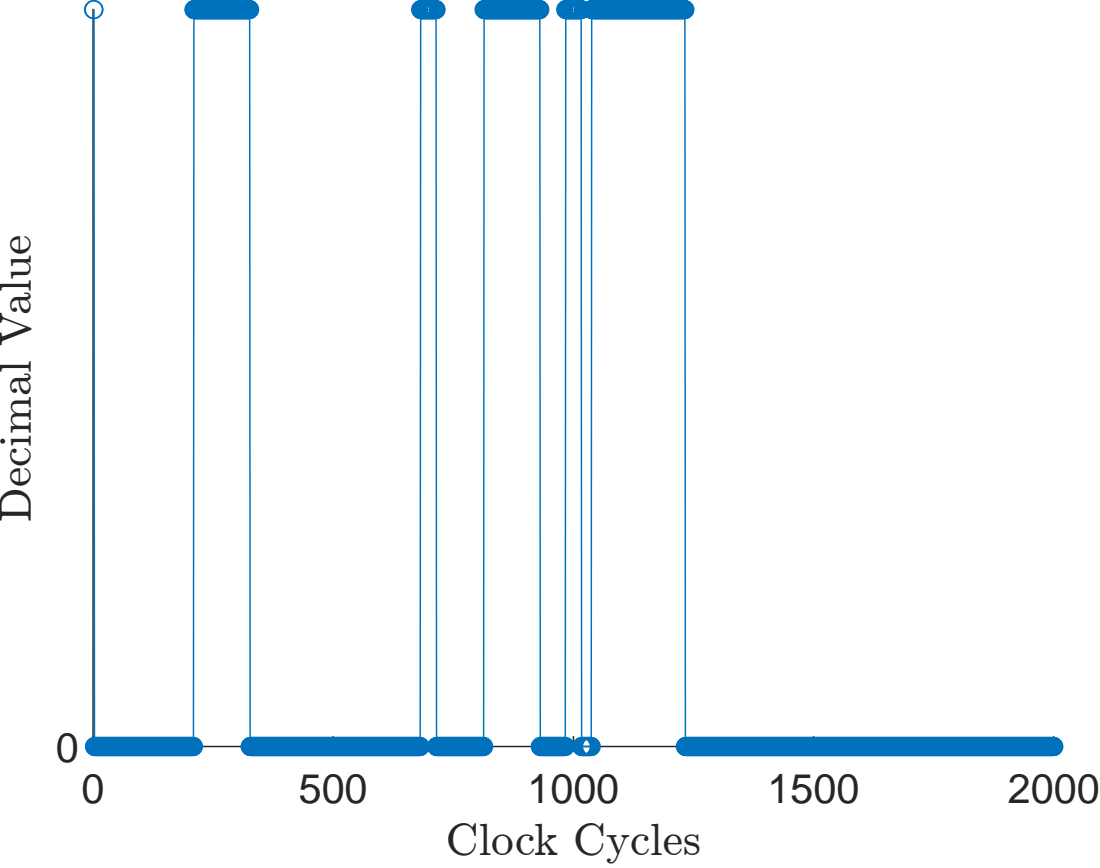
[picture p55: page 1]
2000 Clock Cycles; Decimal Value
