cgarryZA/deepJFET/paper/Appendices/ROMUnannotated.pdf

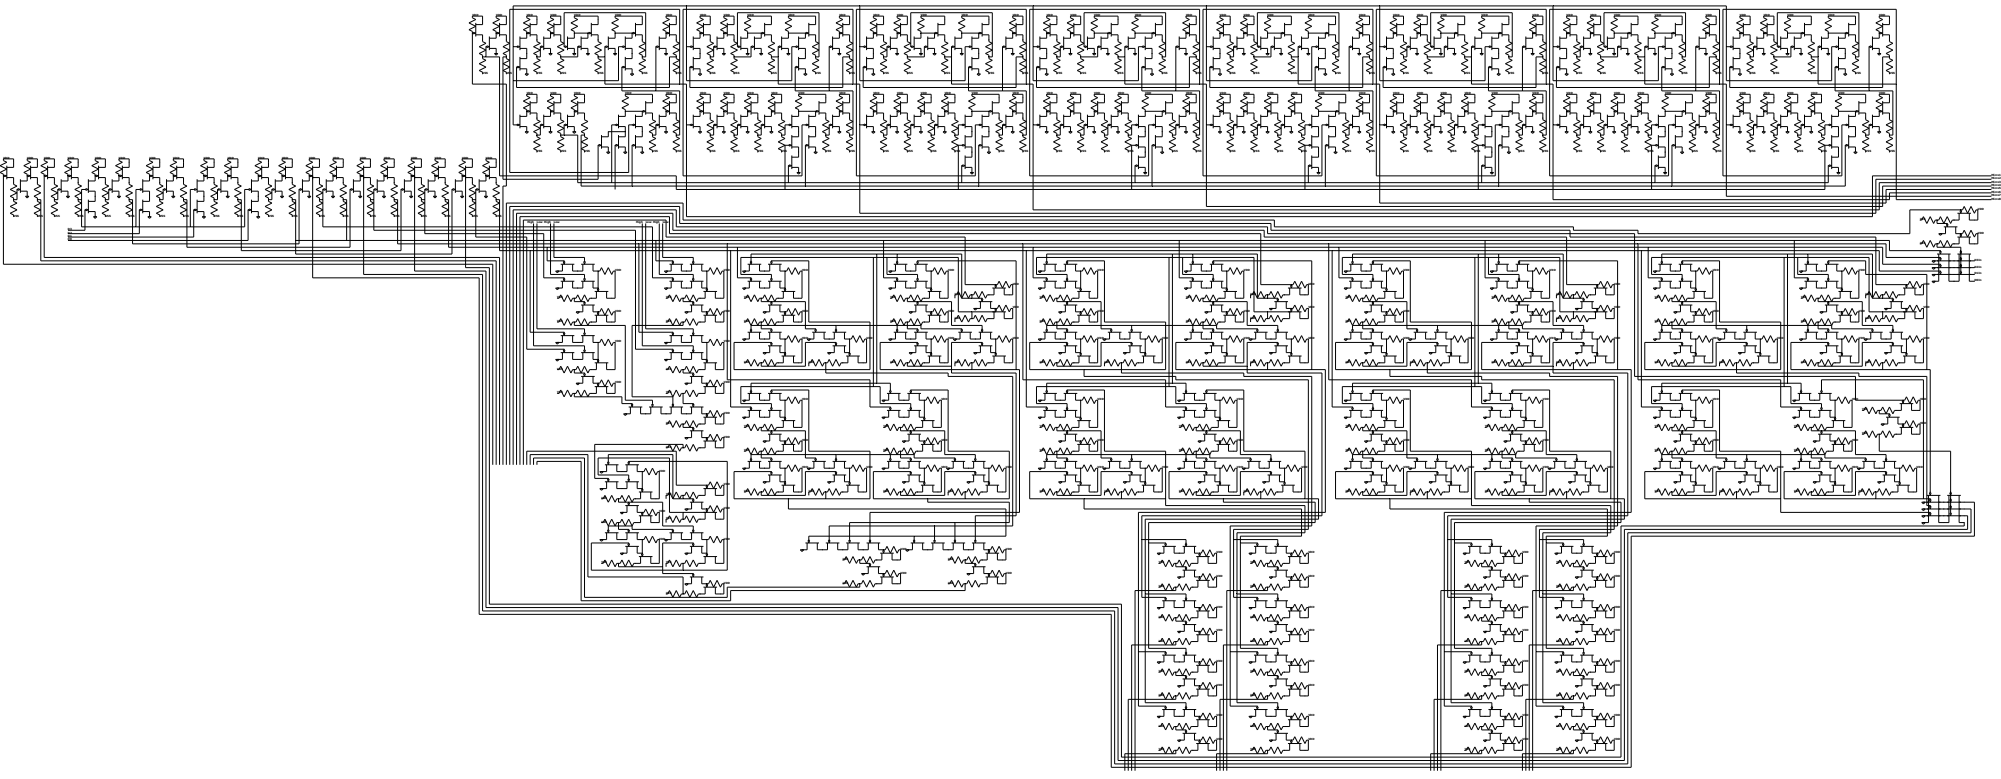
[picture p56: page 1]
VDD; VSS; Micro8; Micro7; Micro6; Micro5; Micro4; Micro3; Micro2; Micro1; High Low High Low; LowHigh
