cgarryZA/deepJFET/paper/Appendices/Scratchpad0.pdf

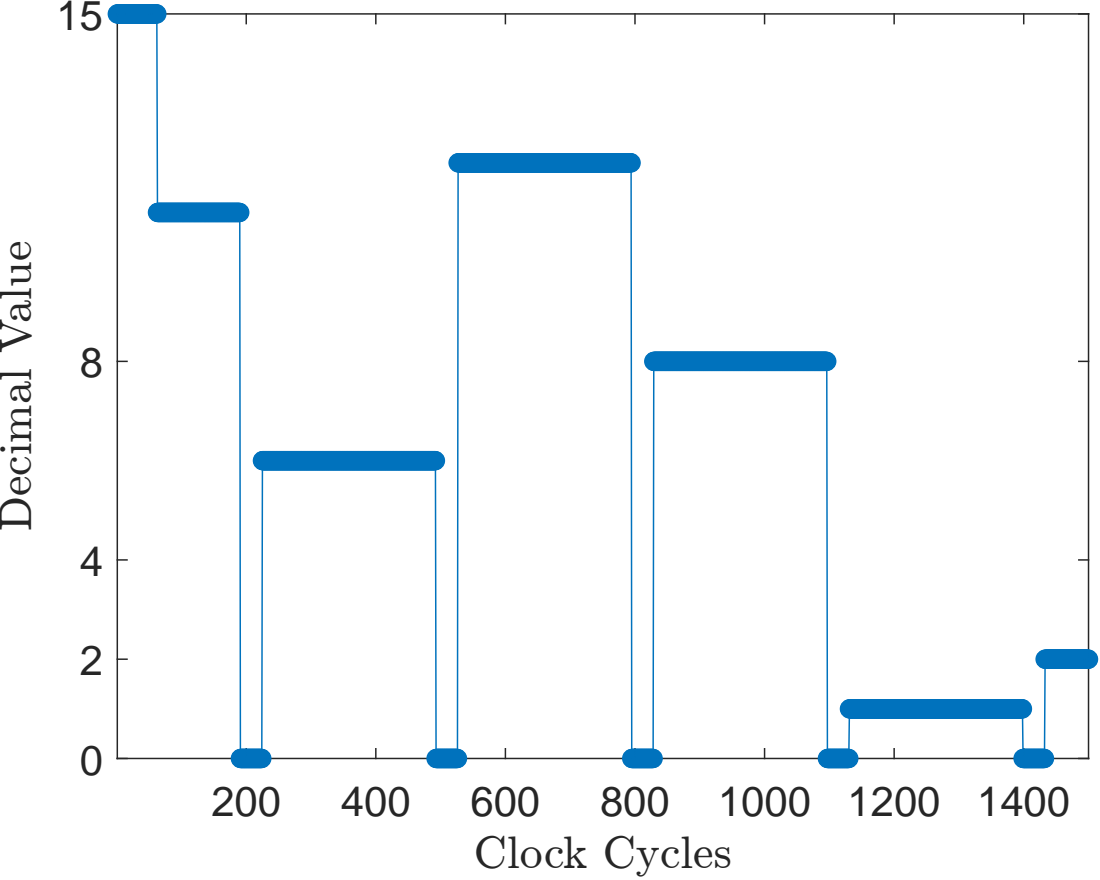
[picture p57: page 1]
Clock Cycles; cim; al Valu
