cgarryZA/deepJFET/paper/Appendices/Scratchpad1.pdf

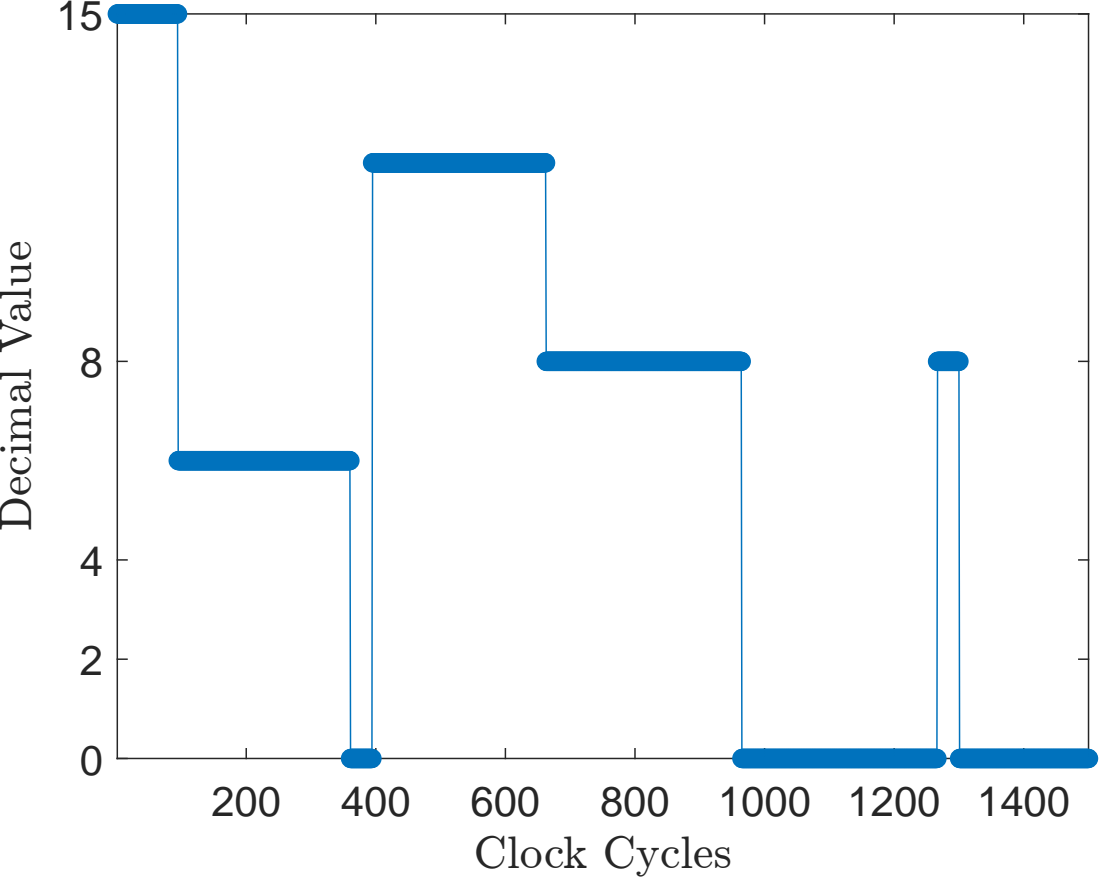
[picture p58: page 1]
Clock Cycles; cim; al Valu
