cgarryZA/deepJFET/paper/Appendices/Scratchpad2.pdf

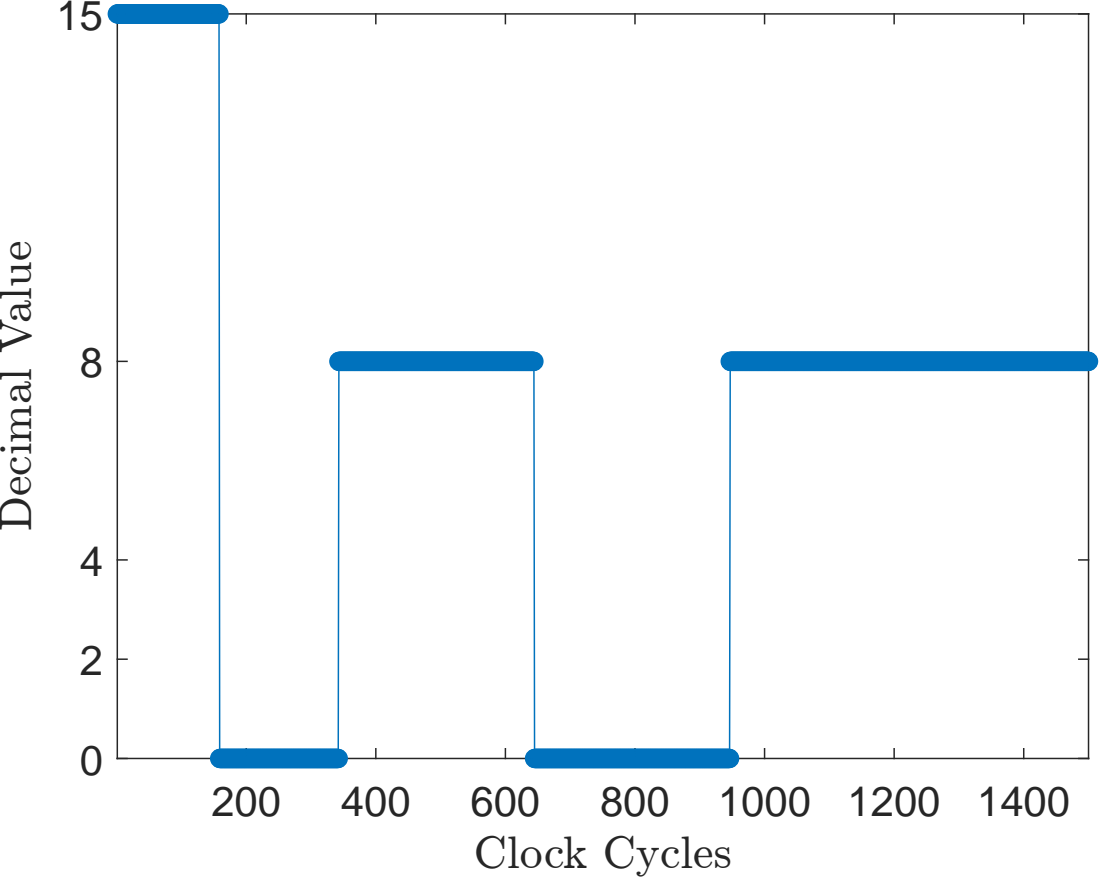
[picture p59: page 1]
Clock Cycles; cim; al Valu
