cgarryZA/deepJFET/paper/Appendices/Scratchpad3.pdf

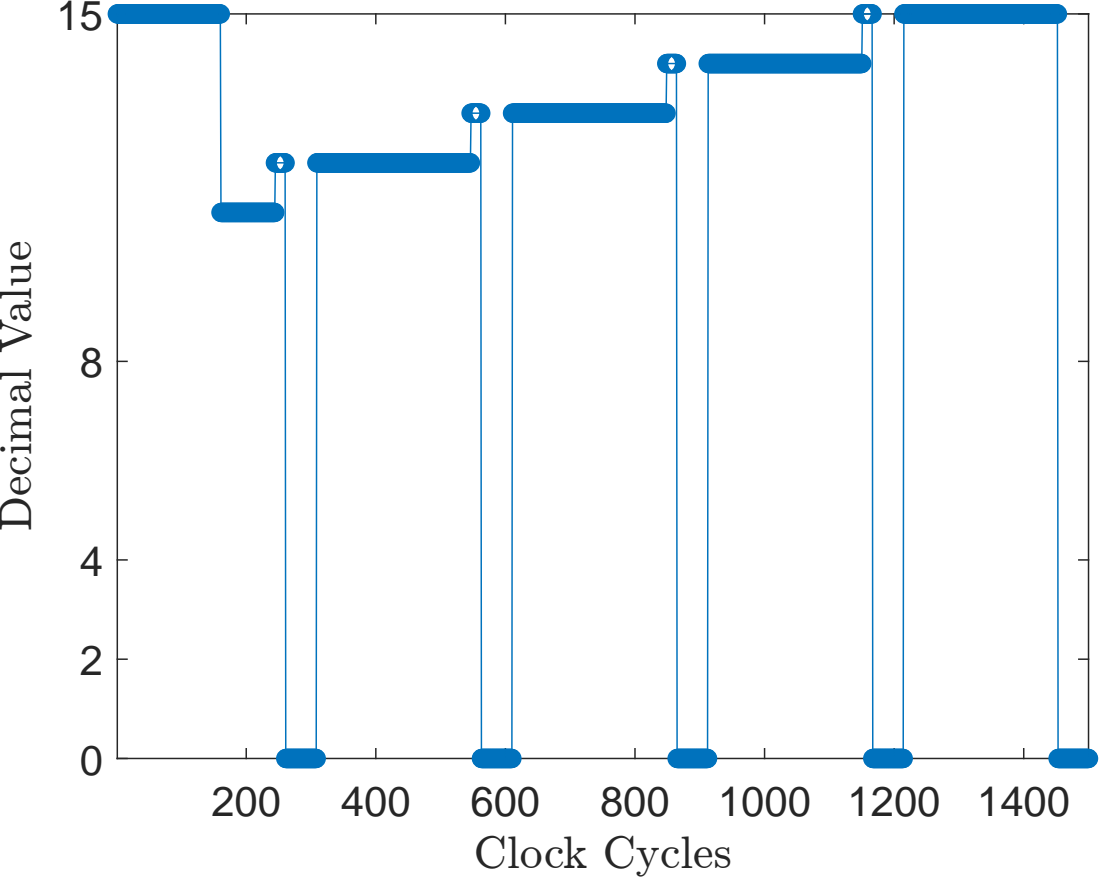
[picture p60: page 1]
Clock Cycles; cim; al Valu
