cgarryZA/deepJFET/paper/Images/0.5x0.5_1.pdf

## Scratch Pad Registers 12 and 13 Value Over Time

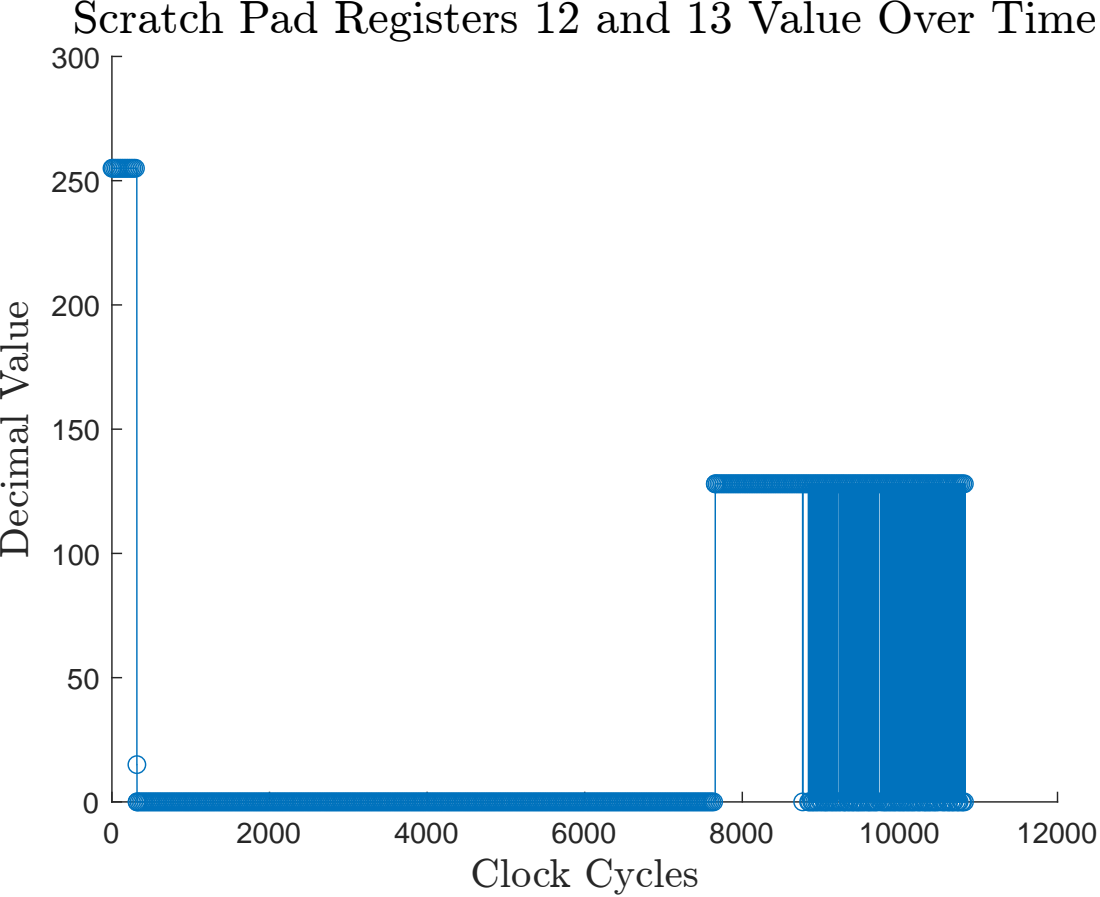
[picture p61: page 1]
Clock Cycles; cim; al Valu
