cgarryZA/deepJFET/paper/Images/0.5x0.5_2.pdf

## Scratch Pad Registers 14 and 15 Value Over Time

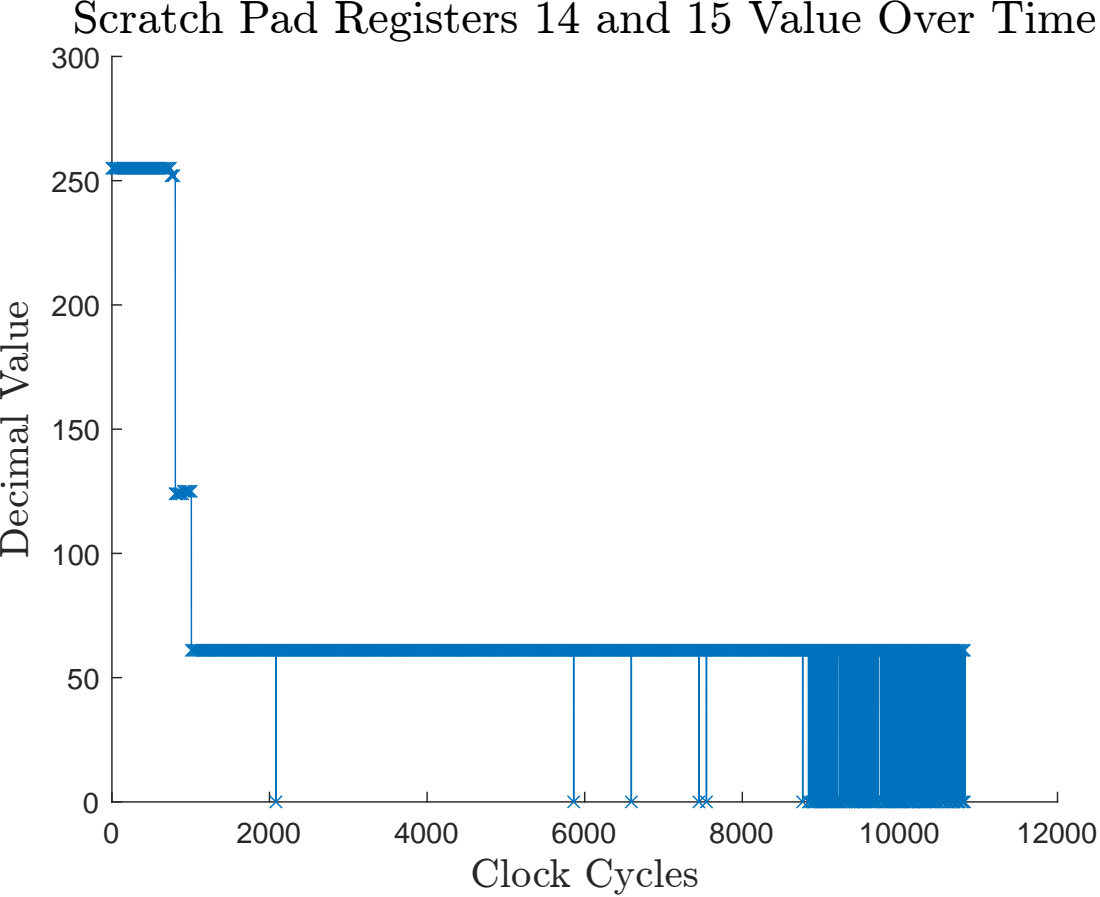
[picture p62: page 1]
Clock Cycles; cim; al Valu
