cgarryZA/deepJFET/paper/Images/11AND1.pdf

## Scratch Pad Register 0 Value Over Time

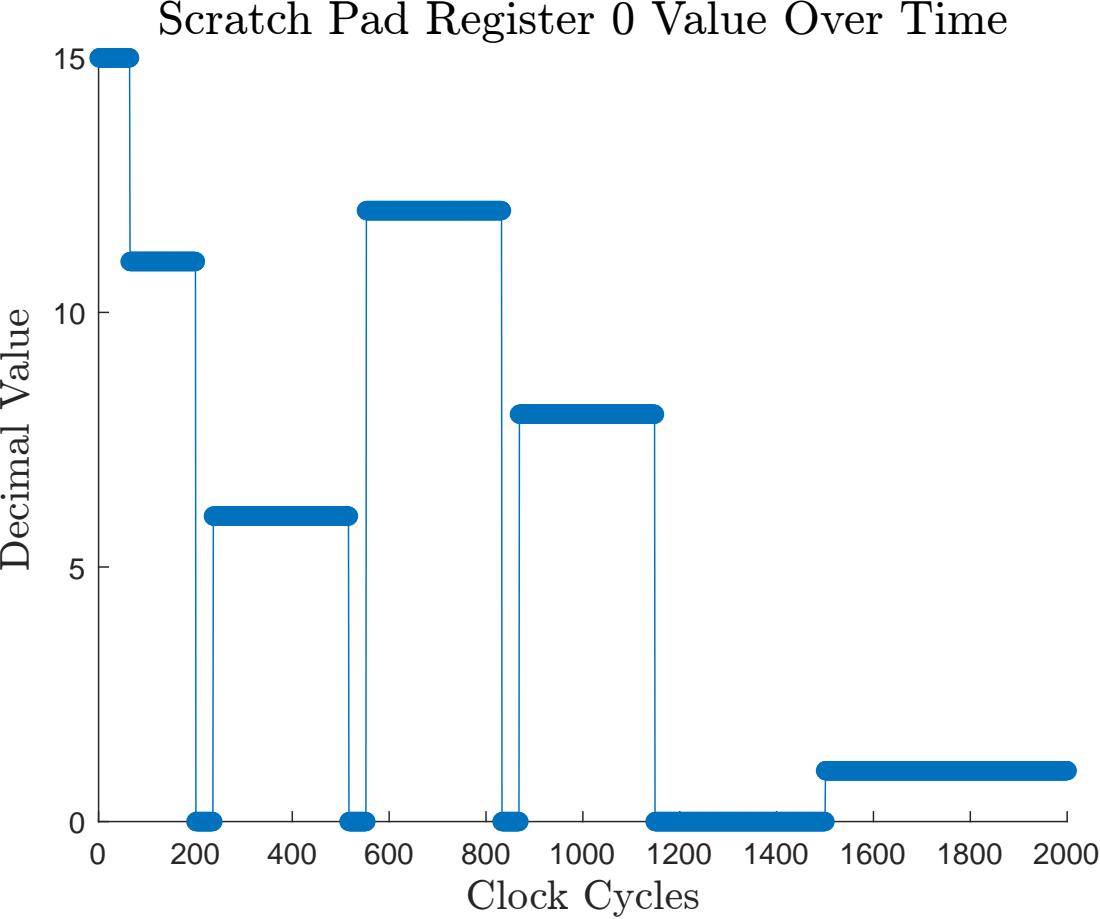
[picture p63: page 1]
Clock Cycles; cim; al Valu
