cgarryZA/deepJFET/paper/Images/11AND6.pdf

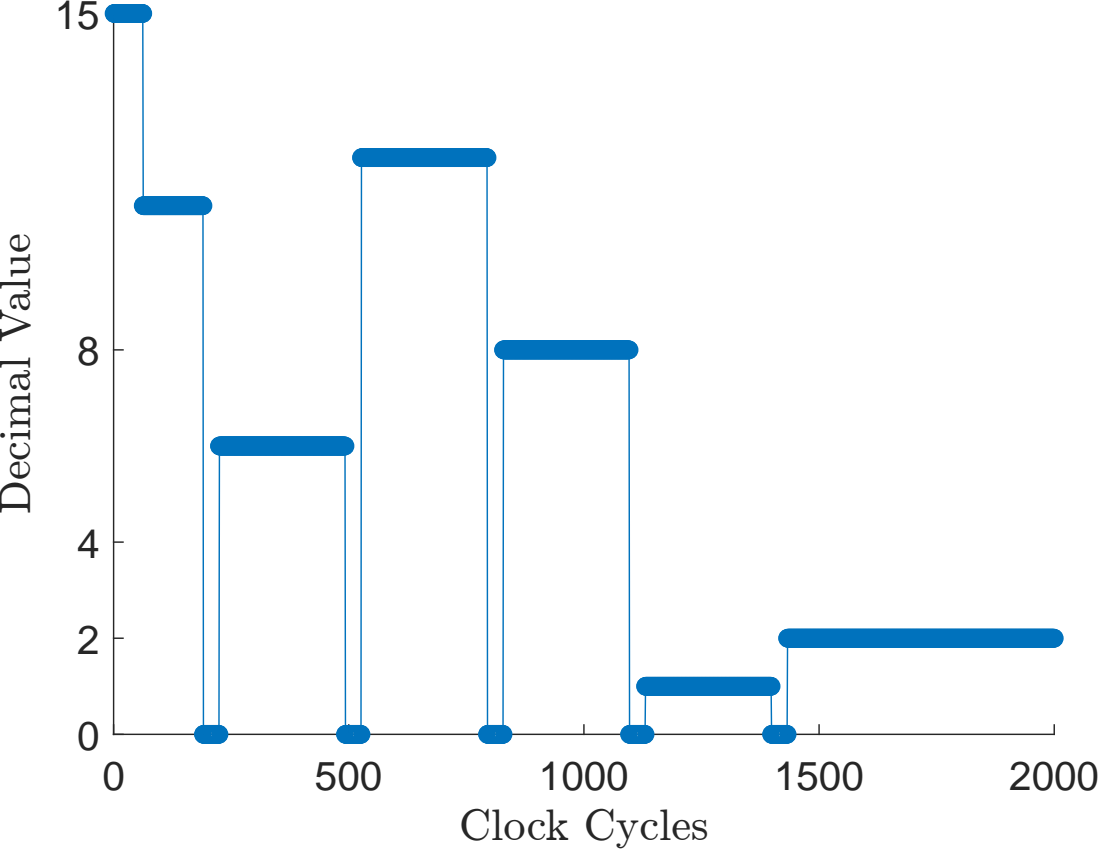
[picture p64: page 1]
2000 Clock Cycles; Decimal Value
