cgarryZA/deepJFET/paper/Images/ALU.pdf

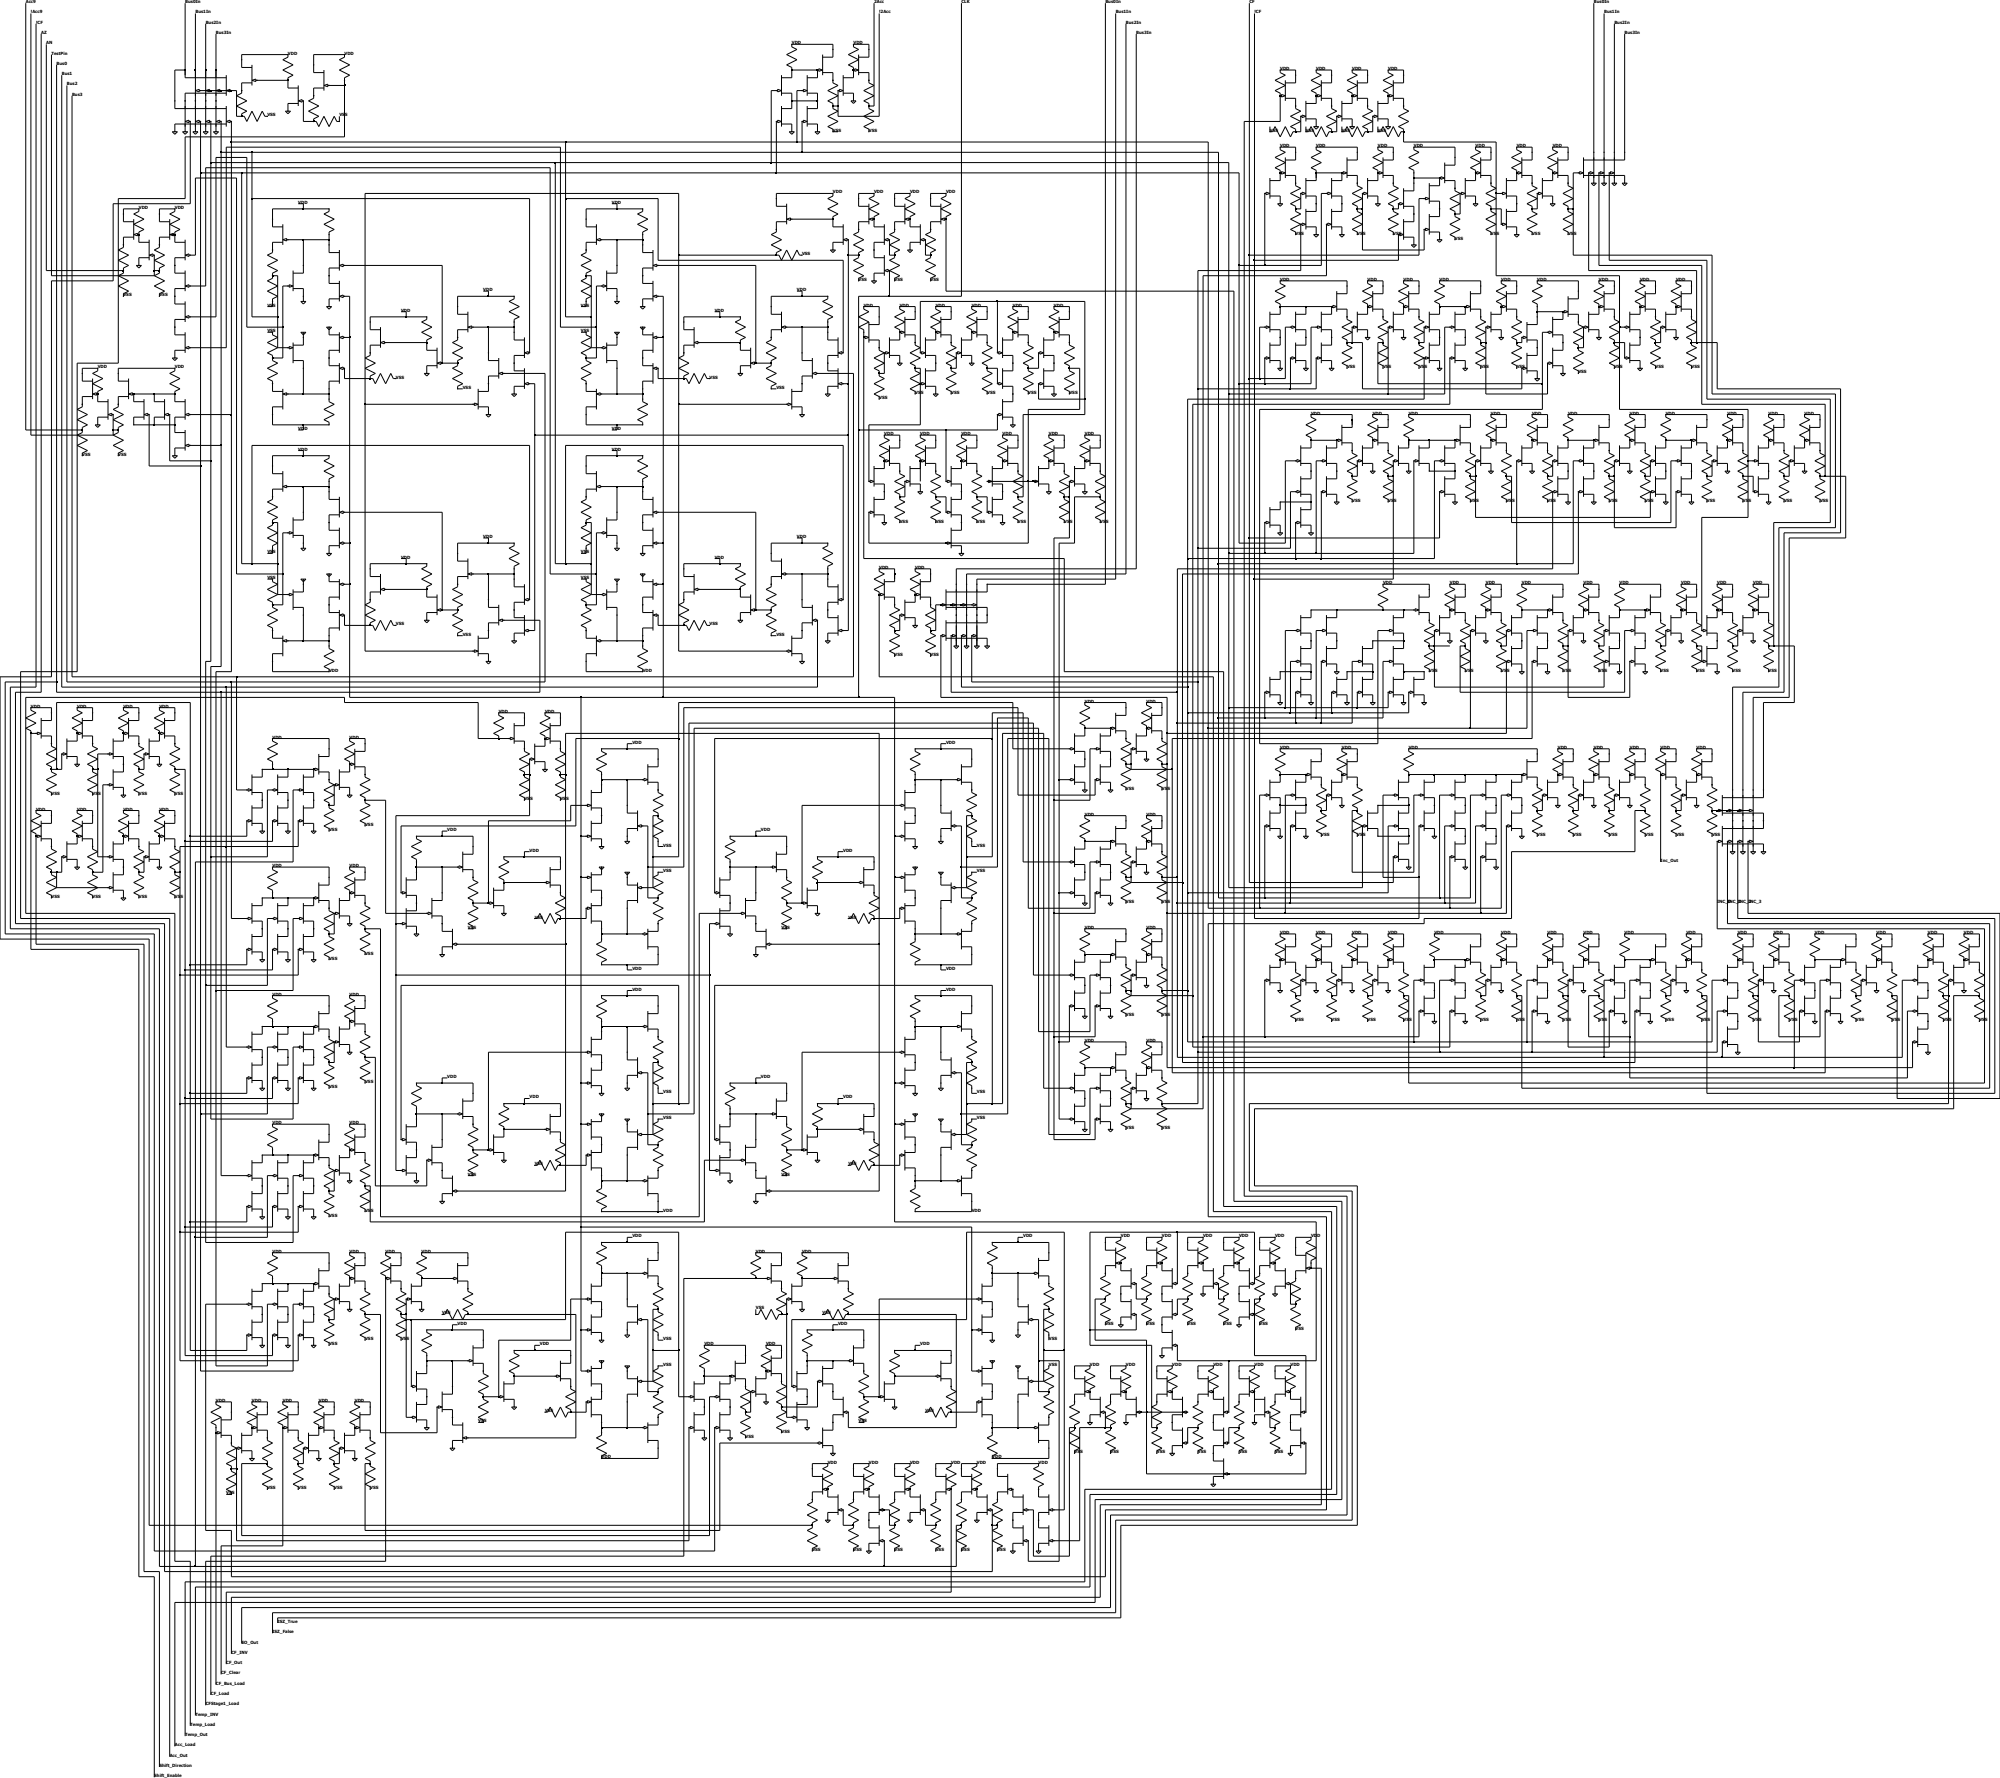
[picture p65: page 1]
VDD; VSS; Temp_INV; Acc_Load; Acc_Out; CF_Out; Temp_Load; CF_Bus_Load; CFStage1_Load; Shift_Enable; Shift_Direction; CF_Load; Temp_Out; CF_INV; CF_Clear; EO_Out; INC_1INC_2; ISZ_False; INC_0; ISZ_True; Inc_Out; INC_3; Bus3; Bus2; Bus1; Bus0; Bus3In; Bus2In; Bus1In; Bus0In; Acc9; !Acc9; CLK; TestPin; !2Acc; 2Acc
