cgarryZA/deepJFET/paper/Images/DFlipFlop.pdf

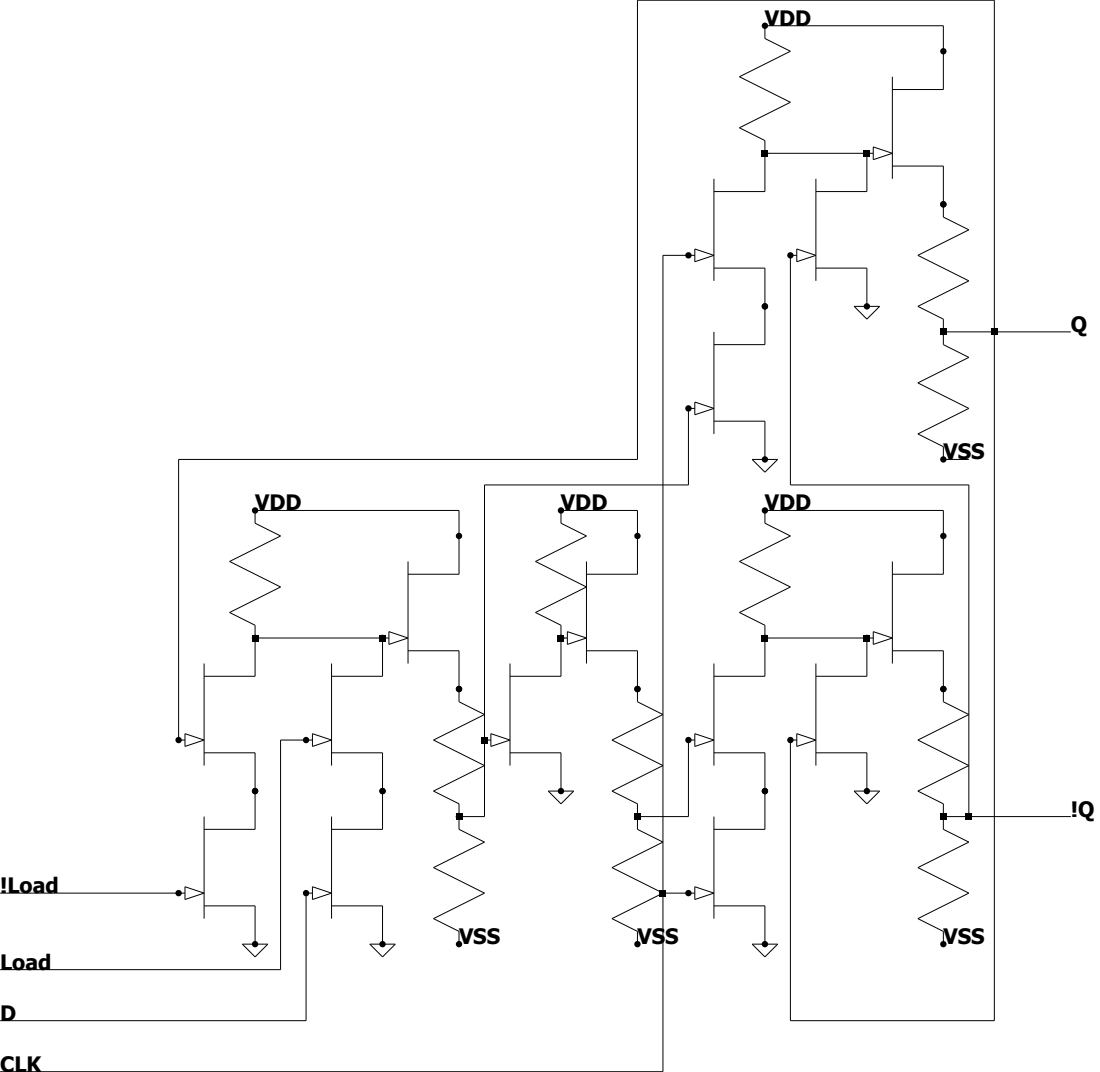
[picture p66: page 1]
VDD; VSS; Load; !Load; CLK
