cgarryZA/deepJFET/paper/Images/Instruction.pdf

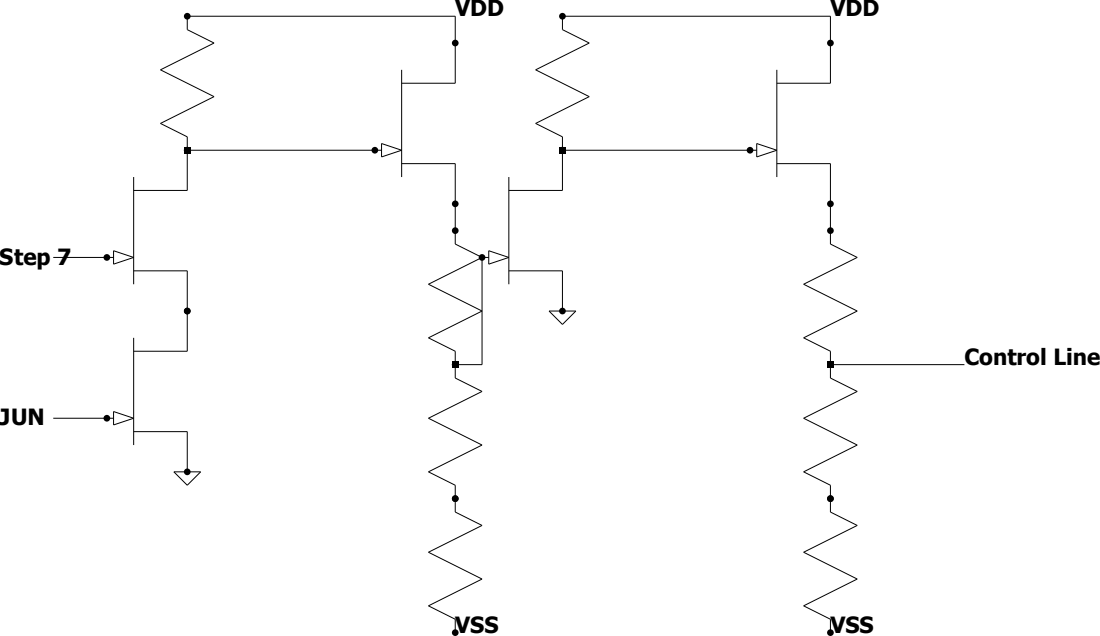
[picture p67: page 1]
VDD; VSS; Step 7; JUN; Control Line
