cgarryZA/deepJFET/paper/Images/Inverter.pdf

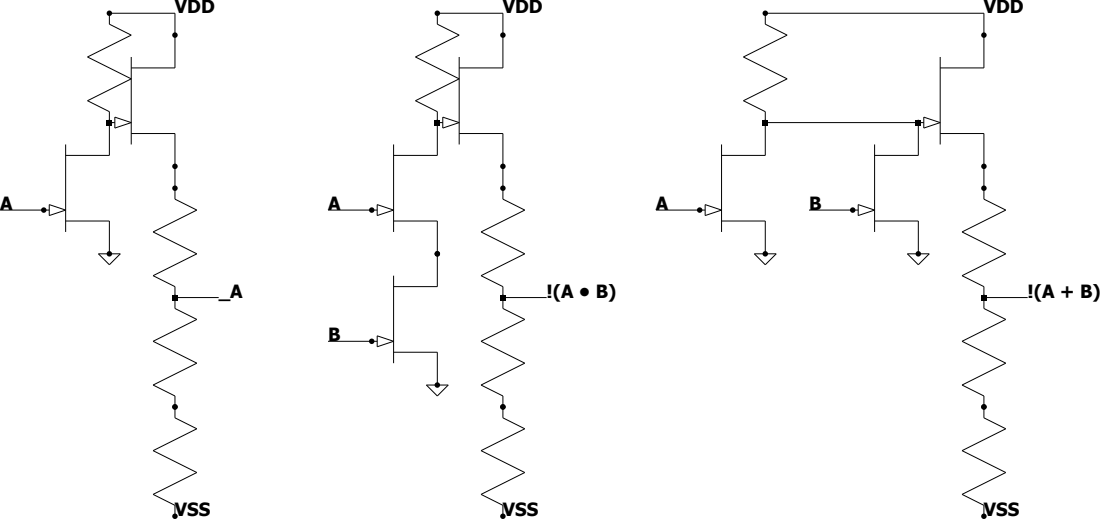
[picture p68: page 1]
VDD; VSS
