cgarryZA/deepJFET/paper/Images/Mult.pdf

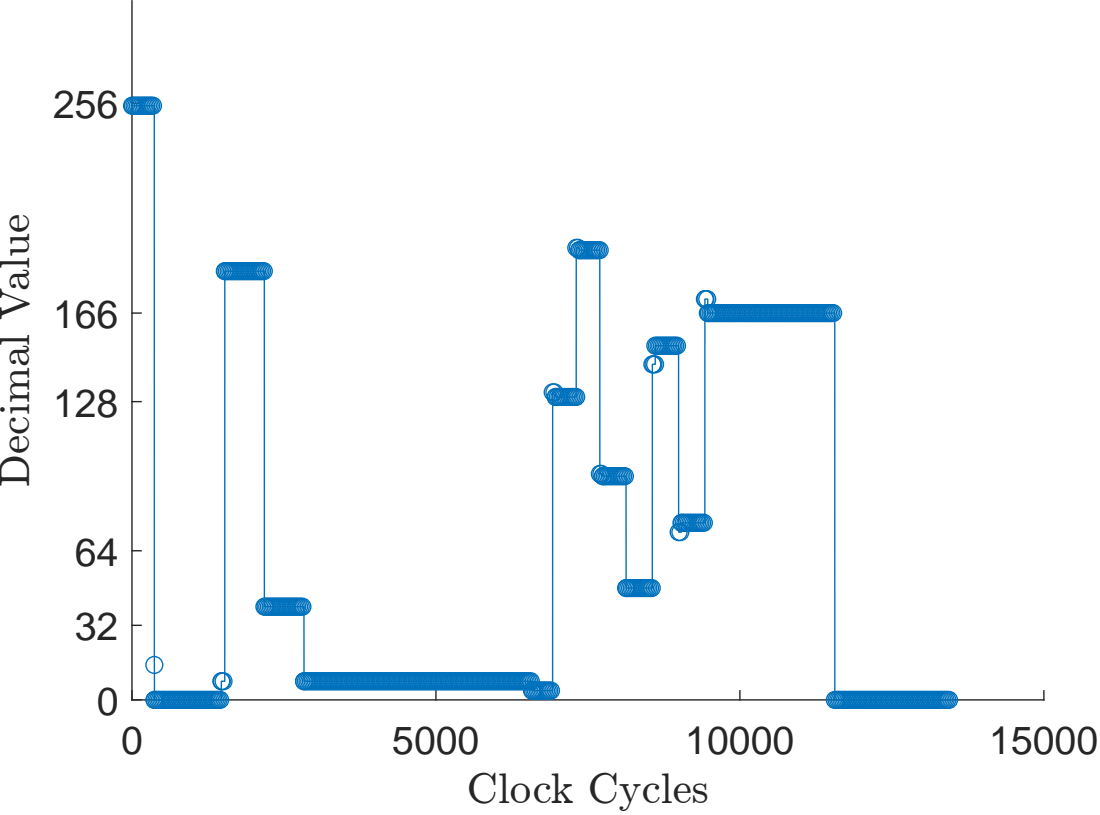
[picture p69: page 1]
15000 Clock Cycles; Decimal Value
