cgarryZA/deepJFET/paper/Images/Mult2.pdf

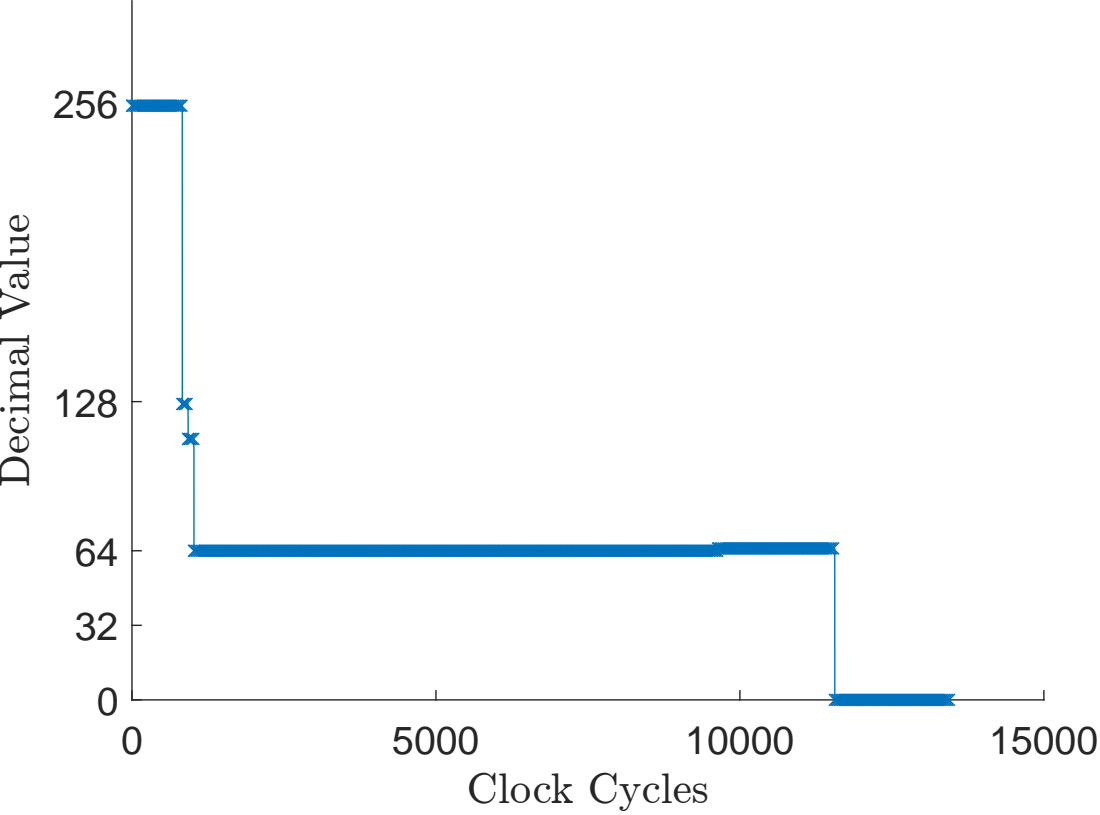
[picture p70: page 1]
15000 Clock Cycles; Decimal Value
