cgarryZA/deepJFET/paper/Images/MultiGate.pdf

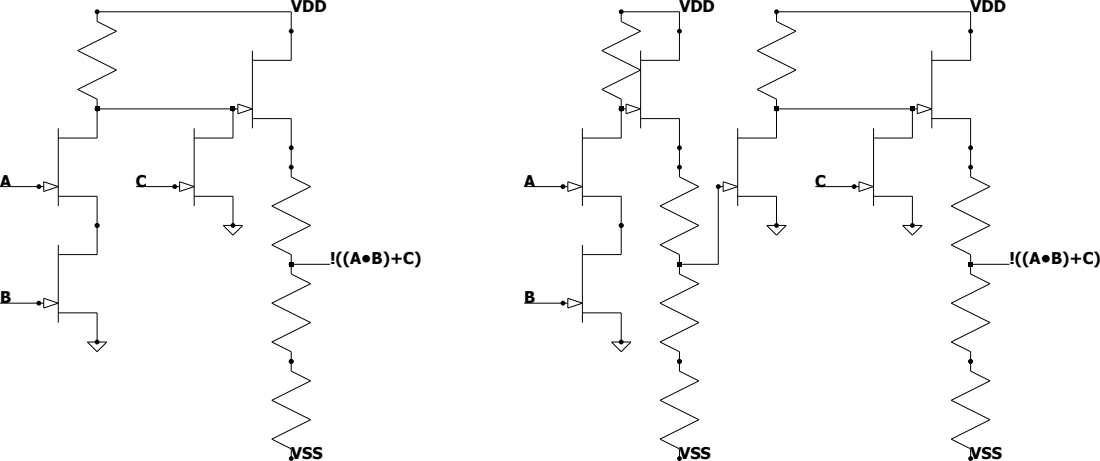
[picture p71: page 1]
VDD; VSS
