cgarryZA/deepJFET/paper/Images/Pins.pdf

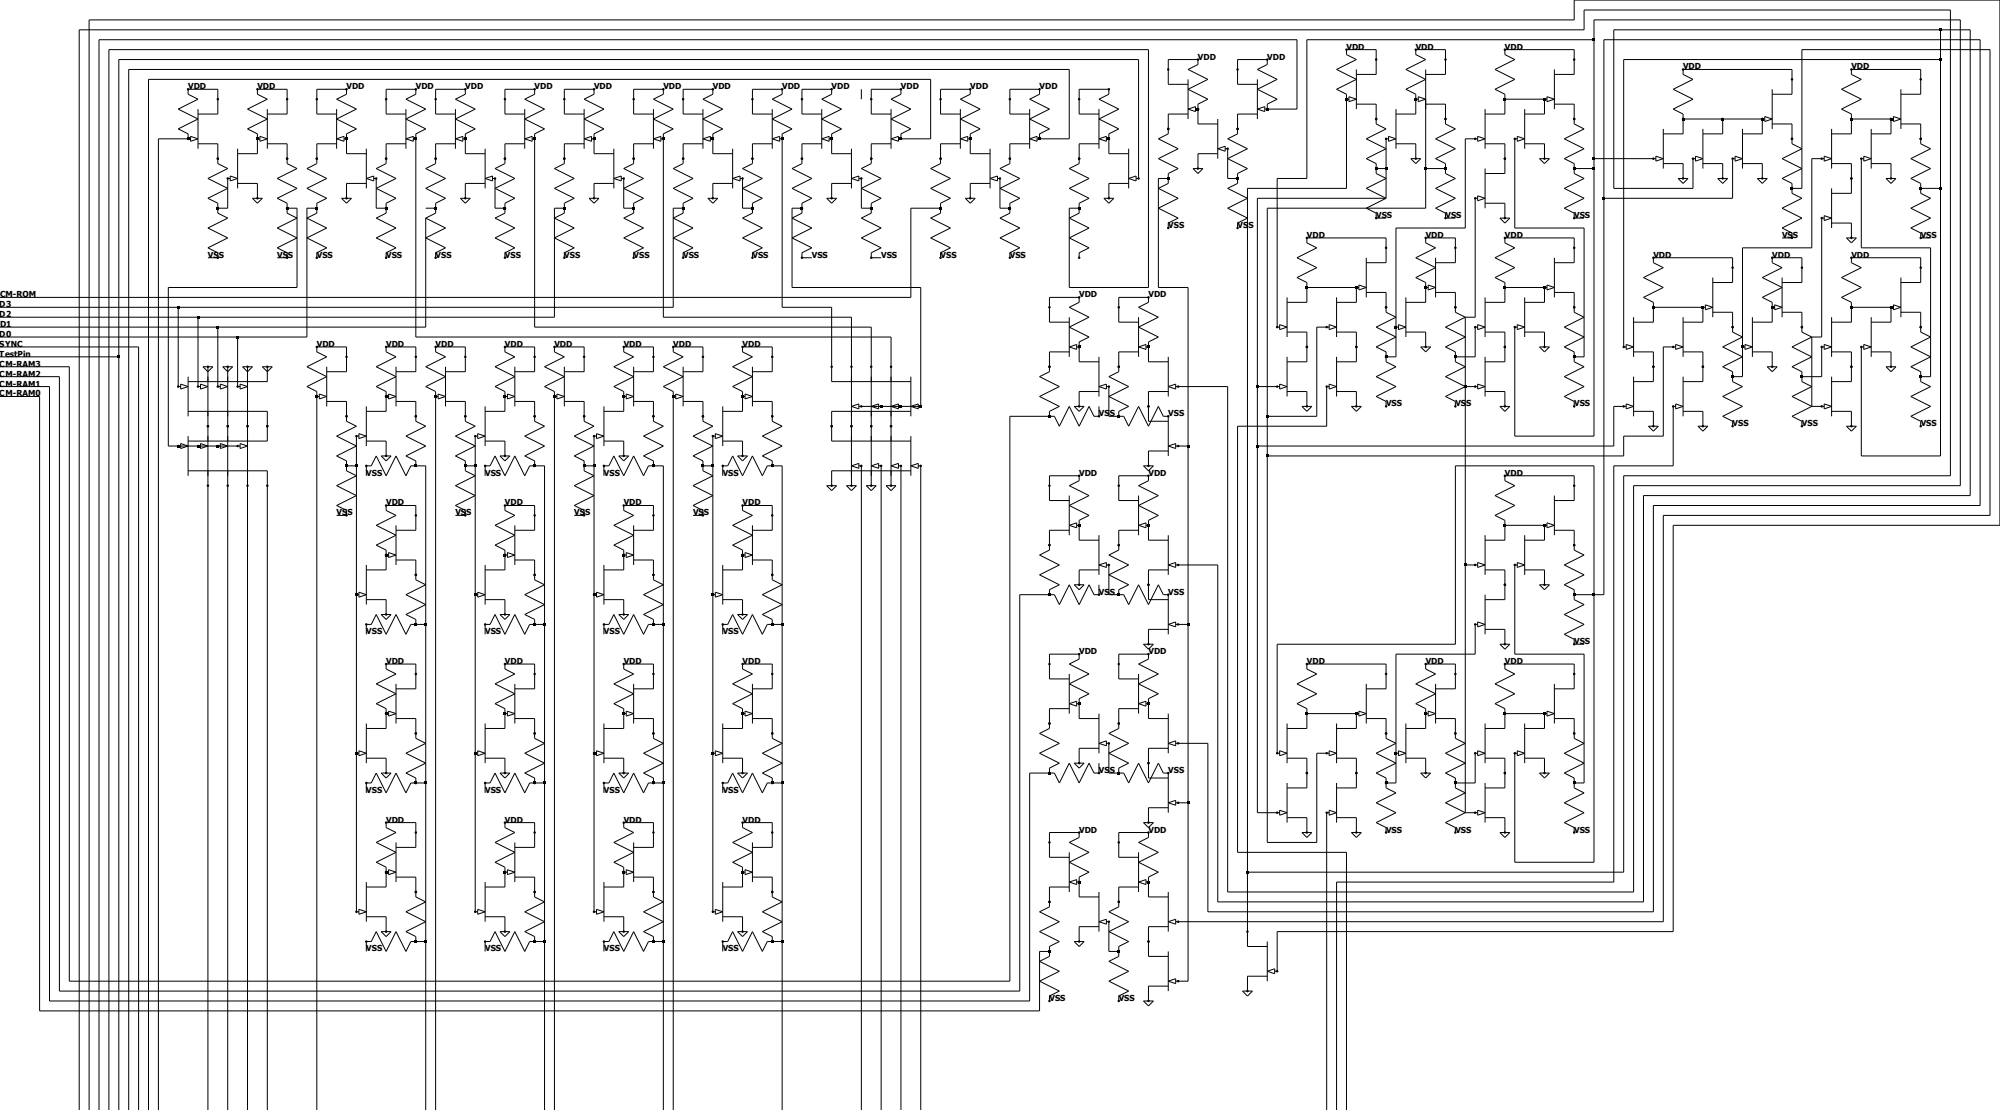
[picture p72: page 1]
VDD; VSS; SYNC TestPin; CM-ROM; CM-RAM3 CM-RAM2 CM-RAM1 CM-RAM0
