cgarryZA/deepJFET/paper/Images/ProgramCounter.pdf

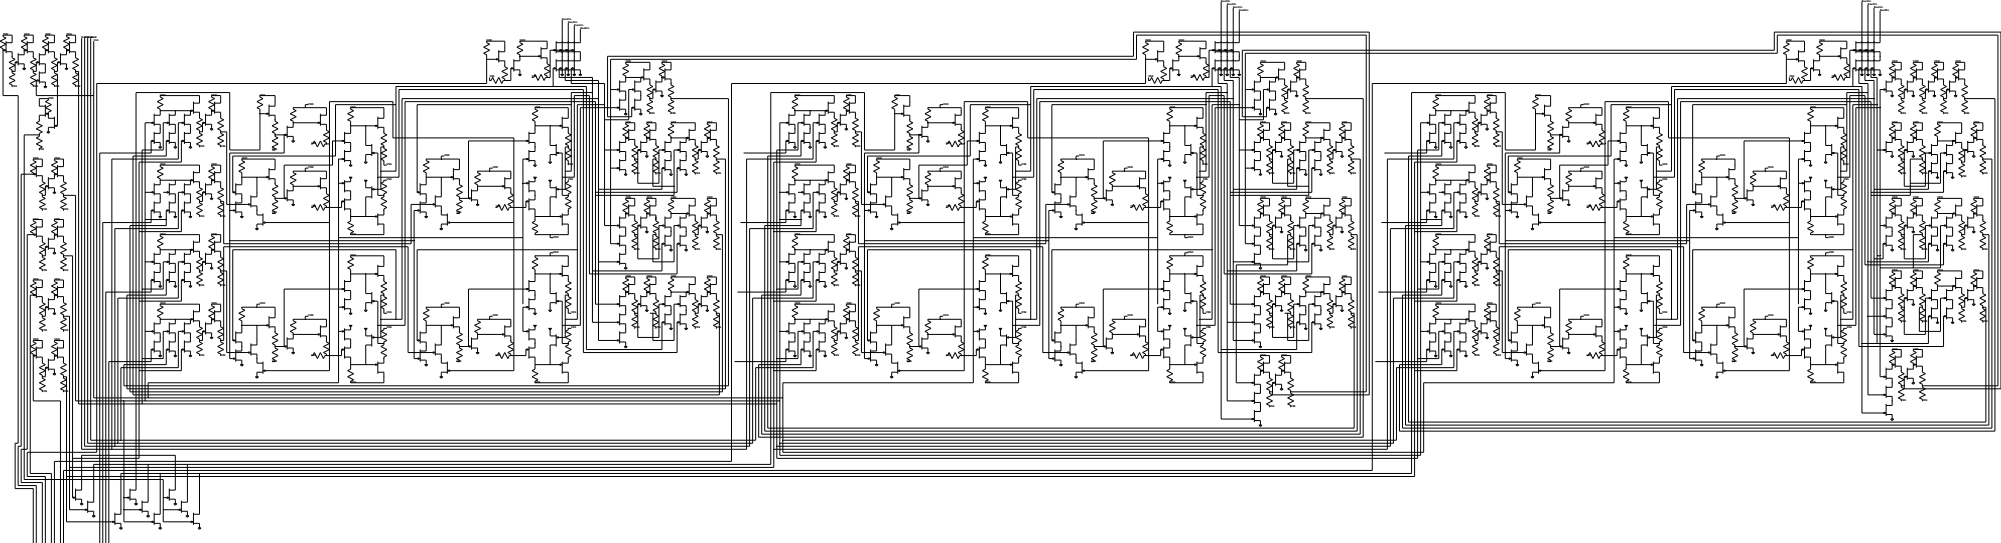
[picture p73: page 1]
VDD; VSS; Bus3Bus2Bus1Bus0 CLK; Bus3In Bus2In Bus1In Bus0In
