cgarryZA/deepJFET/paper/Images/ROM.pdf

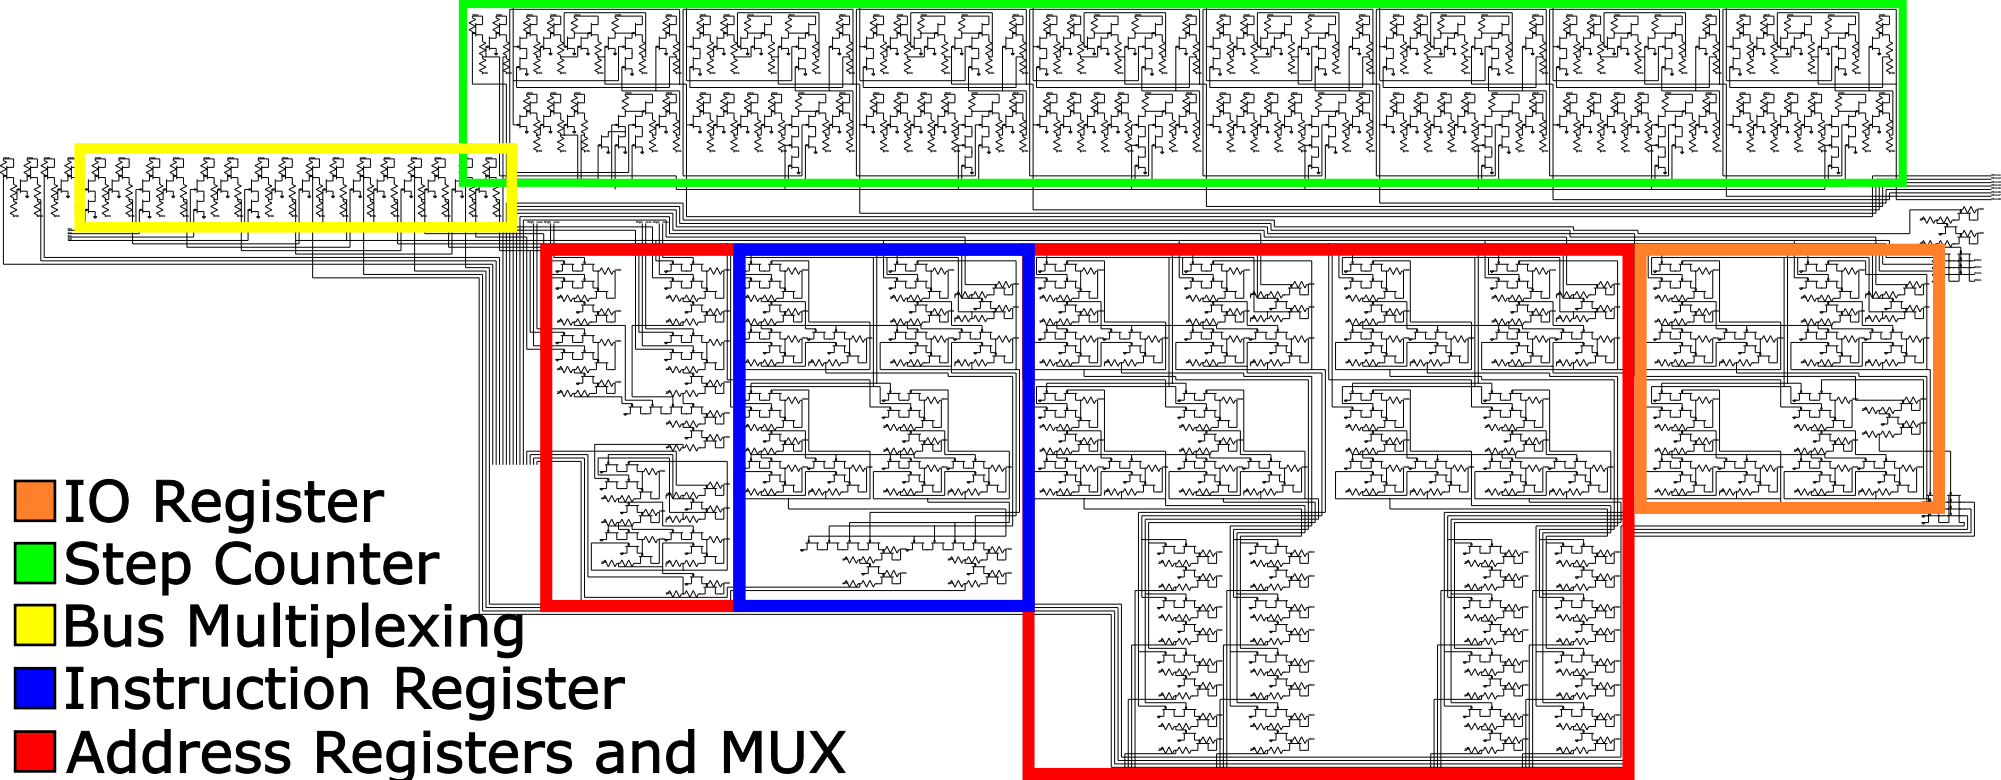
[picture p74: page 1]
VDD; VSS; ROM_Mid1_3; ROM_Mid1_2; ROM_Mid1_1; ROM_Mid1_0; ROM_High_1ROM_High_0 ROM_High_3ROM_High_2; ROM_Mid2_1ROM_Mid2_0 ROM_Mid2_3ROM_Mid2_2; ROM_Low_1ROM_Low_0 ROM_Low_3ROM_Low_2; Micro8; Micro7; Micro6; Micro5; Micro4; Micro3; Micro2; Micro1; High Low High Low; LowHigh; Step Counter; IO Register; Bus Multiplexing

Instruction Register
Address Registers and MUX
