cgarryZA/deepJFET/paper/Images/ScratchPad.pdf

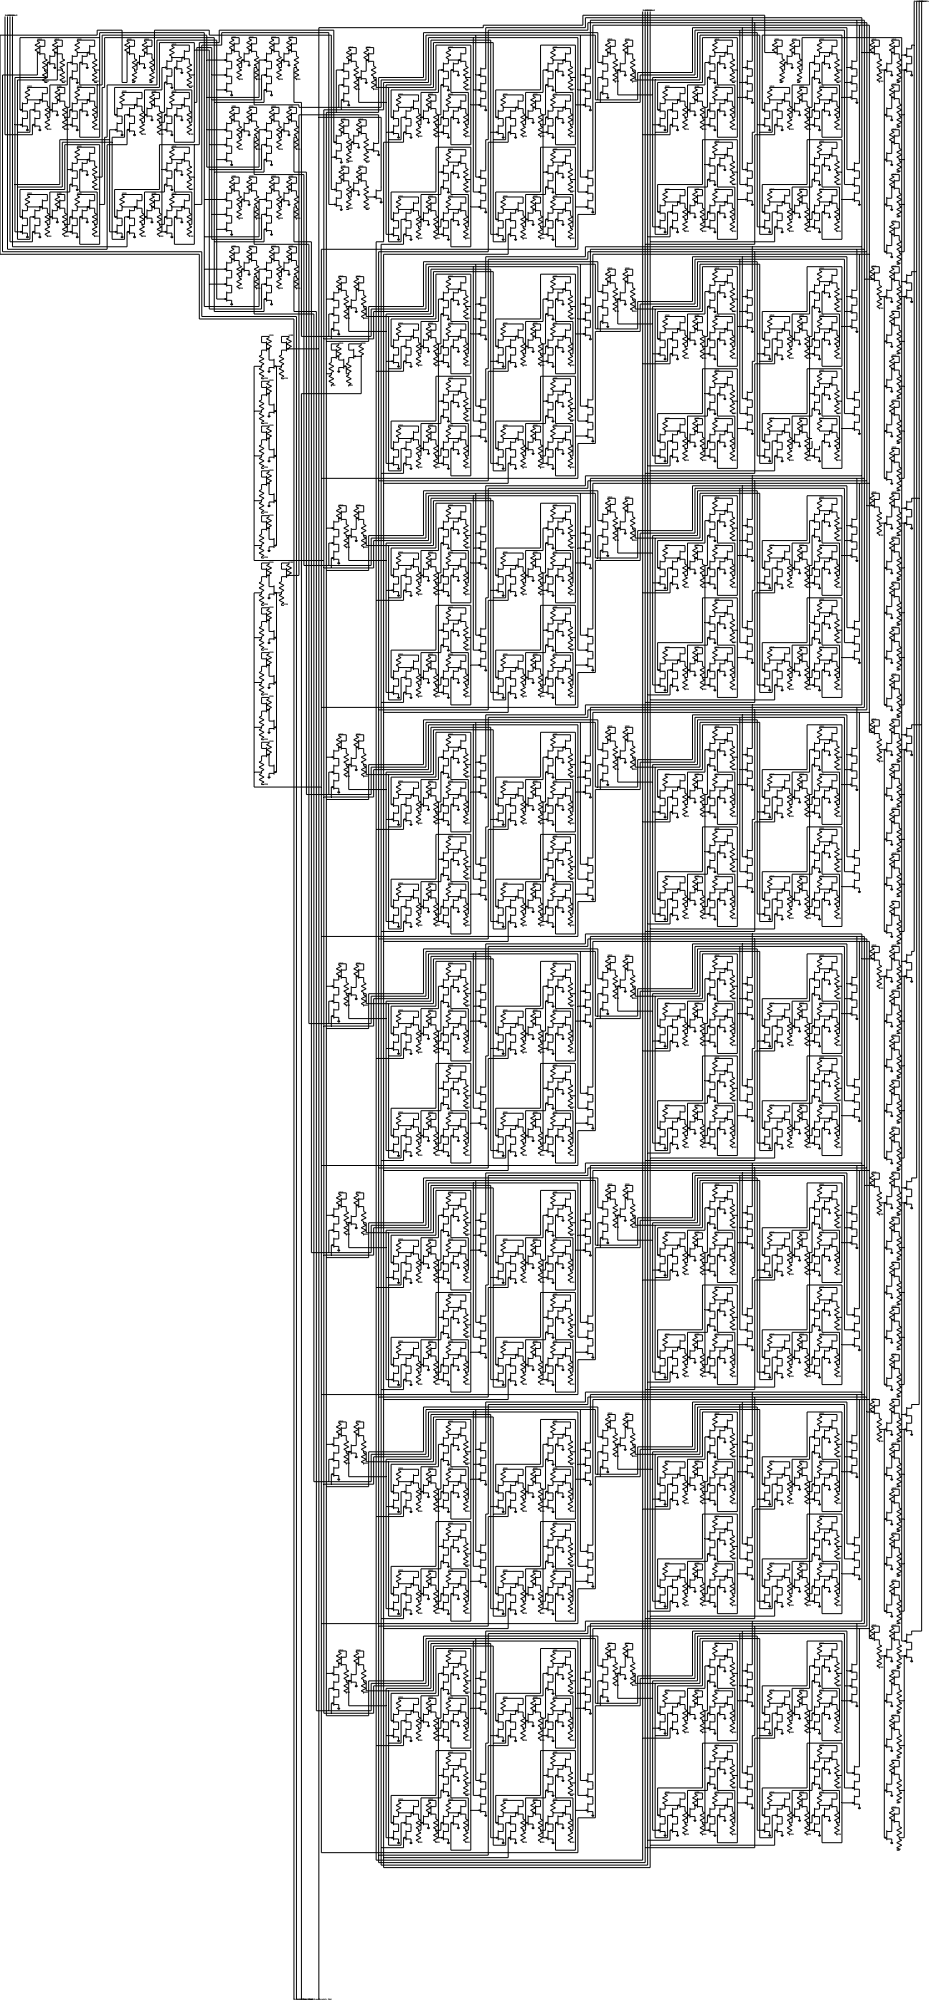
[picture p75: page 1]
VDD; VSS; ScratchPad_Load; Scratch_Out; Scratch_Reg_Select; IndexReg_Load; Bus3InBus2InBus1InBus0In; Bus3Bus2Bus1Bus0
