cgarryZA/deepJFET/paper/Images/ScratchPadAnnotated.pdf

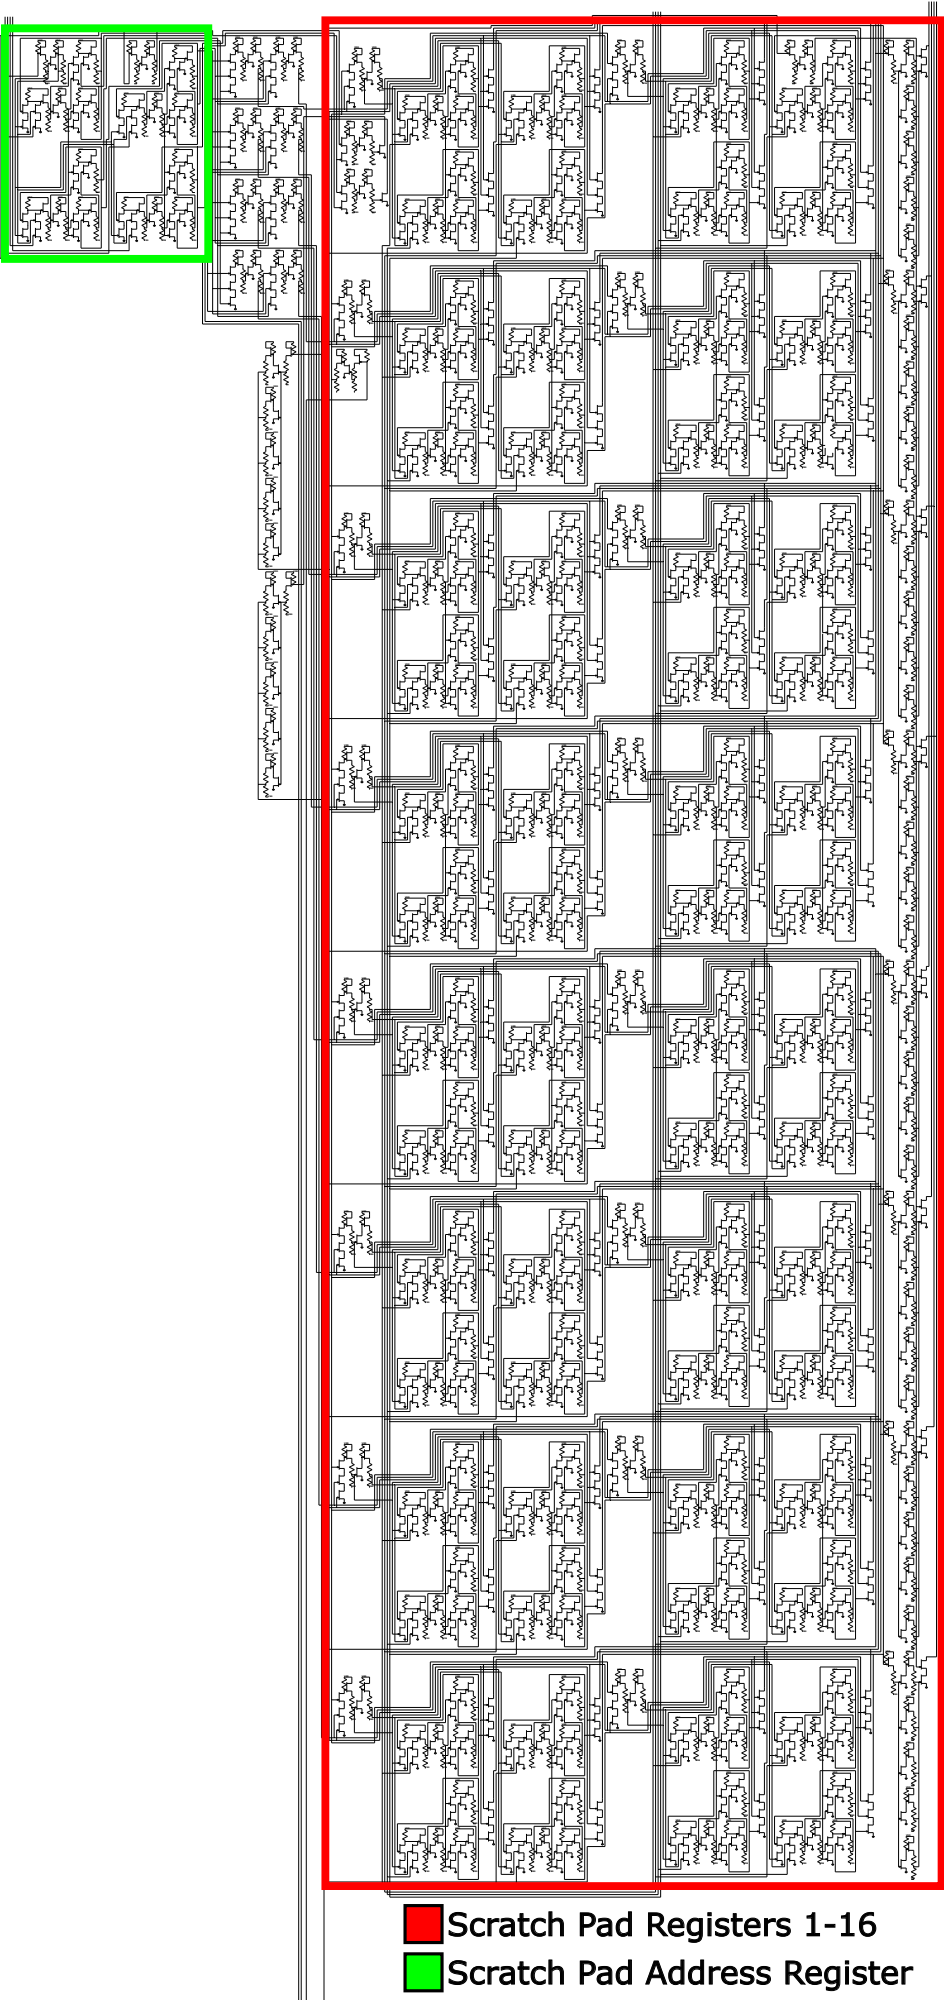
[picture p76: page 1]
VDD; VSS

Scratch Pad Registers 1-16
Scratch Pad Address Register
