cgarryZA/deepJFET/paper/Images/Stack.pdf

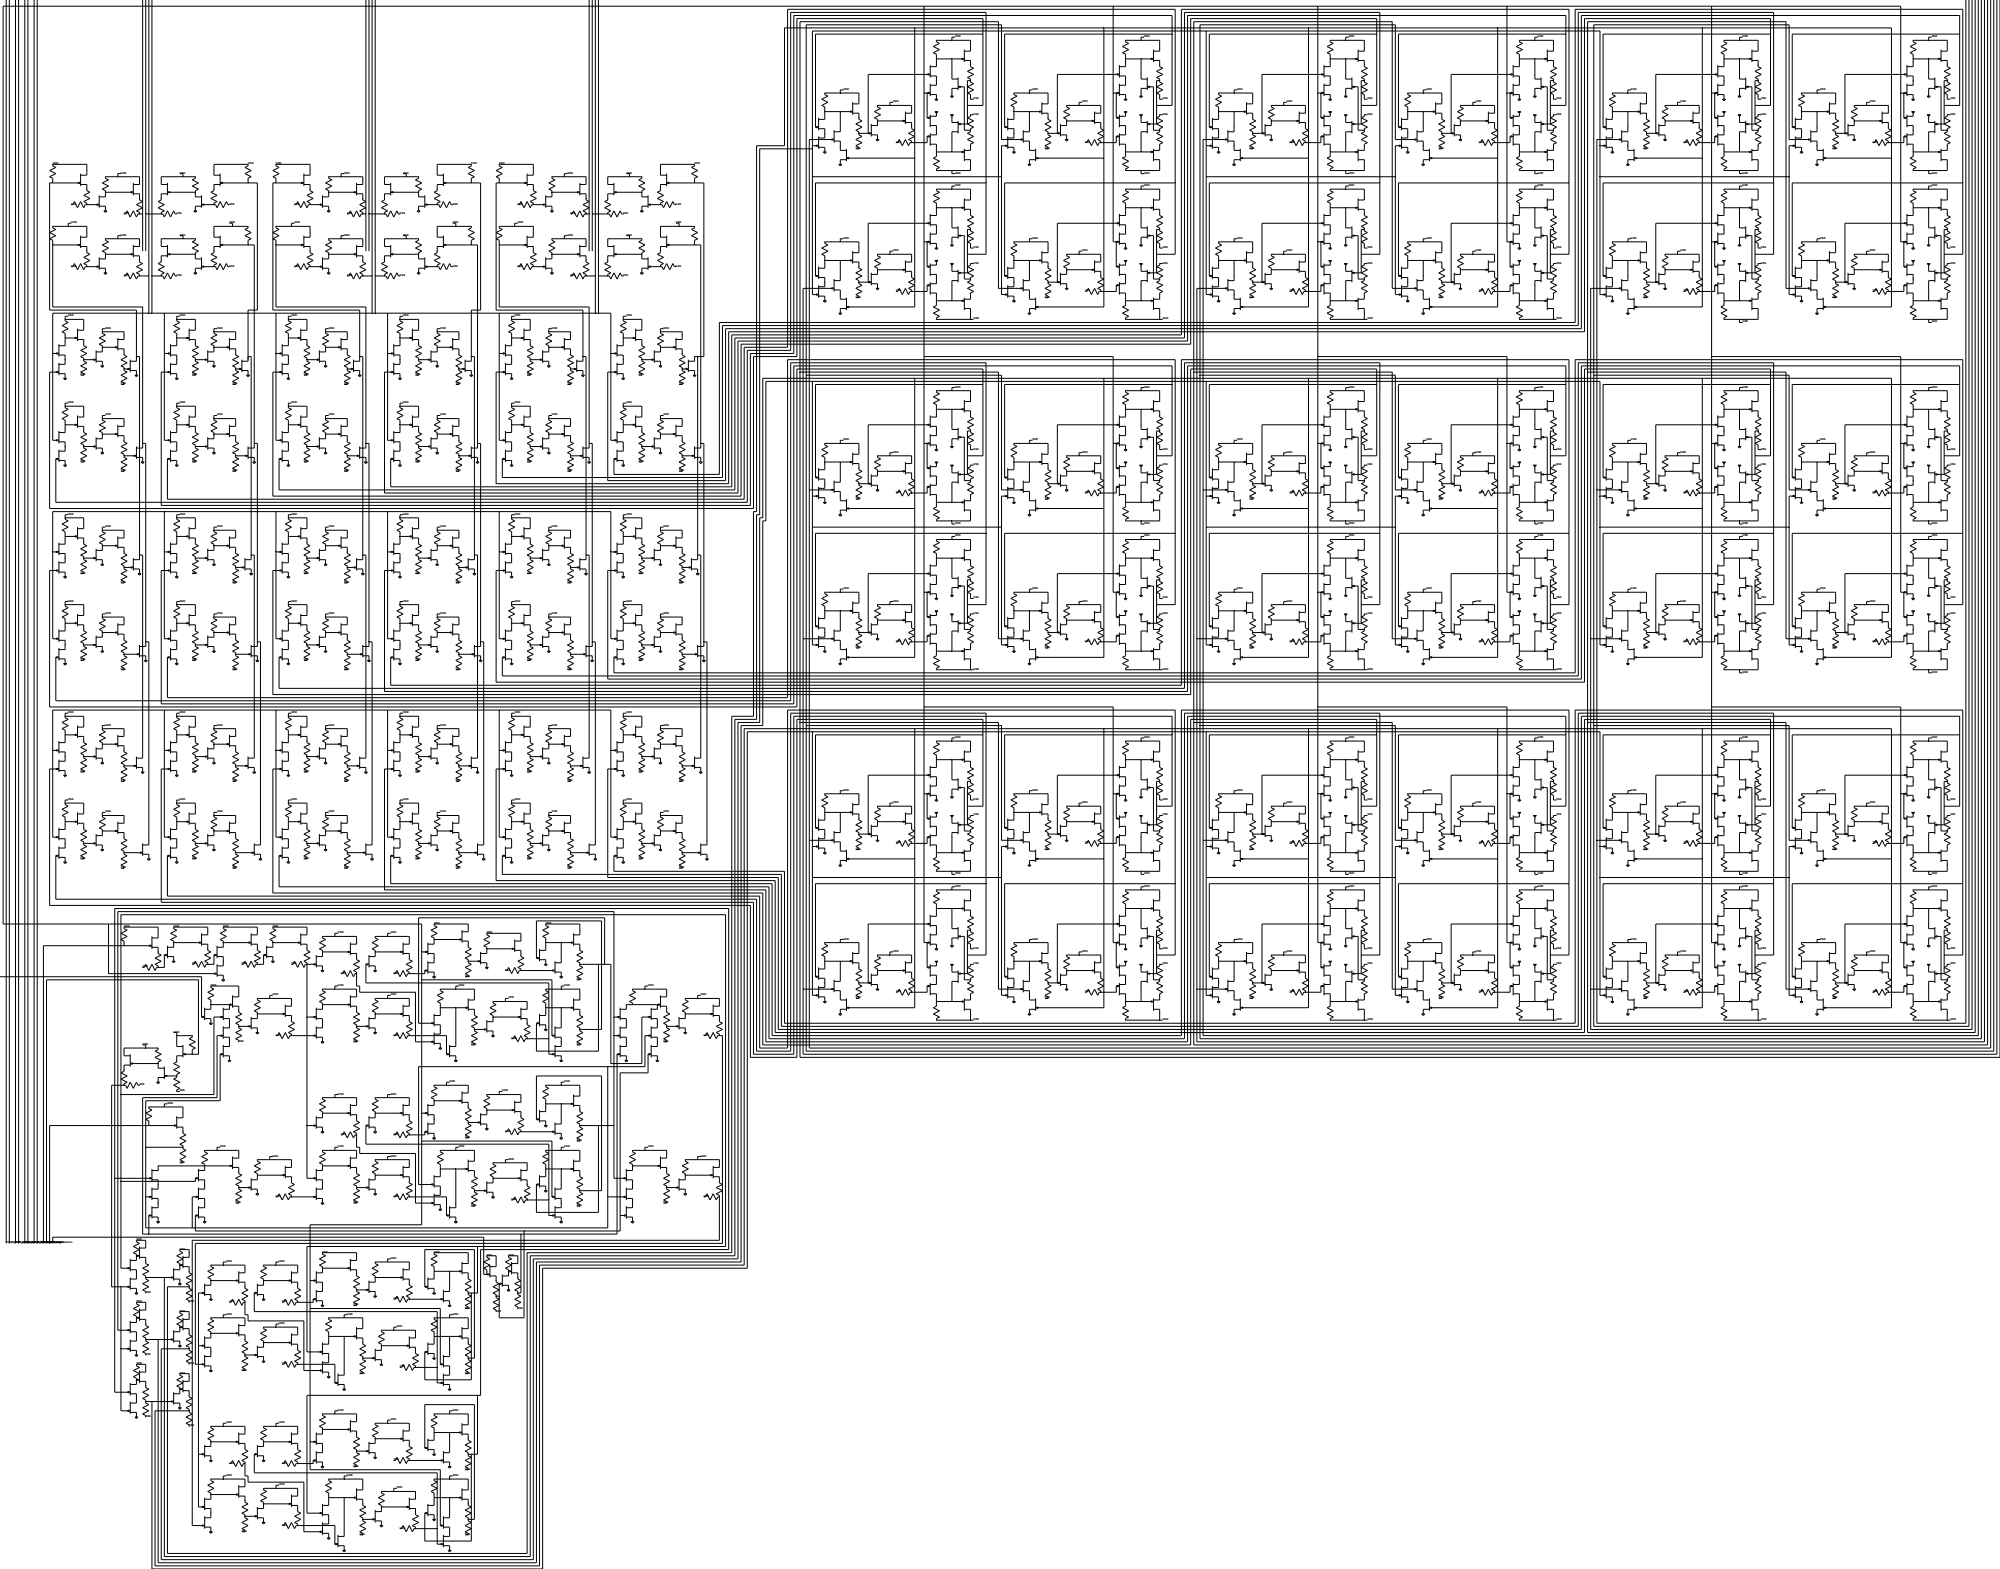
[picture p77: page 1]
PC_INCPC1_Bus_LoadPC1_Bus_OutPC2_Bus_Out PC_Stack_Load PC2_Bus_LoadPC3_Bus_Load PC3_Bus_Out; VDD; VSS; Shift_Direction; Shift_Loading; Shift_Reset; Stack_Load

VDD

VSS
