cgarryZA/deepJFET/paper/Images/Step Counter.pdf

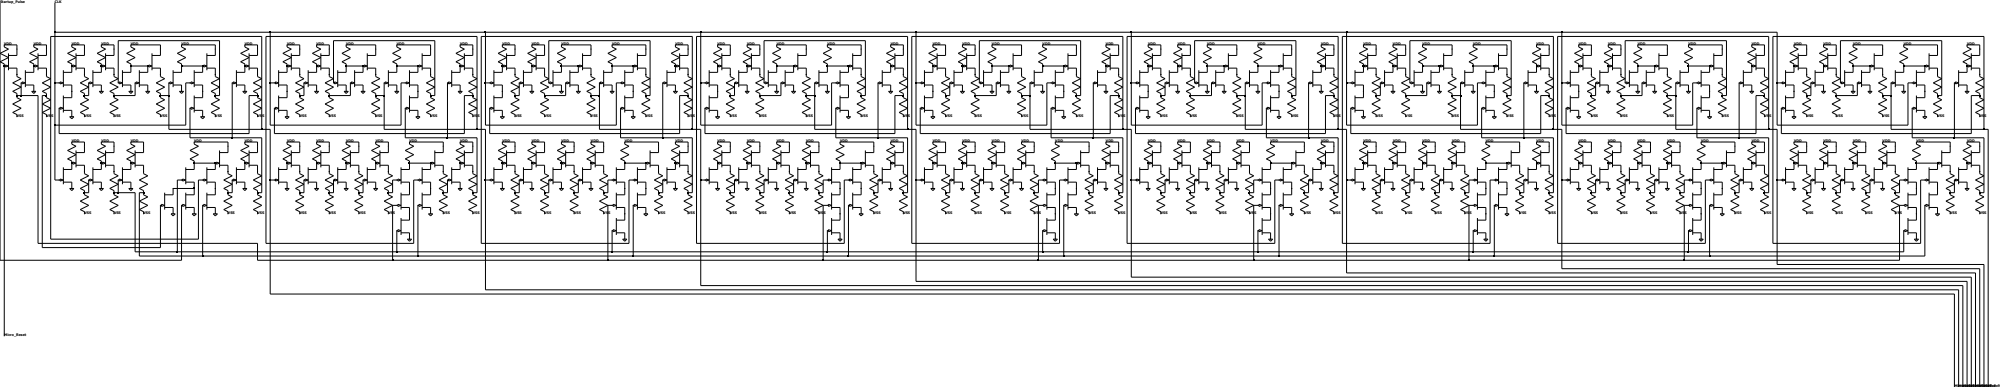
[picture p78: page 1]
Micro_Reset; VDD; VSS; Startup_Pulse; CLK; Micro3Micro2Micro1; Micro6Micro5Micro4; Micro9Micro8Micro7
