cgarryZA/deepJFET/cpus/Scratch Build/alu.asc

J_A1: njf; DR
J_A2: njf; DR
J_A3: njf; DR
J_A4: njf; DR
J_A5: njf; DR
J_A6: njf; DR
J_A7: njf; DR
J_A8: njf; DR
J_A9: njf; DR
J_A10: njf; DR
J_A11: njf; DR
J_A12: njf; DR
J_A13: njf; DR
J_A14: njf; DR
J_A15: njf; DR
J_A16: njf; DR
J_A17: njf; DR
J_A18: njf; DR
J_A19: njf; DR
J_A20: njf; DR
J_A21: njf; DR
J_A22: njf; DR
J_A23: njf; DR
J_A24: njf; DR
J_A25: njf; DR
J_A26: njf; DR
J_A27: njf; DR
J_A28: njf; DR
J_A29: njf; DR
J_A30: njf; DR
J_A31: njf; DR
J_A32: njf; DR
J_A33: njf; DR
J_A34: njf; DR
J_A35: njf; DR
J_A36: njf; DR
J_A37: njf; DR
J_A38: njf; DR
J_A43: njf; DR
J_A44: njf; DR
J_A46: njf; DR
J_A47: njf; DR
J_A48: njf; DR
J_A49: njf; DR
J_A50: njf; DR
J_A51: njf; DR
J_A2103: njf; DR
J_A2104: njf; DR
J_A2105: njf; DR
J_A2106: njf; DR
J_A2107: njf; DR
J_A2108: njf; DR
J_A2109: njf; DR
J_A2110: njf; DR
J_A2111: njf; DR
J_A2112: njf; DR
J_A2113: njf; DR
J_A2114: njf; DR
J_A2115: njf; DR
J_A2116: njf; DR
J_A2117: njf; DR
J_A2118: njf; DR
J_A2119: njf; DR
J_A2120: njf; DR
J_A2121: njf; DR
J_A2122: njf; DR
J_A2123: njf; DR
J_A2124: njf; DR
J_A2125: njf; DR
J_A2126: njf; DR
J_A2127: njf; DR
J_A2128: njf; DR
J_A2129: njf; DR
J_A2130: njf; DR
J_A2131: njf; DR
J_A2132: njf; DR
J_A2133: njf; DR
J_A2134: njf; DR
J_A2135: njf; DR
J_A2136: njf; DR
J_A2137: njf; DR
J_A2138: njf; DR
J_A2139: njf; DR
J_A2140: njf; DR
J_A2141: njf; DR
J_A2142: njf; DR
J_A2143: njf; DR
J_A2144: njf; DR
J_A2145: njf; DR
J_A2146: njf; DR
J_A2147: njf; DR
J_A2148: njf; DR
J_A2149: njf; DR
J_A2150: njf; DR
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
R3835: res; 100k
R3836: res; 1k
R3837: res; 4.8k
R3838: res; 100k
R3839: res; 1k
R3840: res; 4.8k
R3841: res; 50k
R3842: res; 1k
R3843: res; 4.5k
R3844: res; 50k
R3845: res; 1k
R3846: res; 4.5k
R4591: res; 100k
R4592: res; 1k
R4593: res; 4.8k
R4594: res; 50k
R4595: res; 1k
R4596: res; 4.5k
Named nets: 0, VDD, VSS, !Acc0, !Acc2, !Acc3, Bus3In, Bus2In, Bus1In, Bus0In, Temp_Outing, InvertTemp, Temp_INV, Temp3, T_Q3, Temp2, T_Q2, Temp1, T_Q1, Temp0, T_Q0, !Temp1, !Temp0, !Temp2, !Temp3, !InvertTemp, Temp_INVing, CLK, Bus3, Bus2, Bus1, Bus0, Acc_Loading, !Acc_Loading, Acc2, Acc3, Acc0, Acc1, !Acc1, Acc_Load, Acc_Out, Acc_Outing, CF, CF_Load, CF_Loading, !CF_Loading, CF_Out, CF_Outing, Temp_Load, Temp_Loading, !Temp_Loading, Temp_Out, CF_In, Sum0, Sum1, Sum2, Sum3, SUMCF, EO_Outing, !CF_In, AN, AZ, !T_Q3, !T_Q2, !T_Q1, !T_Q0, !CF_Output, CF_Bus_Loading, !CF_Bus_Loading, CF_Bus_Load, SUMCF_O, CFInput, !CFInput, !CF0, EO_Out, !EO_Outing, Shift_Left, Shift_Right, !Shift_, Temp3In, Temp2In, Temp0In, Temp1In, Shift_Enable, Shift_Direction, SumCFRotated, CFStage1_Load, CFStage1_Loading, !CFStage1_Loading, CF_Output, CF0, !CF
AZ
Temp Inverter
Accumulator
CF In
Temporary Register
CF Bus Out
