cgarryZA/deepJFET/cpus/Scratch Build/controls.asc

J_A1: njf; DR
J_A2: njf; DR
J_A3: njf; DR
J_A4: njf; DR
J_A13: njf; DR
J_A14: njf; DR
J_A15: njf; DR
J_A16: njf; DR
J_A17: njf; DR
J_A18: njf; DR
J_A19: njf; DR
J_A20: njf; DR
J_A21: njf; DR
J_A22: njf; DR
J_A23: njf; DR
J_A24: njf; DR
J_A25: njf; DR
J_A26: njf; DR
J_A27: njf; DR
J_A28: njf; DR
J_A29: njf; DR
J_A30: njf; DR
J_A31: njf; DR
J_A32: njf; DR
J_A33: njf; DR
J_A34: njf; DR
J_A35: njf; DR
J_A36: njf; DR
J_A69: njf; DR
J_A70: njf; DR
J_A71: njf; DR
J_A72: njf; DR
J_A73: njf; DR
J_A74: njf; DR
J_A75: njf; DR
J_A76: njf; DR
J_A77: njf; DR
J_A78: njf; DR
J_A86: njf; DR
J_A87: njf; DR
J_A88: njf; DR
J_A89: njf; DR
J_A90: njf; DR
J_A91: njf; DR
J_A92: njf; DR
J_A93: njf; DR
J_B1: njf; DR
J_B2: njf; DR
J_F1: njf; DR
J_F3: njf; DR
J_F4: njf; DR
J_F5: njf; DR
R16: res; 100k
R17: res; 1k
R18: res; 4.8k
R19: res; 50k
R20: res; 1k
R21: res; 4.5k
R22: res; 50k
R23: res; 1k
R24: res; 4.5k
R25: res; 50k
R26: res; 1k
R27: res; 4.5k
R28: res; 50k
R29: res; 1k
R30: res; 4.5k
R31: res; 100k
R32: res; 1k
R33: res; 4.8k
R34: res; 50k
R35: res; 1k
R36: res; 4.5k
R37: res; 50k
R38: res; 1k
R39: res; 4.5k
R40: res; 50k
R41: res; 1k
R42: res; 4.5k
R43: res; 50k
R44: res; 1k
R45: res; 4.5k
R46: res; 100k
R47: res; 1k
R48: res; 4.8k
R49: res; 50k
R50: res; 1k
R51: res; 4.5k
R52: res; 50k
R53: res; 1k
R54: res; 4.5k
R55: res; 50k
R56: res; 1k
R57: res; 4.5k
R58: res; 50k
R59: res; 1k
R60: res; 4.5k
R126: res; 100k
R127: res; 1k
R128: res; 4.8k
R129: res; 50k
R130: res; 1k
R131: res; 4.5k
R132: res; 50k
R133: res; 1k
R134: res; 4.5k
R135: res; 50k
R136: res; 1k
R137: res; 4.5k
R138: res; 50k
R139: res; 1k
R140: res; 4.5k
V1: voltage; PULSE(-3.6 -800m 6u 1ns 1ns 9us 10us 1)
V3: voltage; PULSE(-3.6 -800m 10u 1ns 1ns 5us 10us 10000000000000)
V4: voltage; 24
V5: voltage; -20
V7: voltage; PULSE(-3.6 -800m 11u 1ns 1ns 50 50 1)
V10: voltage; PULSE(-800m -3.6 0 1n 1n 50 50 1)
V_D1: voltage; PWL file=ir1_3_in.pwl
V_D2: voltage; PWL file=ir1_1_in.pwl
V_D3: voltage; PWL file=ir2_3_in.pwl
V_D4: voltage; PWL file=ir2_2_in.pwl
V_D5: voltage; PWL file=ir1_2_in.pwl
V_D6: voltage; PWL file=ir1_0_in.pwl
V_D7: voltage; PWL file=ir2_1_in.pwl
V_D8: voltage; PWL file=ir2_0_in.pwl
V_D9: voltage; PWL file=ir3_3_in.pwl
V_D10: voltage; PWL file=ir3_2_in.pwl
V_D11: voltage; PWL file=ir3_1_in.pwl
V_D12: voltage; PWL file=ir3_0_in.pwl
V_D13: voltage; PWL file=ir4_3_in.pwl
V_D14: voltage; PWL file=ir4_2_in.pwl
V_D15: voltage; PWL file=ir4_1_in.pwl
V_D16: voltage; PWL file=ir4_0_in.pwl
V_D17: voltage; PWL file=bus3in.pwl
V_D18: voltage; PWL file=bus2in.pwl
V_D19: voltage; PWL file=bus1in.pwl
V_D20: voltage; PWL file=bus0in.pwl
Named nets: 0, VDD, VSS, High, Low, CLK, Bus2, Bus1, Bus0, Bus2In, Bus1In, Bus0In, IR1_3_In, IR1_2_In, IR1_1_In, IR1_0_In, IR2_3_In, IR2_2_In, IR2_1_In, IR2_0_In, IR3_3_In, IR3_2_In, IR3_1_In, IR3_0_In, IR4_3_In, IR4_2_In, IR4_1_In, IR4_0_In, Startup_Pulse, Temp_Load, Acc_Load, CF_Clear, Subtract_Reset, AssertingBus, Shift_Loading, Shift_Reset, IndexReg_Load, PC1_Bus_Load, PC2_Bus_Load, PC3_Bus_Load, Bus3In, Bus3
.tran 0 1000us 1ps 0.01
System Parameters
.model DR NJF(Beta=0.135m Betatce=-0.5 Vto=-3.45 Vtotc=-2.5m Lambda=0.005 Is=205.2f Xti=3 Isr=1988f Nr=4 Alpha=20.98u N=3 Rd=1 Rs=1 Cgd=16.9p Cgs=16.9p Fc=0.5 Vk=123.7 M=407m Pb=1 Kf=37860f Af=1 Mfg=Linear_Systems)
.options NoOpIter
ROM Inputs
BUS
Bus In
