cgarryZA/deepJFET/cpus/Scratch Build/instruction_register.asc

J_A1: njf; DR
J_A2: njf; DR
J_A3: njf; DR
J_A4: njf; DR
J_A5: njf; DR
J_A6: njf; DR
J_A7: njf; DR
J_A8: njf; DR
J_A9: njf; DR
J_A10: njf; DR
J_A11: njf; DR
J_A12: njf; DR
J_A13: njf; DR
J_A14: njf; DR
J_A15: njf; DR
J_A16: njf; DR
J_A17: njf; DR
J_A18: njf; DR
J_A19: njf; DR
J_A20: njf; DR
J_A21: njf; DR
J_A22: njf; DR
J_A23: njf; DR
J_A24: njf; DR
J_A25: njf; DR
J_A26: njf; DR
J_A27: njf; DR
J_A28: njf; DR
J_A29: njf; DR
J_A30: njf; DR
J_A31: njf; DR
J_A32: njf; DR
J_A33: njf; DR
J_A34: njf; DR
J_A35: njf; DR
J_A36: njf; DR
J_A37: njf; DR
J_A38: njf; DR
J_A39: njf; DR
J_A40: njf; DR
J_A41: njf; DR
J_A42: njf; DR
J_A43: njf; DR
J_A44: njf; DR
J_A45: njf; DR
J_A46: njf; DR
J_A47: njf; DR
J_A48: njf; DR
J_A49: njf; DR
J_A50: njf; DR
J_A51: njf; DR
J_A52: njf; DR
J_A53: njf; DR
J_A54: njf; DR
J_A55: njf; DR
J_A56: njf; DR
J_A57: njf; DR
J_A58: njf; DR
J_A59: njf; DR
J_A60: njf; DR
J_A61: njf; DR
J_A62: njf; DR
J_A63: njf; DR
J_A64: njf; DR
J_A65: njf; DR
J_A66: njf; DR
J_A67: njf; DR
J_A68: njf; DR
J_A69: njf; DR
J_A70: njf; DR
J_A71: njf; DR
J_A72: njf; DR
J_A73: njf; DR
J_A74: njf; DR
J_A75: njf; DR
J_A76: njf; DR
J_A77: njf; DR
J_A78: njf; DR
J_A79: njf; DR
J_A80: njf; DR
J_A81: njf; DR
J_A82: njf; DR
J_A83: njf; DR
J_A84: njf; DR
J_A85: njf; DR
J_A86: njf; DR
J_A87: njf; DR
J_A88: njf; DR
J_A89: njf; DR
J_A90: njf; DR
J_A91: njf; DR
J_A92: njf; DR
J_A93: njf; DR
J_A94: njf; DR
J_A95: njf; DR
J_A96: njf; DR
J_A97: njf; DR
J_A98: njf; DR
J_A99: njf; DR
J_A100: njf; DR
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
R568: res; 50k
R569: res; 1k
R570: res; 4.5k
R571: res; 50k
R572: res; 1k
R573: res; 4.5k
R2998: res; 100k
R2999: res; 1k
R3000: res; 4.8k
R3001: res; 50k
R3002: res; 1k
R3003: res; 4.5k
R3022: res; 100k
R3023: res; 1k
R3024: res; 4.8k
R3025: res; 50k
R3026: res; 1k
R3027: res; 4.5k
Named nets: Bus3In, 0, Bus2In, Bus1In, Bus0In, IR2_Outing, IR2_0, IR2_3, IR2_2, IR2_1, IR3_Outing, IR3_1, IR3_0, IR3_2, IR3_3, IR4_Outing, IR4_3, IR4_2, IR4_1, IR4_0, VDD, VSS, CLK, IR1_3_In, IR1_1_In, IR1_0_In, _IR1_Loading, IR_Load, IR1_3, IR1_1, IR1_2, IR1_0, IR2_3_In, IR2_2_In, IR2_1_In, IR2_0_In, IR2_Out, IR3_3_In, IR3_2_In, IR3_1_In, IR3_0_In, IR3_Out, IR4_3_In, IR4_2_In, IR4_1_In, IR4_0_In, IR4_Out, _IR1_3, _IR1_2, _IR1_1, _IR2_1, _IR2_0, _IR2_2, _IR2_3, _IR3_3, _IR3_2, _IR3_1, _IR3_0, _IR4_1, _IR4_0, _IR4_2, _IR4_3, _IR1_0, A0, B0, IR1_2_In, IR_Loading, A1, A2, A3, B1, B2, B3, M0, M1, M2, M3, M4, M5, M6, M7, M8, M9, M10, M11, M12, M13, U0, U1, U2, U3, V0, V1, V2, V3, S0, S1, S2, S3, S4, S5, S6, S7, S8, S9, S10, S11, S12, S13, NOP, WRM, RDM, CLC, IAC, CMC, CMA, RAL, TCC, DAC, TCS, STC, RAR, CLB, JCN, FIN, JIN, FIM, JUN, JMS, INC, ISZ, ADD, SUB, LD, XCH, BBL, LDM, AZ, CF, Condition, Jumping, _Condition
Instruction Register 1
Instruction Register 2
Instruction Register 3
Instruction Register 4
IR1 MUX
IR2 MUX
