cgarryZA/deepJFET/cpus/Scratch Build/micro_instructions.asc

J_A1: njf; DR
J_A2: njf; DR
J_A3: njf; DR
J_A4: njf; DR
J_A5: njf; DR
J_A6: njf; DR
J_A7: njf; DR
J_A8: njf; DR
J_A11: njf; DR
J_A12: njf; DR
J_A13: njf; DR
J_A14: njf; DR
J_A17: njf; DR
J_A18: njf; DR
J_A19: njf; DR
J_A20: njf; DR
J_A28: njf; DR
J_A29: njf; DR
J_A30: njf; DR
J_A31: njf; DR
J_A32: njf; DR
J_A33: njf; DR
J_A34: njf; DR
J_A2433: njf; DR
J_A2434: njf; DR
J_A2437: njf; DR
J_A2438: njf; DR
J_A2439: njf; DR
J_A2440: njf; DR
J_A2441: njf; DR
J_A2443: njf; DR
J_A2444: njf; DR
J_A2445: njf; DR
J_A2446: njf; DR
J_A2447: njf; DR
J_A2448: njf; DR
J_A2451: njf; DR
J_A2452: njf; DR
J_A2453: njf; DR
J_A2454: njf; DR
J_A2455: njf; DR
J_A2456: njf; DR
J_A2467: njf; DR
J_A2468: njf; DR
J_A2473: njf; DR
J_A2474: njf; DR
J_A2475: njf; DR
J_A2476: njf; DR
J_A2477: njf; DR
J_A2478: njf; DR
J_A2479: njf; DR
J_A2480: njf; DR
J_A2485: njf; DR
J_A2486: njf; DR
J_A2487: njf; DR
J_A2488: njf; DR
J_A2489: njf; DR
J_A2490: njf; DR
J_A2491: njf; DR
J_A2492: njf; DR
J_A2493: njf; DR
J_A2494: njf; DR
J_A2497: njf; DR
J_A2498: njf; DR
J_A2499: njf; DR
J_A2500: njf; DR
J_A2501: njf; DR
J_A2502: njf; DR
J_A2505: njf; DR
J_A2506: njf; DR
J_A2509: njf; DR
J_A2511: njf; DR
J_A2512: njf; DR
J_A2513: njf; DR
J_A2514: njf; DR
J_A2515: njf; DR
J_A2516: njf; DR
J_A2517: njf; DR
J_A2518: njf; DR
J_A2519: njf; DR
J_A2520: njf; DR
J_A2521: njf; DR
J_A2522: njf; DR
J_A2523: njf; DR
J_A2524: njf; DR
J_A2525: njf; DR
J_A2526: njf; DR
J_A2527: njf; DR
J_A2528: njf; DR
J_A2529: njf; DR
J_A2530: njf; DR
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
R4480: res; 100k
R4481: res; 1k
R4482: res; 4.8k
R4483: res; 50k
R4484: res; 1k
R4485: res; 4.5k
R4486: res; 100k
R4487: res; 1k
R4488: res; 4.8k
R4489: res; 50k
R4490: res; 1k
R4491: res; 4.5k
R4522: res; 100k
R4523: res; 1k
R4524: res; 4.8k
R4525: res; 50k
R4526: res; 1k
R4527: res; 4.5k
R4528: res; 100k
R4529: res; 1k
R4530: res; 4.8k
R4531: res; 50k
R4532: res; 1k
R4533: res; 4.5k
R4534: res; 100k
R4535: res; 1k
R4536: res; 4.8k
R4537: res; 50k
R4538: res; 1k
R4539: res; 4.5k
R4540: res; 100k
R4541: res; 1k
R4542: res; 4.8k
R4543: res; 50k
R4544: res; 1k
R4545: res; 4.5k
R4546: res; 100k
R4547: res; 1k
R4548: res; 4.8k
R4549: res; 50k
R4550: res; 1k
R4551: res; 4.5k
R4552: res; 100k
R4553: res; 1k
R4554: res; 4.8k
R4555: res; 50k
R4556: res; 1k
R4557: res; 4.5k
R4633: res; 100k
R4634: res; 1k
R4635: res; 4.8k
R4636: res; 50k
R4637: res; 1k
R4638: res; 4.5k
R4639: res; 100k
R4640: res; 1k
R4641: res; 4.8k
R4642: res; 50k
R4643: res; 1k
R4644: res; 4.5k
R4645: res; 100k
R4646: res; 1k
R4647: res; 4.8k
R4648: res; 50k
R4649: res; 1k
R4650: res; 4.5k
Named nets: Micro1, 0, VDD, VSS, NOP, PC_INC, Micro_Reset, JCN, PC_Lower_IR_Load, Jumping, FIM, IR2_Out, IndexReg_Load, IR3_Out, ScratchPad_Load, IR4_Out, Micro2, FIN, Micro3, Micro4, JUN, PC1_IR_Load, JMS, Shift_Loading, Stack_Load, Micro5, INC, Scratch_Out, INC_Out, Temp_Load, ISZ, PC_Lower_Load, ISZ_False, XCH, Acc_Out, Temp_Out, Acc_Load, LD, BBL, Shift_Direction, PC_Stack_Load, LDM, CLB, CF_Load, CLC, IAC, Bus0In, EO_Out, CMA, CMC, CF_Bus_Load, RAL, Shift_Enable, RAR, TCC, CF_Out, DAC, Subtract_Set, Subtract_Reset, STC, TCS, Bus3In, WRM, RDM, ADD, SUB, Temp_INV, Address_Memory, 4Words_Reset, PC_Jin_Loading, JIN, ScratchPadWord1, Scratch_Reg_Select, ScratchPadWord2, ISZ_True, Micro6, CFStage1_Load, CF, Bus1In, !CF, IR_Load, Temp_Inv
A
M
X1
X2
NOP
X3
JCN
FIM
FIN
JUN
JMS
INC
ISZ
XCH
LD
BBL
LDM
CLB
CLC
IAC
CMA
CMC
RAL
RAR
TCC
DAC
STC
TCS
WRM
RDM
ADD
SUB
JIN
