cgarryZA/deepJFET/cpus/Scratch Build/program_counter.asc

J_A1: njf; DR
J_A2: njf; DR
J_A3: njf; DR
J_A4: njf; DR
J_A5: njf; DR
J_A6: njf; DR
J_A7: njf; DR
J_A8: njf; DR
J_A9: njf; DR
J_A10: njf; DR
J_A11: njf; DR
J_A12: njf; DR
J_A13: njf; DR
J_A16: njf; DR
J_A1039: njf; DR
J_A1040: njf; DR
J_A1041: njf; DR
J_A1042: njf; DR
J_A1043: njf; DR
J_A1044: njf; DR
J_A1045: njf; DR
J_A1046: njf; DR
J_A1047: njf; DR
J_A1048: njf; DR
J_A1049: njf; DR
J_A1050: njf; DR
J_A1051: njf; DR
J_A1052: njf; DR
J_A1053: njf; DR
J_A1054: njf; DR
J_A1055: njf; DR
J_A1056: njf; DR
J_A1057: njf; DR
J_A1058: njf; DR
J_A1059: njf; DR
J_A1060: njf; DR
J_A1061: njf; DR
J_A1062: njf; DR
J_A1063: njf; DR
J_A1064: njf; DR
J_A1065: njf; DR
J_A1066: njf; DR
J_A1067: njf; DR
J_A1068: njf; DR
J_A1069: njf; DR
J_A1070: njf; DR
J_A1071: njf; DR
J_A1072: njf; DR
J_A1073: njf; DR
J_A1074: njf; DR
J_A1075: njf; DR
J_A1076: njf; DR
J_A1077: njf; DR
J_A1078: njf; DR
J_A1079: njf; DR
J_A1080: njf; DR
J_A1081: njf; DR
J_A1082: njf; DR
J_A1083: njf; DR
J_A1084: njf; DR
J_A1085: njf; DR
J_A1086: njf; DR
J_A1087: njf; DR
J_A1088: njf; DR
J_A1089: njf; DR
J_A1090: njf; DR
J_A1091: njf; DR
J_A1092: njf; DR
J_A1093: njf; DR
J_A1094: njf; DR
J_A1095: njf; DR
J_A1096: njf; DR
J_A1097: njf; DR
J_A1098: njf; DR
J_A1099: njf; DR
J_A1100: njf; DR
J_A1101: njf; DR
J_A1102: njf; DR
J_A1103: njf; DR
J_A1104: njf; DR
J_A1105: njf; DR
J_A1106: njf; DR
J_A1107: njf; DR
J_A1108: njf; DR
J_A1109: njf; DR
J_A1110: njf; DR
J_A1111: njf; DR
J_A1112: njf; DR
J_A1113: njf; DR
J_A1114: njf; DR
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
R2056: res; 50k
R2057: res; 1k
R2058: res; 4.5k
R2059: res; 100k
R2060: res; 1k
R2061: res; 4.8k
R2062: res; 50k
R2063: res; 1k
R2064: res; 4.5k
R2989: res; 50k
R2990: res; 1k
R2991: res; 4.5k
R3940: res; 100k
R3941: res; 1k
R3942: res; 4.8k
R3943: res; 50k
R3944: res; 1k
R3945: res; 4.5k
Named nets: S31, S32, S33, P_Enable, 0, VDD, VSS, PC3CF, PC31, !PC30, PC30, PC32, PC33, !PC3CF, !PC31, !PC32, !PC33, S30, S20, S21, S22, S23, PC2CF, !PC21, PC20, PC21, PC22, PC23, !PC2CF, !PC20, !PC22, !PC23, S10, S11, S12, S13, PC10, PC11, PC12, !PC10, !PC11, !PC12, PC13, !PC13, PC_INC, PC1_Load, PC_Lower_Load, !P_Enable, PC1_Loading, !PC1_Loading, PC1_IR_Load, PC1_IR_Loading, PC_Stack_Load, PC_Stack_Loading, _PC_Lower_Loading, CLK, IR3_1, IR2_3, IR3_0, S1tack3, S1tack2, S1tack0, S1tack1, IR3_2, S2tack3, S2tack2, S2tack0, S2tack1, S3tack3, S3tack2, S3tack0, S3tack1, PC_Lower_Loading, Scratch_3_High, Scratch_2_High, Scratch_0_High, Scratch_1_High, IR4_3, IR4_2, IR4_1, IR4_0, PC_Lower_IR_Loading, PC_Lower_IR_Load, Scratch_3_Lower, Scratch_2_Lower, Scratch_0_Lower, Scratch_1_Lower, IR3_3, PC_Jin_Loading, IR2_2
