cgarryZA/deepJFET/cpus/Scratch Build/step_counter.asc

J_A1: njf; DR
J_A2: njf; DR
J_A3: njf; DR
J_A4: njf; DR
J_A13: njf; DR
J_A14: njf; DR
J_A15: njf; DR
J_A16: njf; DR
J_A17: njf; DR
J_A18: njf; DR
J_A19: njf; DR
J_A20: njf; DR
J_A21: njf; DR
J_A22: njf; DR
J_A23: njf; DR
J_A24: njf; DR
J_A25: njf; DR
J_A26: njf; DR
J_A27: njf; DR
J_A28: njf; DR
J_A29: njf; DR
J_A30: njf; DR
J_A31: njf; DR
J_A32: njf; DR
J_A33: njf; DR
J_A34: njf; DR
J_A35: njf; DR
J_A36: njf; DR
J_A37: njf; DR
J_A38: njf; DR
J_A39: njf; DR
J_A40: njf; DR
J_A41: njf; DR
J_A42: njf; DR
J_A43: njf; DR
J_A44: njf; DR
J_A45: njf; DR
J_A46: njf; DR
J_A47: njf; DR
J_A48: njf; DR
J_A49: njf; DR
J_A50: njf; DR
J_A51: njf; DR
J_A52: njf; DR
J_A53: njf; DR
J_A54: njf; DR
J_A55: njf; DR
J_A56: njf; DR
J_A57: njf; DR
J_A58: njf; DR
J_A59: njf; DR
J_A60: njf; DR
J_A61: njf; DR
J_A62: njf; DR
J_A63: njf; DR
J_A64: njf; DR
J_A65: njf; DR
J_A66: njf; DR
J_A67: njf; DR
J_A68: njf; DR
J_A69: njf; DR
J_A70: njf; DR
J_A71: njf; DR
J_A72: njf; DR
J_A73: njf; DR
J_A74: njf; DR
J_A75: njf; DR
J_A76: njf; DR
J_A77: njf; DR
J_A78: njf; DR
J_A79: njf; DR
J_A80: njf; DR
J_A81: njf; DR
J_A82: njf; DR
J_A83: njf; DR
J_A84: njf; DR
J_A85: njf; DR
J_A86: njf; DR
J_A87: njf; DR
J_A88: njf; DR
J_A89: njf; DR
J_A90: njf; DR
J_A91: njf; DR
J_A92: njf; DR
J_A93: njf; DR
J_A94: njf; DR
J_A95: njf; DR
J_A96: njf; DR
J_A97: njf; DR
J_A98: njf; DR
J_A99: njf; DR
J_A100: njf; DR
J_A101: njf; DR
J_A102: njf; DR
J_A103: njf; DR
J_A104: njf; DR
J_A105: njf; DR
J_A106: njf; DR
J_A107: njf; DR
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
R1264: res; 100k
R1265: res; 1k
R1266: res; 4.8k
R1267: res; 50k
R1268: res; 1k
R1269: res; 4.5k
R1270: res; 100k
R1271: res; 1k
R1272: res; 4.8k
R1273: res; 100k
R1274: res; 1k
R1275: res; 4.8k
R1318: res; 50k
R1319: res; 1k
R1320: res; 4.5k
R1321: res; 50k
R1322: res; 1k
R1323: res; 4.5k
R1324: res; 50k
R1325: res; 1k
R1326: res; 4.5k
Named nets: !MReset, VDD, VSS, Micro_Reset, 0, CLK, Startup_Pulse, Micro_Load, MReset, Micro6, !Micro_Load, Micro1, Micro2, Micro3, Micro5, Micro4
