cgarryZA/deepJFET/cpus/tileable/instruction_register_mux.asc

J_A1920: njf; DR
J_A1921: njf; DR
J_A1922: njf; DR
J_A1923: njf; DR
J_A1924: njf; DR
J_A1925: njf; DR
J_A1926: njf; DR
J_A1927: njf; DR
J_A1928: njf; DR
J_A1929: njf; DR
J_A1930: njf; DR
J_A1931: njf; DR
J_A1932: njf; DR
J_A1933: njf; DR
J_A1934: njf; DR
J_A1935: njf; DR
J_A1936: njf; DR
J_A1937: njf; DR
J_A1938: njf; DR
J_A1939: njf; DR
J_A1940: njf; DR
J_A1941: njf; DR
J_A1942: njf; DR
J_A1943: njf; DR
J_A1944: njf; DR
J_A1945: njf; DR
J_A1946: njf; DR
J_A1947: njf; DR
J_A1948: njf; DR
J_A1949: njf; DR
J_A1950: njf; DR
J_A1951: njf; DR
J_A1952: njf; DR
J_A1953: njf; DR
J_A1954: njf; DR
J_A1955: njf; DR
J_A1956: njf; DR
J_A1957: njf; DR
J_A1958: njf; DR
J_A1959: njf; DR
J_A1960: njf; DR
J_A1961: njf; DR
J_A1962: njf; DR
J_A1963: njf; DR
J_A1964: njf; DR
J_A1965: njf; DR
J_A1966: njf; DR
J_A1967: njf; DR
J_A1968: njf; DR
J_A1969: njf; DR
J_A1970: njf; DR
J_A1971: njf; DR
J_A1972: njf; DR
J_A1973: njf; DR
J_A1974: njf; DR
J_A1975: njf; DR
J_A1976: njf; DR
J_A1977: njf; DR
J_A1978: njf; DR
J_A1979: njf; DR
J_A1980: njf; DR
J_A1981: njf; DR
J_A1982: njf; DR
J_A1983: njf; DR
J_A1984: njf; DR
J_A1985: njf; DR
J_A1986: njf; DR
J_A1987: njf; DR
J_A1988: njf; DR
J_A1989: njf; DR
J_A1990: njf; DR
J_A1991: njf; DR
J_A1992: njf; DR
J_A1993: njf; DR
J_A1994: njf; DR
J_A1995: njf; DR
J_A1996: njf; DR
J_A1997: njf; DR
J_A1998: njf; DR
J_A1999: njf; DR
J_A2000: njf; DR
J_A2001: njf; DR
J_A2002: njf; DR
J_A2003: njf; DR
J_A2004: njf; DR
J_A2005: njf; DR
J_A2006: njf; DR
J_A2007: njf; DR
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
R3318: res; 4.8k
R3319: res; 50k
R3320: res; 1k
R3321: res; 4.5k
R3322: res; 100k
R3323: res; 1k
R3324: res; 4.8k
R3325: res; 50k
R3326: res; 1k
R3327: res; 4.5k
R3328: res; 100k
R3329: res; 1k
R3330: res; 4.8k
R3331: res; 50k
R3332: res; 1k
R3333: res; 4.5k
R3334: res; 100k
R3335: res; 1k
R3336: res; 4.8k
R3337: res; 50k
R3338: res; 1k
R3339: res; 4.5k
R3340: res; 100k
R3341: res; 1k
R3342: res; 4.8k
R3343: res; 50k
R3344: res; 1k
R3345: res; 4.5k
R3346: res; 100k
R3347: res; 1k
R3348: res; 4.8k
R3349: res; 50k
R3350: res; 1k
R3351: res; 4.5k
R3352: res; 100k
R3353: res; 1k
R3354: res; 4.8k
R3355: res; 50k
R3356: res; 1k
R3357: res; 4.5k
R3358: res; 100k
R3359: res; 1k
R3360: res; 4.8k
R3361: res; 50k
R3362: res; 1k
R3363: res; 4.5k
R3364: res; 100k
R3365: res; 1k
R3366: res; 4.8k
R3367: res; 50k
R3368: res; 1k
R3369: res; 4.5k
R3370: res; 100k
R3371: res; 1k
R3372: res; 4.8k
R3373: res; 50k
R3374: res; 1k
R3375: res; 4.5k
R3376: res; 100k
R3377: res; 1k
R3378: res; 4.8k
R3379: res; 50k
R3380: res; 1k
R3381: res; 4.5k
R3382: res; 100k
R3383: res; 1k
R3384: res; 4.8k
R3403: res; 100k
R3404: res; 1k
R3405: res; 4.8k
R3406: res; 50k
R3407: res; 1k
R3408: res; 4.5k
R3409: res; 100k
R3410: res; 1k
R3411: res; 4.8k
R3412: res; 50k
R3413: res; 1k
R3414: res; 4.5k
R3415: res; 100k
R3416: res; 1k
R3417: res; 4.8k
R3418: res; 50k
R3419: res; 1k
R3420: res; 4.5k
R4558: res; 50k
R4559: res; 1k
R4560: res; 4.5k
Named nets: 0, VDD, VSS, Upper0, Lower0, Upper1, Lower1, Upper2, Lower2, Upper3, Lower3, !IR1_3, !IR1_2, !IR1_1, !IR1_0, IR1_2, IR1_3, IR1_0, IR1_1, 2Upper0, 2Lower0, 2Upper1, 2Lower1, 2Upper2, 2Lower2, 2Upper3, 2Lower3, !IR2_3, !IR2_2, !IR2_1, !IR2_0, IR2_3, IR2_2, IR2_0, IR2_1, NOP, JCN, JUN, INC, JMS, ADD, ISZ, SUB, LD, XCH, BBL, LDM, JIN, FIN, SRC, FIM, ControlSignals, CMA, RAL, RAR, TCC, DAC, TCS, STC, DAA, KBP, DCL, CLB, AZ, Jump, CF, TestPin, !CF, !TestPin, AN, CLC, IAC, CMC, RAMSignals, SBM, ADM, !SBM, !ADM, Jumping, !2Word, A_Q1, A_Q0, A_Q3, A_Q2, !2Acc, 2Acc, WR, RD
IR1 MUX
IR2 MUX
JCN U
CLB
JCN AZ
CMA
JCN AZ | TN
RAL
RAR
JCN AZ | CN
JCN AZ | CN | TN
TCC
JCN TZ
TCS
JCN CZ
STC
DAC
JCN CZ | TZ
DAA
JCN AN
KBP
JCN AN | TZ
DCL
JCN TN
CLC
JCN CN
IAC
JCN CN | TN
CMC
RAM Controls
