cgarryZA/deepJFET/cpus/simplified/step_counter.asc

J_A846: njf; DR
J_A847: njf; DR
J_A848: njf; DR
J_A849: njf; DR
J_A850: njf; DR
J_A851: njf; DR
J_A852: njf; DR
J_A853: njf; DR
J_A854: njf; DR
J_A855: njf; DR
J_A856: njf; DR
J_A857: njf; DR
J_A858: njf; DR
J_A859: njf; DR
J_A860: njf; DR
J_A861: njf; DR
J_A862: njf; DR
J_A863: njf; DR
J_A864: njf; DR
J_A865: njf; DR
J_A866: njf; DR
J_A867: njf; DR
J_A868: njf; DR
J_A869: njf; DR
J_A870: njf; DR
J_A871: njf; DR
J_A872: njf; DR
J_A873: njf; DR
J_A874: njf; DR
J_A875: njf; DR
J_A876: njf; DR
J_A877: njf; DR
J_A878: njf; DR
J_A879: njf; DR
J_A880: njf; DR
J_A881: njf; DR
J_A882: njf; DR
J_A883: njf; DR
J_A884: njf; DR
J_A885: njf; DR
J_A886: njf; DR
J_A887: njf; DR
J_A888: njf; DR
J_A889: njf; DR
J_A890: njf; DR
J_A891: njf; DR
J_A892: njf; DR
J_A893: njf; DR
J_A894: njf; DR
J_A895: njf; DR
J_A896: njf; DR
J_A897: njf; DR
J_A898: njf; DR
J_A899: njf; DR
J_A900: njf; DR
J_A901: njf; DR
J_A902: njf; DR
J_A903: njf; DR
J_A904: njf; DR
J_A905: njf; DR
J_A906: njf; DR
J_A907: njf; DR
J_A908: njf; DR
J_A909: njf; DR
J_A910: njf; DR
J_A911: njf; DR
J_A912: njf; DR
J_A913: njf; DR
J_A914: njf; DR
J_A915: njf; DR
J_A916: njf; DR
J_A917: njf; DR
J_A918: njf; DR
J_A919: njf; DR
J_A920: njf; DR
J_A921: njf; DR
J_A922: njf; DR
J_A923: njf; DR
J_A924: njf; DR
J_A925: njf; DR
J_A926: njf; DR
J_A927: njf; DR
J_A928: njf; DR
J_A929: njf; DR
J_A930: njf; DR
J_A931: njf; DR
J_A932: njf; DR
J_A933: njf; DR
J_A934: njf; DR
J_A935: njf; DR
J_A936: njf; DR
J_A937: njf; DR
J_A938: njf; DR
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
R1576: res; 100k
R1577: res; 1k
R1578: res; 4.8k
Named nets: 0, VDD, VSS, CLK, !MReset, Micro3, Micro2, Micro_Reset, Micro1, Startup_Pulse, Micro4, Micro_Load, MReset, Micro16, !Micro_Load, Micro6, Micro5, Micro7, Micro8, Micro10, Micro9, Micro11, Micro12, Micro14, Micro13, Micro15
