cgarryZA/deepJFET/cpus/tileable/generated/rv32i_instruction_register.asc

J_A1: njf; DR
J_A2: njf; DR
J_A3: njf; DR
J_A4: njf; DR
J_A5: njf; DR
J_A6: njf; DR
J_A7: njf; DR
J_A8: njf; DR
J_A9: njf; DR
J_A10: njf; DR
J_A11: njf; DR
J_A12: njf; DR
J_A13: njf; DR
J_A14: njf; DR
J_A15: njf; DR
J_A16: njf; DR
J_A17: njf; DR
J_A18: njf; DR
J_A19: njf; DR
J_A20: njf; DR
J_A21: njf; DR
J_A22: njf; DR
J_A23: njf; DR
J_A24: njf; DR
J_A25: njf; DR
J_A26: njf; DR
J_A27: njf; DR
J_A28: njf; DR
J_A29: njf; DR
J_A30: njf; DR
J_A31: njf; DR
J_A32: njf; DR
J_A33: njf; DR
J_A34: njf; DR
J_A35: njf; DR
J_A36: njf; DR
J_A37: njf; DR
J_A38: njf; DR
J_A39: njf; DR
J_A40: njf; DR
J_A41: njf; DR
J_A42: njf; DR
J_A43: njf; DR
J_A44: njf; DR
J_A45: njf; DR
J_A46: njf; DR
J_A47: njf; DR
J_A48: njf; DR
J_A49: njf; DR
J_A50: njf; DR
J_A51: njf; DR
J_A52: njf; DR
J_A53: njf; DR
J_A54: njf; DR
J_A55: njf; DR
J_A56: njf; DR
J_A57: njf; DR
J_A58: njf; DR
J_A59: njf; DR
J_A60: njf; DR
J_A61: njf; DR
J_A62: njf; DR
J_A63: njf; DR
J_A64: njf; DR
J_A65: njf; DR
J_A66: njf; DR
J_A67: njf; DR
J_A68: njf; DR
J_A69: njf; DR
J_A70: njf; DR
J_A71: njf; DR
J_A72: njf; DR
J_A73: njf; DR
J_A74: njf; DR
J_A75: njf; DR
J_A76: njf; DR
J_A77: njf; DR
J_A78: njf; DR
J_A79: njf; DR
J_A80: njf; DR
J_A81: njf; DR
J_A82: njf; DR
J_A83: njf; DR
J_A84: njf; DR
J_A85: njf; DR
J_A86: njf; DR
J_A87: njf; DR
J_A88: njf; DR
J_A89: njf; DR
J_A90: njf; DR
J_A91: njf; DR
J_A92: njf; DR
J_A93: njf; DR
J_A94: njf; DR
J_A95: njf; DR
J_A96: njf; DR
J_A97: njf; DR
J_A98: njf; DR
J_A99: njf; DR
J_A100: njf; DR
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
R717: res; 4.8k
R718: res; 100k
R719: res; 1k
R720: res; 4.8k
R721: res; 100k
R722: res; 1k
R723: res; 4.8k
R724: res; 100k
R725: res; 1k
R726: res; 4.8k
R727: res; 100k
R728: res; 1k
R729: res; 4.8k
R730: res; 100k
R731: res; 1k
R732: res; 4.8k
R733: res; 100k
R734: res; 1k
R735: res; 4.8k
R736: res; 100k
R737: res; 1k
R738: res; 4.8k
R739: res; 100k
R740: res; 1k
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
