cgarryZA/deepJFET/cpus/Scratch Build/stack/Bus.asc

J0: njf; DR
J1: njf; DR
J2: njf; DR
J3: njf; DR
J4: njf; DR
J5: njf; DR
J6: njf; DR
J7: njf; DR
J8: njf; DR
J9: njf; DR
J10: njf; DR
J11: njf; DR
J12: njf; DR
J13: njf; DR
J14: njf; DR
J15: njf; DR
J16: njf; DR
J17: njf; DR
J18: njf; DR
J19: njf; DR
J20: njf; DR
J21: njf; DR
J22: njf; DR
J23: njf; DR
J24: njf; DR
J25: njf; DR
J26: njf; DR
J27: njf; DR
J28: njf; DR
J29: njf; DR
J30: njf; DR
J31: njf; DR
J32: njf; DR
J33: njf; DR
J34: njf; DR
J35: njf; DR
J36: njf; DR
J37: njf; DR
J38: njf; DR
J39: njf; DR
J40: njf; DR
J41: njf; DR
J42: njf; DR
J43: njf; DR
J44: njf; DR
J45: njf; DR
J46: njf; DR
J47: njf; DR
J48: njf; DR
J49: njf; DR
J50: njf; DR
J51: njf; DR
J52: njf; DR
J53: njf; DR
J54: njf; DR
J55: njf; DR
J56: njf; DR
J57: njf; DR
J58: njf; DR
J59: njf; DR
J60: njf; DR
J61: njf; DR
J62: njf; DR
J63: njf; DR
J64: njf; DR
J65: njf; DR
J66: njf; DR
J67: njf; DR
J68: njf; DR
J69: njf; DR
J70: njf; DR
J71: njf; DR
Named nets: 0, Level1, Level2, Level3, S133, S132, S131, S130, S123, S122, S121, S120, S113, S112, S111, S110, S1tack1In, S1tack0In, S1tack2In, S1tack3In, S233, S232, S231, S230, S223, S222, S221, S220, S213, S212, S211, S210, S2tack1In, S2tack0In, S2tack2In, S2tack3In, S333, S332, S331, S330, S323, S322, S321, S320, S313, S312, S311, S310, S3tack1In, S3tack0In, S3tack2In, S3tack3In
