cgarryZA/deepJFET/cpus/Scratch Build/stack/Controls.asc

J0: njf; DR
J1: njf; DR
J2: njf; DR
J3: njf; DR
J4: njf; DR
J5: njf; DR
J6: njf; DR
J7: njf; DR
J8: njf; DR
J9: njf; DR
J10: njf; DR
J11: njf; DR
J12: njf; DR
J13: njf; DR
J14: njf; DR
J15: njf; DR
J16: njf; DR
J17: njf; DR
J18: njf; DR
J19: njf; DR
J20: njf; DR
J21: njf; DR
J22: njf; DR
J23: njf; DR
J24: njf; DR
J25: njf; DR
J26: njf; DR
J27: njf; DR
J28: njf; DR
J29: njf; DR
J30: njf; DR
J31: njf; DR
J32: njf; DR
J33: njf; DR
J34: njf; DR
J35: njf; DR
J36: njf; DR
J37: njf; DR
J38: njf; DR
J39: njf; DR
J40: njf; DR
J41: njf; DR
J42: njf; DR
J43: njf; DR
J44: njf; DR
J45: njf; DR
J46: njf; DR
J47: njf; DR
J48: njf; DR
J49: njf; DR
J50: njf; DR
J51: njf; DR
J52: njf; DR
J53: njf; DR
J54: njf; DR
J55: njf; DR
J56: njf; DR
J57: njf; DR
J58: njf; DR
J59: njf; DR
J60: njf; DR
J61: njf; DR
J62: njf; DR
J63: njf; DR
J64: njf; DR
J65: njf; DR
J66: njf; DR
J67: njf; DR
J68: njf; DR
J69: njf; DR
J70: njf; DR
J71: njf; DR
J72: njf; DR
J73: njf; DR
J74: njf; DR
J75: njf; DR
J76: njf; DR
J77: njf; DR
J78: njf; DR
J79: njf; DR
J80: njf; DR
J81: njf; DR
J82: njf; DR
J83: njf; DR
J84: njf; DR
J85: njf; DR
J86: njf; DR
J87: njf; DR
J88: njf; DR
J89: njf; DR
J90: njf; DR
J91: njf; DR
J92: njf; DR
J93: njf; DR
J94: njf; DR
J95: njf; DR
J96: njf; DR
J97: njf; DR
J98: njf; DR
J99: njf; DR
J100: njf; DR
J101: njf; DR
J102: njf; DR
J103: njf; DR
J104: njf; DR
J105: njf; DR
J106: njf; DR
J107: njf; DR
J108: njf; DR
J109: njf; DR
J110: njf; DR
J111: njf; DR
J112: njf; DR
J113: njf; DR
J114: njf; DR
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
R188: res; 4.5k
Named nets: Level1_Load, !Level1_Load, Level3_Load, !Level3_Load, Level2_Load, !Level2_Load, 0, VDD, VSS, Level1, Level2, Level3, CLK, Shift_Load, !Reset, !Dir, Dir, Shift_Direction, Shift_Loading, Shift_Reset, !Shift_Load, Level0, Startup_Pulse, Stack_Loading, Stack_Load
