cgarryZA/deepJFET/cpus/Scratch Build/stack/Level 1.asc

J0: njf; DR
J1: njf; DR
J2: njf; DR
J3: njf; DR
J4: njf; DR
J5: njf; DR
J6: njf; DR
J7: njf; DR
J8: njf; DR
J9: njf; DR
J10: njf; DR
J11: njf; DR
J12: njf; DR
J13: njf; DR
J14: njf; DR
J15: njf; DR
J16: njf; DR
J17: njf; DR
J18: njf; DR
J19: njf; DR
J20: njf; DR
J21: njf; DR
J22: njf; DR
J23: njf; DR
J24: njf; DR
J25: njf; DR
J26: njf; DR
J27: njf; DR
J28: njf; DR
J29: njf; DR
J30: njf; DR
J31: njf; DR
J32: njf; DR
J33: njf; DR
J34: njf; DR
J35: njf; DR
J36: njf; DR
J37: njf; DR
J38: njf; DR
J39: njf; DR
J40: njf; DR
J41: njf; DR
J42: njf; DR
J43: njf; DR
J44: njf; DR
J45: njf; DR
J46: njf; DR
J47: njf; DR
J48: njf; DR
J49: njf; DR
J50: njf; DR
J51: njf; DR
J52: njf; DR
J53: njf; DR
J54: njf; DR
J55: njf; DR
J56: njf; DR
J57: njf; DR
J58: njf; DR
J59: njf; DR
J60: njf; DR
J61: njf; DR
J62: njf; DR
J63: njf; DR
J64: njf; DR
J65: njf; DR
J66: njf; DR
J67: njf; DR
J68: njf; DR
J69: njf; DR
J70: njf; DR
J71: njf; DR
J72: njf; DR
J73: njf; DR
J74: njf; DR
J75: njf; DR
J76: njf; DR
J77: njf; DR
J78: njf; DR
J79: njf; DR
J80: njf; DR
J81: njf; DR
J82: njf; DR
J83: njf; DR
J84: njf; DR
J85: njf; DR
J86: njf; DR
J87: njf; DR
J88: njf; DR
J89: njf; DR
J90: njf; DR
J91: njf; DR
J92: njf; DR
J93: njf; DR
J94: njf; DR
J95: njf; DR
J96: njf; DR
J97: njf; DR
J98: njf; DR
J99: njf; DR
J100: njf; DR
J101: njf; DR
J102: njf; DR
J103: njf; DR
J104: njf; DR
J105: njf; DR
J106: njf; DR
J107: njf; DR
J108: njf; DR
J109: njf; DR
J110: njf; DR
J111: njf; DR
J112: njf; DR
J113: njf; DR
J114: njf; DR
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
R190: res; 1k
R191: res; 4.5k
R192: res; 100k
R193: res; 1k
R194: res; 4.8k
R195: res; 50k
R196: res; 1k
R197: res; 4.5k
R198: res; 100k
R199: res; 1k
R200: res; 4.8k
R201: res; 50k
R202: res; 1k
R203: res; 4.5k
R204: res; 100k
R205: res; 1k
R206: res; 4.8k
R207: res; 50k
R208: res; 1k
R209: res; 4.5k
R210: res; 100k
R211: res; 1k
R212: res; 4.8k
R213: res; 50k
R214: res; 1k
R215: res; 4.5k
Named nets: VDD, VSS, 0, CLK, Level1_Load, !Level1_Load, PC13, PC12, PC10, PC11, S113, S112, S111, S110, PC23, PC22, PC20, PC21, S213, S212, S211, S210, PC33, PC32, PC30, PC31, S313, S312, S311, S310, S1tack3In, S1tack2In, S1tack3, S1tack2, S1tack1, S1tack0, S1tack1In, S1tack0In, S2tack3In, S2tack2In, S2tack3, S2tack2, S2tack1, S2tack0, S2tack1In, S2tack0In, S3tack3In, S3tack2In, S3tack3, S3tack2, S3tack1, S3tack0, S3tack1In, S3tack0In
