cgarryZA/deepJFET/cpus/4004/testbenches/multi_or.asc

J_A1: njf; DR
J_A2: njf; DR
J_A3: njf; DR
J_A4: njf; DR
J_A5: njf; DR
J_A6: njf; DR
J_A7: njf; DR
J_A8: njf; DR
J_A9: njf; DR
J_A10: njf; DR
J_A11: njf; DR
J_A12: njf; DR
J_A13: njf; DR
J_A14: njf; DR
J_A15: njf; DR
J_A16: njf; DR
J_A17: njf; DR
J_A18: njf; DR
J_A19: njf; DR
J_A20: njf; DR
J_A21: njf; DR
J_A22: njf; DR
J_A23: njf; DR
J_A24: njf; DR
J_A25: njf; DR
J_A26: njf; DR
J_A27: njf; DR
J_A28: njf; DR
J_A29: njf; DR
J_A30: njf; DR
J_A31: njf; DR
J_A32: njf; DR
J_A33: njf; DR
J_A34: njf; DR
J_A35: njf; DR
J_A36: njf; DR
J_A37: njf; DR
J_A38: njf; DR
J_A39: njf; DR
J_A40: njf; DR
J_A41: njf; DR
J_A42: njf; DR
J_A43: njf; DR
J_A44: njf; DR
J_A45: njf; DR
J_A46: njf; DR
J_A47: njf; DR
J_A48: njf; DR
J_A49: njf; DR
J_A50: njf; DR
J_A51: njf; DR
J_A52: njf; DR
J_A53: njf; DR
J_A54: njf; DR
J_A55: njf; DR
J_A56: njf; DR
J_A57: njf; DR
J_A58: njf; DR
J_A59: njf; DR
J_A60: njf; DR
J_A61: njf; DR
J_A62: njf; DR
J_A63: njf; DR
J_A64: njf; DR
J_A65: njf; DR
J_A66: njf; DR
J_A67: njf; DR
J_A68: njf; DR
J_A69: njf; DR
J_A70: njf; DR
J_A71: njf; DR
J_A72: njf; DR
J_A73: njf; DR
J_A74: njf; DR
J_A75: njf; DR
J_A76: njf; DR
J_A77: njf; DR
J_A78: njf; DR
J_A79: njf; DR
J_A80: njf; DR
J_A81: njf; DR
R1: res; 50k
R2: res; 1k
R3: res; 4.5k
R4: res; 50k
R5: res; 1k
R6: res; 4.5k
R7: res; 50k
R8: res; 1k
R9: res; 4.5k
R10: res; 50k
R11: res; 1k
R12: res; 4.5k
R13: res; 50k
R14: res; 1k
R15: res; 4.5k
R16: res; 21k
R17: res; 2k
R18: res; 2.8k
R19: res; 50k
R20: res; 1k
R21: res; 4.5k
R22: res; 21k
R23: res; 1.5k
R24: res; 1.5k
R25: res; 50k
R26: res; 1k
R27: res; 4.5k
R28: res; 50k
R29: res; 1k
R30: res; 4.5k
R31: res; 21k
R32: res; 2k
R33: res; 2.8k
R34: res; 21k
R35: res; 1.5k
R36: res; 1.5k
R37: res; 21k
R38: res; 1.5k
R39: res; 1.5k
R40: res; 20k
R41: res; 2k
R42: res; 2.8k
R43: res; 10k
R44: res; 2k
R45: res; 2.8k
R46: res; 10k
R47: res; 2k
R48: res; 2.8k
R49: res; 50k
R50: res; 1k
R51: res; 4.5k
V1: voltage; PULSE(-4 0 10u 0.1u 0.1u 5u 10u 2)
V2: voltage; PULSE(-4 0 10u 0.1u 0.1u 5u 10u 2)
V3: voltage; -4
V4: voltage; PULSE(-4 0 10u 0.1u 0.1u 5u 10u 2)
V5: voltage; 24
V6: voltage; -20
V7: voltage; PULSE(-3.6 -800m 10u 1ns 1ns 5.15us 10us 10000000000000)
V8: voltage; PULSE(-4 0 10u 0.1u 0.1u 5u 10u 2)
V9: voltage; PULSE(-4 0 10u 0.1u 0.1u 5u 10u 2)
V10: voltage; PULSE(-4 0 10u 10n 10n 0.5u 1u 2)
V11: voltage; PULSE(-4 0 10u 0.1u 0.1u 5u 10u 2)
V12: voltage; 10
V13: voltage; PULSE(-4 0 10u 0.1u 0.1u 5u 10u 2)
V14: voltage; -10
V15: voltage; 28
V16: voltage; -7
V17: voltage; PULSE(-4 0 10u 0.1u 0.1u 5u 10u 2)
V18: voltage; 28
V19: voltage; PULSE(-4 0 10u 0.1u 0.1u 5u 10u 2)
V20: voltage; -7
V21: voltage; 10
V22: voltage; -10
V23: voltage; 10
V24: voltage; 28
V25: voltage; -7
V26: voltage; -10
V27: voltage; 10
V28: voltage; -10
V29: voltage; 10
V30: voltage; -10
V31: voltage; PULSE(-4 0 15u 0.1u 0.1u 10u 20u 1)
Named nets: 0, VDD, VSS, CLK, 1, 2, LOW, 3, 4, 5, 6, 11, 21, 100k, 1M, 50k
.tran 0 40us 1ps 0.01
System Parameters
.model DR NJF(Beta=0.135m Betatce=-0.5 Vto=-3.45 Vtotc=-2.5m Lambda=0.005 Is=205.2f Xti=3 Isr=1988f Nr=4 Alpha=20.98u N=3 Rd=1 Rs=1 Cgd=16.9p Cgs=16.9p Fc=0.5 Vk=123.7 M=407m Pb=1 Kf=37860f Af=1 Mfg=Linear_Systems)
.options NoOpIter
