cgarryZA/deepJFET/(commit log)

2026-04-07 Restructure project: blocks library, CPU scaffold, composable build system
    - Move optimization/analysis code to isolated optimization/ folder
    - Remove static/ (contents relocated to optimization/)
    - Add blocks/ library: DFF, register, mux, decoder with tiling
    - Add cpus/4004/ scaffold with all sub-circuit .asc files
    - Add tools: new_cpu, open_ltspice, gen_ltspice, build_cpu
    - Add 4004 ISA decoder + program analyzer for minimal builds
    - Composable sub-component system (scratchpad pairs, stack levels)
    - Remove tracked __pycache__, .db files; add .gitignore
    - Add CLAUDE.md, STATUS.md, /open slash command
2026-04-08 Composable scratchpad: build from individual pair + bus sub-parts
    - Scratchpad split into sub-components: Pair 1-8, Bus1, Bus2, Controls
    - Build tool assembles only needed parts based on program analysis
    - Per-file renaming to handle overlapping names across sub-parts
    - Old monolithic scratchpad kept as scratchpad_old.asc for reference
    - Remove old pre-built scratchpad size variants (scratchpads/ folder)
    - Update config.py with group dependency system (Bus1 for pairs 1-4, etc.)
2026-04-08 ROM emulator: PWL-driven CPU simulation verified against real ROM
    - ROM emulator (tools/rom_emulator.py): assembles 4004 programs, simulates
    PC progression, generates PWL files for D0In-D3In to replace physical ROM
    - Per-instruction micro-phase counts from schematic analysis (6-12 phases)
    - 5us ROMCLK lead time for JFET propagation delay
    - Verified against Load5.raw reference: 94.3% match (5 bus timing samples
    differ by ~5us at phase boundaries, all register values correct)
    - Composable stack: Controls + Bus + Level 1/2/3 sub-parts
    - Fixed duplicate components in scratchpad/Bus1.asc
    - WINDOW Invisible on all components across all .asc files
    - Renumbered scratchpad and stack sub-files to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
2026-04-10 Fix SUB carry inversion bug, add debug/analysis tools, simplified CPU microcode optimization
    4004 bug fix:
    - Remove CF_INV from SUB micro-instructions (carry should NOT be inverted for SUB)
    - SUB now correctly computes ACC + ~Rn + CY (not ACC + ~Rn + ~CY)
    - Tied removed JFET gates to ground to preserve circuit topology
    Debug & analysis tools:
    - reg_viewer.py: upgraded with clock-cycle-accurate expected values, HW vs Exp columns,
    red mismatch highlighting, IR opcode decode, decimal IR2
    - extract_signals.py: extract subset of signals from 60GB+ .raw files
    - smooth_raw.py: average per CLK cycle for clean digital readings
    - verify_hw_ops.py: verify each instruction's effect from hardware trac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
    [micro_instructions.csv]
2026-05-16 repo: cleanup for publication-readiness
    - Add top-level README.md as repo entry point
    - Tighten .gitignore: LaTeX intermediates, sqlite WAL/shm, per-program
    .raw and Machine.{bin,hex}, claude session state, worktrees
    - Move 22 exploratory / FloatingPoint-debug scripts to tools/legacy/
    with a README documenting why each was retired
    - Move stray top-level Multi-Or.asc into cpus/4004/testbenches/
    - Move original MEng FYP PDF into paper/precedent/
    - Delete stale STATUS.md (content folded into the new README)
    - Add cpus/tileable/README.md and cpus/simplified/README.md to
    explain their work-in-progress / experimental status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
2026-05-16 4004: schematic fixes from FloatingPoint bring-up
    - alu.asc: SUMCF booster added to fix marginal carry-out signal
    - micro_instructions.asc: CMC redesigned without inversion-driven logic
    (used bus-based load instead). RAL/RAR rotate-IN of CY paths fixed
    (Temp0In/Temp3In routes from CF). EO_Out no longer triggers CFStage1
    relatch race
    - scratchpad/Pair 3.asc: rename 5PMux1 -> 5SPMux1 (typo broke R5 bit 1)
    - d{0..3}in.pwl: regenerated from corrected ROM emulator timing
    All eight ADD edge cases in AdderTest now pass; FloatingPoint produces
    the correct R12:R13=0x98 product and R14:R15=0x62 exponent.
2026-05-16 tools: paper reproducibility pipeline, IDE, instruction verifier
    New, paper-reproducibility-flow tools:
    - count_transistors.py: per-subsystem JFET/resistor count, emits
    paper/data/transistor_count.{csv,tex,_macros.tex}
    - derive_expected_state.py: runs CPU4004Sim to produce per-program
    expected_state.yaml so verifiers have a reference
    - gen_freq_testbench.py / gen_sensitivity_testbench.py: corner-sweep
    .cir generators for f_max and R1/R2/R3 noise-margin studies
    - analyze_ltspice_log.py: parses LTspice .log into paper/data CSVs
    - build_supplement.py: builds supplement.zip + MANIFEST.csv with
    SHA-256 per file for Zenodo upload
    - place_netlist.py: lays out generator-emitted .net files fo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
2026-05-16 programs: AdderTest (carry edge cases) and BitwiseAND
    AdderTest:
    Eight ADD operations chosen to exercise every CLA carry-out path
    (G3-overflow, full carry chain, Cin-only, missing-P0 path,
    the original 0+8+0 false-carry case). Each test stores ACC and
    CY into a dedicated register pair so final scratchpad state
    verifies the full SUMCF logic.
    BitwiseAND:
    Manual two-operand AND subroutine from the MCS-4 manual,
    serving as a paper-headline register-level diff target on the
    shorter end of the program complexity spectrum.
    Ships with expected_state.yaml in the new derive_expected_state
    format so verify_micro5 / trace_synced have a reference state.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
2026-05-16 paper: manuscript draft and reproducibility infrastructure
    Paper directory:
    - Main.tex (master variant) + Main_JXCDC.tex (compressed variant)
    - body.tex shared between variants via \ifjxcdc switching
    - Appendices.tex + AppendixB.tex + AppendixC.tex + Appendices/ figures
    - supplementary/{AppendixA,AppendixD,AppendixD2,cpu_design_details}.tex
    - IEEEtran.{cls,bst} for journal styling; beamerthemeDurham.sty
    - preamble.tex with shared macros, build.py for one-command rebuild,
    regen_data.py for paper/data/*.{csv,tex} regeneration
    - reproducibility/README.md as canonical entry point + MANIFEST.csv
    - LICENSE-CC-BY-4.0 (CC-BY for manuscript text and figures)
    - CITATION.cff and .zenodo.json metadata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
    [MANIFEST.csv, transistor_count.csv]
2026-05-16 cpus: simplified microcode variant + tileable RV32I progress
    cpus/simplified/:
    Microcode-optimised 4004 variant intended for the paper's
    before/after JFET-count comparison. Identical to cpus/4004/ except
    for alu.asc, micro_instructions.asc, and the regenerated PWLs.
    README explains its experimental status.
    cpus/tileable/:
    Work-in-progress RV32I implementation built from parameterised
    tileable bit-slices. Generator outputs landed in generated/ over
    the past weeks (registers, ALU, decoder, instruction register).
    README documents that this is not part of the published paper and
    serves as the seed of a planned follow-up.
    Also gitignores the auto-generated 138 MB rv32i_full te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
    [micro_instructions.csv]
2026-05-16 tools: board-level subassembly workflow (board.py)
    Adds a single-file 4-subcommand tool that lets us validate an
    individual 4004 subsystem on its own — either as a standalone LTspice
    simulation or as a physical PCB driven by an AWG / pattern generator,
    using boundary PWLs captured from a full-CPU reference run.
    Subcommands:
    board.py list Enumerate subsystems and show their
    auto-detected boundary nets
    board.py extract <subsys> Pull boundary-net waveforms from a
    full-CPU .raw, write one PWL per input
    (boards/<subsys>/inputs/) and one per
    o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
2026-05-17 programs: Fibonacci — first 8 Fibonacci numbers in scratchpad
    Straight-line 4-bit Fibonacci that computes F(0) through F(7) and
    stores each in its own scratchpad register (R0..R7 = 0,1,1,2,3,5,8,D).
    Exercises a long chain of CLC + LD + ADD + XCH × 6 across 8 registers
    with the whole sequence visible in the final CPU state.
    Adds JMS/BBL stack push/pop coverage on a short program (compared to
    the longer BitwiseAND that also exercises ISZ looping). 34 bytes of
    ROM, 26 instructions, ~294 cycles to halt.
2026-05-17 emulator: 4002 RAM model + PWL bus drive on RAM-read instructions
    Extends the PWL workflow so 4004 programs can address off-CPU RAM
    without a 4002 chip on the schematic — the emulator stands in for the
    4002 and drives D0In..D3In with the right nibble at the right time
    during RDM/RDx/ADM/SBM/RDR cycles. The CPU side of the RAM bus
    microcode gets fully exercised without committing to a 4002 in JFETs.
    New tools/ram4002.py:
    - RAMState models 8 banks × 4 chips × 4 registers × (16 main +
    4 status) characters, plus 4-bit RAM output ports and 16 ROM
    chip ports
    - src_latch(high, low) captures (chip, register, character) plus
    rom_chip from the SRC byte; persists until next SRC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
2026-06-04 Refresh 4004 sim outputs (PWL/asm) + paper draft updates
    Simulation input waveforms (d*in.pwl) regenerated, BitwiseAND/RAMTest asm
    tweaks, config.py, and paper/ updates (Main.pdf, body.tex, transistor_count
    data). Snapshot before machine migration.
    [trace_diff_FloatingPoint.csv, transistor_count.csv]
